nmaiti/smartswitchboard/README.md

# smartswitchboard

This repo contains all capsense design files
