nmaiti/smartswitchboard/Hardware/8ModuleBoard_vr2/Gerber Data/Transcode Report.txt

   ---- Transcoding 'F:\Honey Bee's\smartswitchboard\Hardware\8ModuleBoard_vr2\Gerber Data\8ModuleBoard_vr2.plc' ----   Fri Jun 24 12:41:39 2016

D10   --> D100
D11   --> D101
D12   --> D102
D13   --> D103
D14   --> D104
D15   --> D105
D16   --> D106
D17   --> D107
D18   --> D108
D19   --> D109
D20   --> D110
D21   --> D111
D22   --> D112
D23   --> D113
D24   --> D114
D25   --> D115
D26   --> D116
D27   --> D117
D28   --> D118
D29   --> D119
D30   --> D120
D31   --> D121
D32   --> D122
D33   --> D123
D34   --> D124
D35   --> D125
-----------------------------------------------------------------

   ---- Transcoding 'F:\Honey Bee's\smartswitchboard\Hardware\8ModuleBoard_vr2\Gerber Data\8ModuleBoard_vr2.pls' ----   Fri Jun 24 12:41:39 2016

D10   --> D126
D11   --> D127
D12   --> D128
D13   --> D129
D14   --> D130
D15   --> D131
D16   --> D132
D17   --> D133
D18   --> D134
D19   --> D135
D20   --> D136
-----------------------------------------------------------------

   ---- Transcoding 'F:\Honey Bee's\smartswitchboard\Hardware\8ModuleBoard_vr2\Gerber Data\8ModuleBoard_vr2.sol' ----   Fri Jun 24 12:41:39 2016

D17   --> D137
D18   --> D138
D19   --> D139
D20   --> D140
D21   --> D141
D22   --> D142
D23   --> D143
D24   --> D144
D25   --> D145
D26   --> D146
D27   --> D147
D28   --> D148
D29   --> D149
D30   --> D150
D31   --> D151
D32   --> D152
D33   --> D153
D34   --> D154
D35   --> D155
D36   --> D156
D37   --> D157
D38   --> D158
D39   --> D159
D40   --> D160
D42   --> D161
D43   --> D162
D44   --> D163
D45   --> D164
D47   --> D165
D48   --> D166
D50   --> D167
-----------------------------------------------------------------

   ---- Transcoding 'F:\Honey Bee's\smartswitchboard\Hardware\8ModuleBoard_vr2\Gerber Data\8ModuleBoard_vr2.stc' ----   Fri Jun 24 12:41:39 2016

D10   --> D168
D11   --> D169
D12   --> D170
D13   --> D171
D14   --> D172
D15   --> D173
D16   --> D174
D17   --> D175
D18   --> D176
D19   --> D177
D20   --> D178
D21   --> D179
D22   --> D180
D23   --> D181
D24   --> D182
D25   --> D183
D26   --> D184
D27   --> D185
D28   --> D186
D29   --> D187
D30   --> D188
D31   --> D189
D32   --> D190
D33   --> D191
D34   --> D192
D35   --> D193
D36   --> D194
D37   --> D195
D38   --> D196
D39   --> D197
D40   --> D198
D41   --> D199
D42   --> D200
-----------------------------------------------------------------

   ---- Transcoding 'F:\Honey Bee's\smartswitchboard\Hardware\8ModuleBoard_vr2\Gerber Data\8ModuleBoard_vr2.sts' ----   Fri Jun 24 12:41:39 2016

D10   --> D201
D11   --> D202
D12   --> D203
D13   --> D204
D14   --> D205
D15   --> D206
D16   --> D207
D17   --> D208
D18   --> D209
D19   --> D210
D20   --> D211
D21   --> D212
D22   --> D213
D23   --> D214
D24   --> D215
D25   --> D216
D26   --> D217
D27   --> D218
D28   --> D219
D29   --> D220
D30   --> D221
D31   --> D222
D32   --> D223
D33   --> D224
D34   --> D225
D35   --> D226
D36   --> D227
D37   --> D228
D38   --> D229
D39   --> D230
D40   --> D231
-----------------------------------------------------------------
