nmaiti/smartswitchboard/Hardware/BLE Certifications/CE-HM-10-11-V1.8.1.pdf

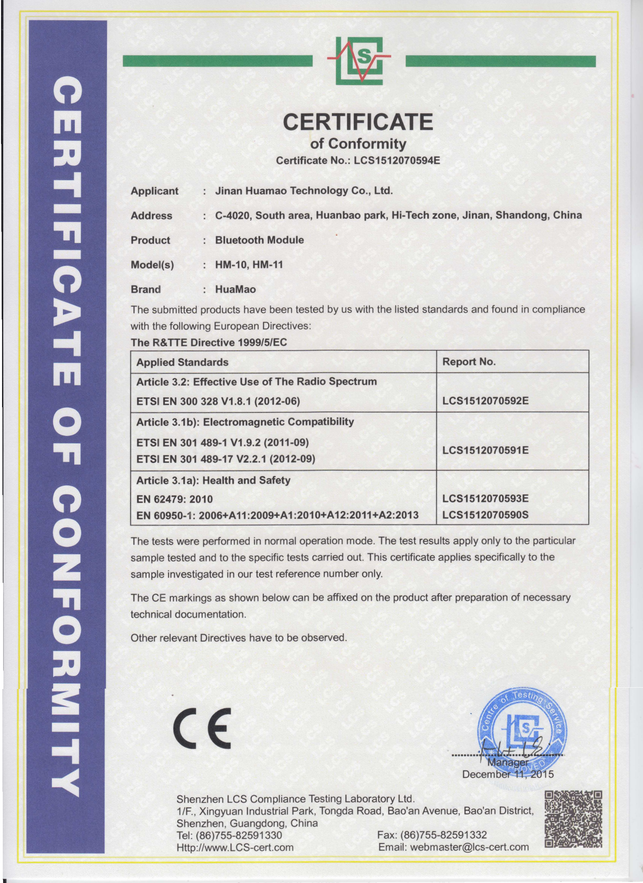
[picture p1: page 1]
