nmaiti/smartswitchboard/Hardware/BLE Certifications/CE-HM-12-13-V1.8.1.pdf

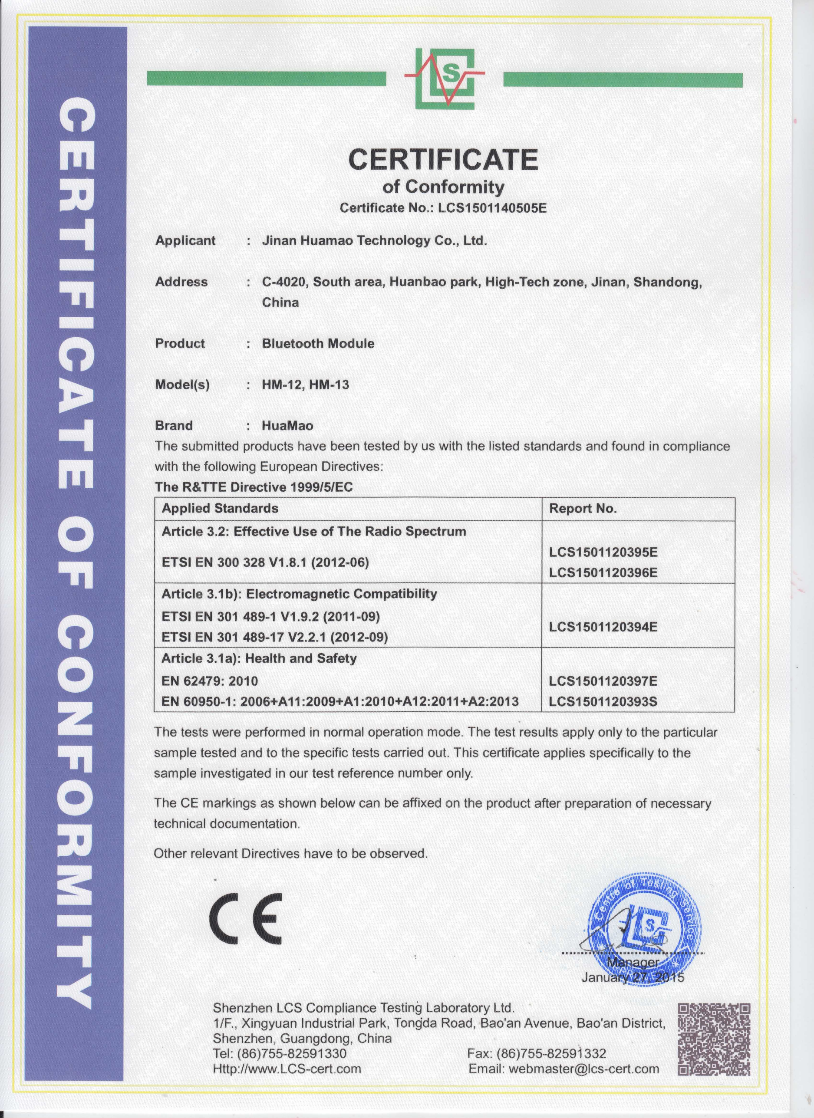
[picture p2: page 1]
