nmaiti/smartswitchboard/Hardware/BLE Certifications/RoHS_LCS1404180666S.pdf

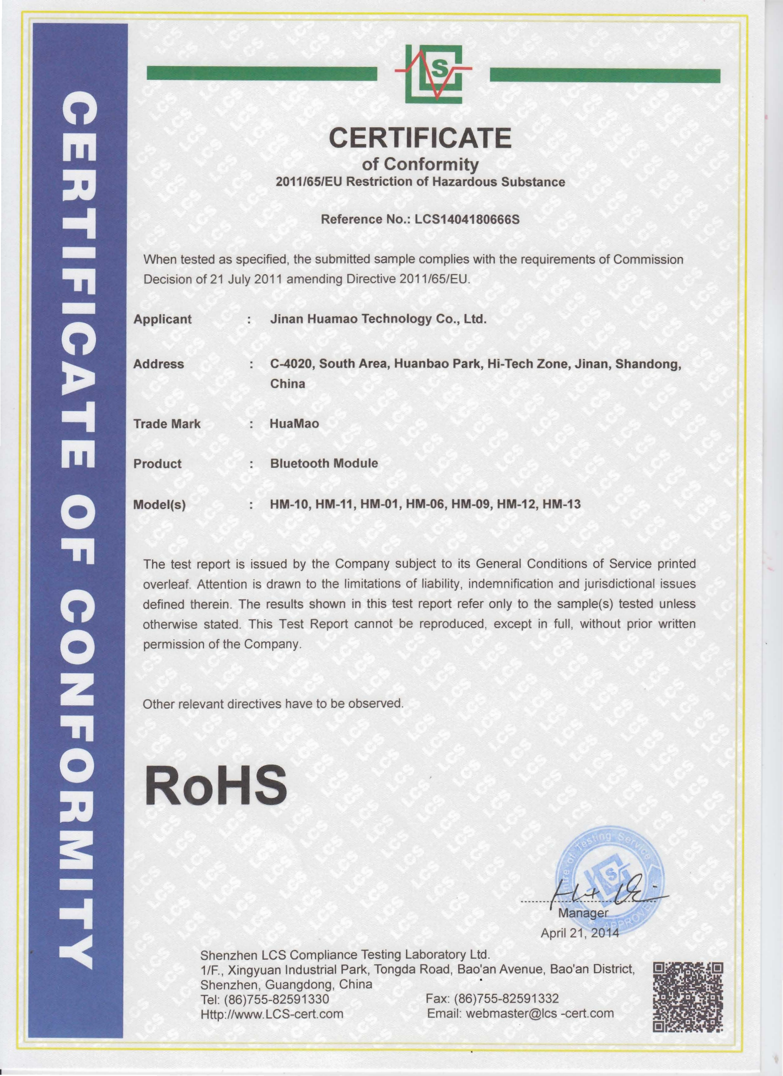
[picture p3: page 1]
