nmaiti/smartswitchboard/Hardware/BLE Certifications/CE-HM-10-11-V1.7.1.pdf

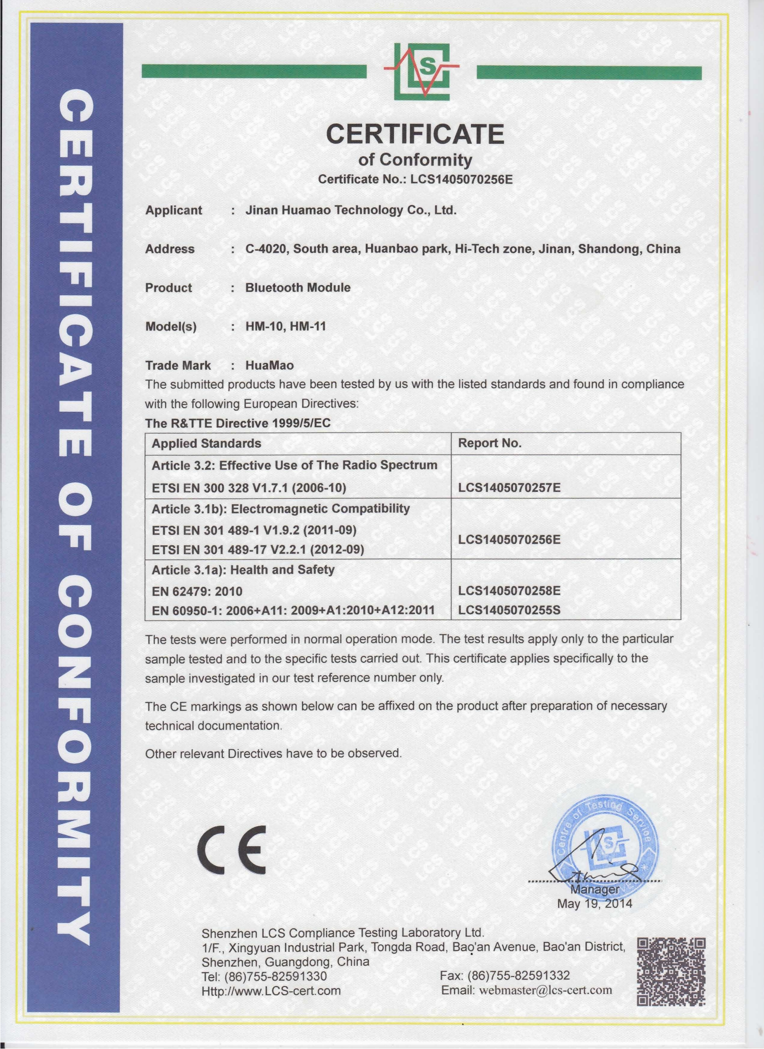
[picture p4: page 1]
