nmaiti/smartswitchboard/Hardware/8ModuleRealyProtoBoard/protoimg.png

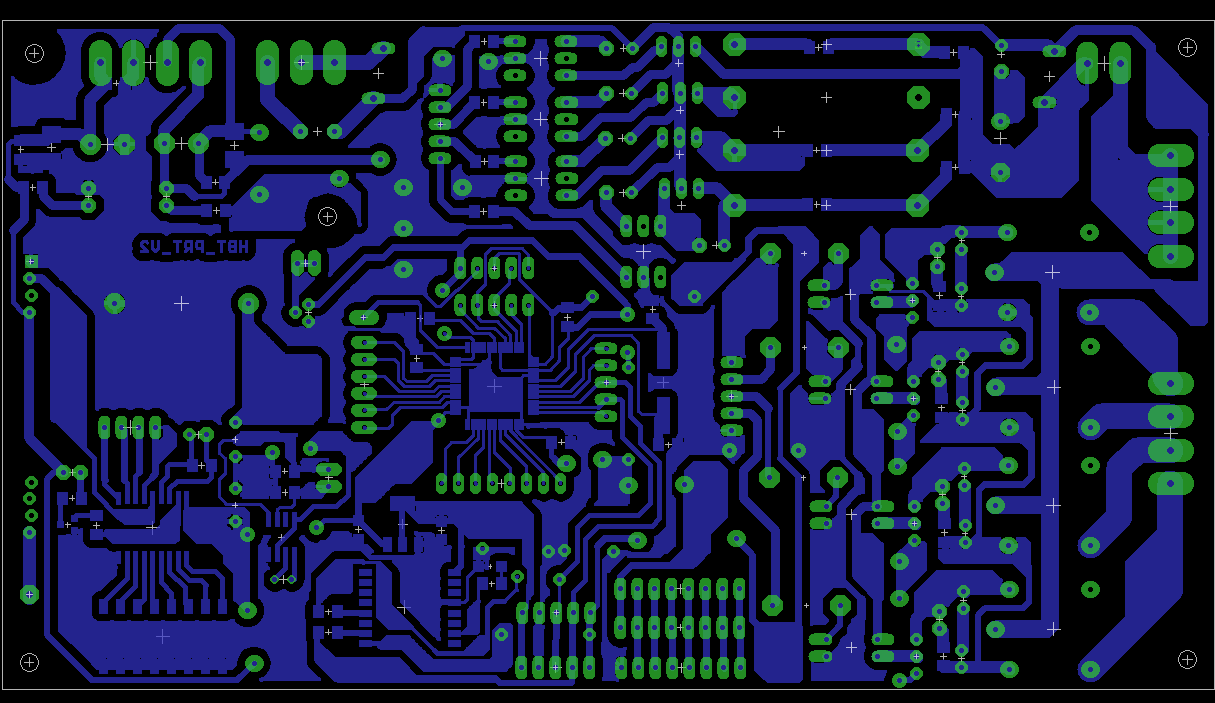
Hardware/8ModuleRealyProtoBoard/protoimg.png
