nmaiti/smartswitchboard/Hardware/Pi_MCU_Shield/pi3_gpio.png

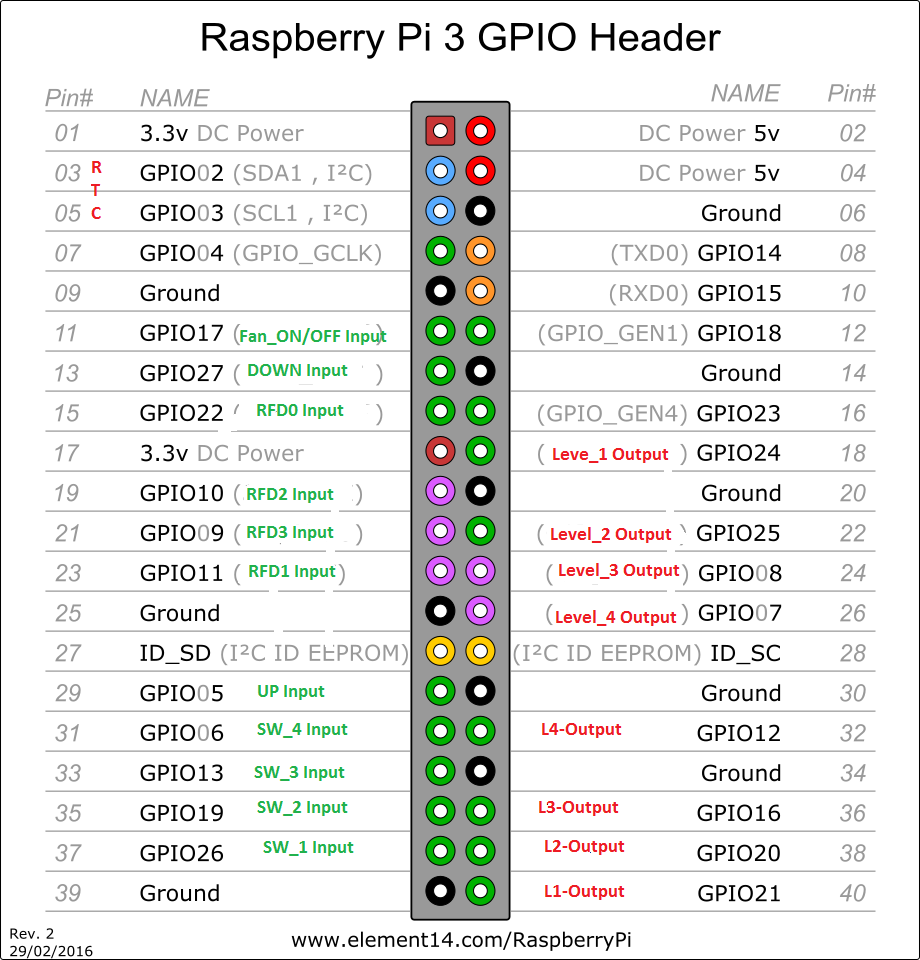
Hardware/Pi_MCU_Shield/pi3_gpio.png
