nmaiti/smartswitchboard/Hardware/Pi_MCU_Shield/Gerber Data/PiMCU_Shield_PurchaseOrder.docx

Purchase order

Contact Person : Vikas D. Gaikwad

Contact No : 08983537961

Email : vksgaikwad3@gmail.com

Purchase Order No: 09

PCB Name : PiMCU_Shield

Mask Color : Blue

No of Layers : Double Sided (2 Layer)

Dimensions of PCB : 58.76 mm X 42.33mm

Quantity : 5 Pcs

I am Vikas Gaikwad, on 11 July 2016, releasing the PCB purchase order to Circuit Systems India Ltd.
