nmaiti/smartswitchboard/Hardware/SMPS_Details/SMPS_BOM.xlsx

Sheet: BOM
 |  |  |  | Honey Bees Technologies
 | Project: | 5V @700mA and 12V @800mA SMPS
 | Design By: | K.S. Phulphagare (Wavelines)
 | Charges: | 8000/
 | Bill of Materials of SMPS
Sr.No | Part No | Value | Type | Quantity | Descriptions | Contact Person | Contact No | Vendor | Cost
1 | C1 | 0.1 OR 0.22uF/275VAC | X-Capacitor | 1
2 | C2 | 22uF/400 OR 450V | Electroytic | 1 |  |  |  | TrioElectronics | 10
3 | C3
4 | C4 | 4.7nF/1kV | Ceramic | 1
5 | C5 | 47uF/50V | Electroytic | 1 |  |  |  | Trio Electronics | 2
6 | C6 | 1uF/50V | Electroytic | 1 |  |  |  | Trio Electronics | 2
7 | C7 | 47uF/50V | Electroytic | 1 |  |  |  | Trio Electronics | 2
8 | C8 | 0.1uF/50V | Ceramic | 1 |  |  |  | In Stock
9 | C9 | 470uF/16V | Electroytic | 1 |  |  |  | Trio Electronics | 10
10 | C10 | 1000 OR 2200 uF/16V | Electroytic | 1 |  |  |  | Trio Electronics | 25
11 | C11 | 1000 uF/25V | Electroytic | 1 |  |  |  | Trio Electronics | 15
12 | C12 | 470uF/25V | Electroytic | 1 |  |  |  | In Stock
13 | C13 | 2.2nF/1kV | Ceramic | 1
14 | D1 | UF4007 | Diode(TH) | 1 |  |  |  | Tri Electronics | 1
15 | D2 | 1N4148 | Diode(TH) | 1 |  |  |  | Tri Electronics | 1
16 | D3 | 1N5822 | Diode(TH) | 1 | Shokly Diode
17 | D4 | MUR420 | Diode(TH) | 1 | Fast Recovery Diode
18 | SMD Bridge | DDF105 | SMD Bridge | 1 | 1A SMD Bridge
19 | TOP244Y OR 245Y |  | Top Switch IC | 1 |  | Rajiv,Pioneer,Turnwal Electronics |  | Pioneer Electronics | 75
20 | PC817 | OptoIsolator | SMD package | 1 |  | Rajiv |  | Tro Electronics | 10
21 | TL431 |  | 3-Pin IC(Transistor) | 1 |  | Rajiv
22 | R1 | 4.7MOhm | Resistor | 1 |  |  |  | Trio Electronics | 1
23 | R2 | 9.1KOhm | SMD | 1
24 | R3 | 1MOhm | SMD | 1
25 | R4 | 1MOhm | SMD | 1
26 | R5 | 68K | TH | 1 |  |  |  | Trio Electronics | 2
27 | R6 | 6.8Ohm | SMD | 1
28 | R7
29 | R8
30 | R9 | 9.1KOhm | SMD | 1
31 | R10 | 9.1KOhm | SMD | 1
32 | CMR | 5uH 10.5VCore | 32 SWG copper wire | 1 | CMR transformer
33 | L1 | 10uH | 10X12 Drum(28-SWG) | 1 |  |  |  | Varsha Electronics | 3
34 | L2 | 3.3uH | 6X8 Drum (28-SWG) | 1 |  |  |  | Varsha Electronics | 2
35 | NTC | 5Ohm/9mm | NTC | 1
36 | MOV | 7mm/275V | MOV | 1
37 | Heat Sink with Nut bolts and Mica |  |  | 1 |  | Jewel Enterprises | Soba Market near Pasoda vithoba Mandir
38 | PCB | 60X40 MM |  | 1
39 | Glue
40 | Transformer Design Details: |  |  |  |  | Inductrionicx | 9226564727(Paithankar)
 |  |  |  | Start Pin | End Pin
 | Primary Coil Inductance | 495uH
 |  | 56 Turns (30-SWG) |  | 2 | 1
 | Secondary
 | 5V Coil | 4 Turns (26-SWG) |  | 6 | 5
 | 12V Coil | 8 Turns (26-SWG) |  | 8 | 7
 | Feedback Coil
 | 7 Turns (30SWG) |  |  | 4 | 3
 | Core Size:
 |  | E25/9/16
 | Note: Please note that Starting points are very important while designing a Transformer
 | Note: Here 1pcs of SMPS cost aproximately around 240

Sheet: Sources
 |  |  |  | Honey Bees Technologies
Sr. No | Name | Contact | Address | Type of Compontnts
1 | Rajiv Electronics | 020 24494150/020 24477218 |  | Resistors, Capacitors, Optocouplers, TL431
2 | UniStar Enterprise |  |  | Resistors, Capacitors, Optocouplers, TL431
3 | Trinity |  |  | Resistors, Capacitors, Optocouplers, TL431
4 | Turnwal Electronics |  |  | Resistors, Capacitors, Optocouplers, TL431
5 | Pioneer Electronics |  |  | Resistors, Capacitors, Optocouplers, TL431
6 | Jewel Enterprises |  | Soba Market (Near Pasoda Vithoba Mandir) | Heat Sink
7 | Bhosale |  | Kharadi | PCB design
8 | Varsha Electronics | 9422084984 | InFront of Pioneer Electronics
9 | UniStar Enterprise | 020 24480647 | DakshinMukhi Maruti Samor, Dusra Majala, near Prabhat Tockies
10 | Inductronicx | 9226564727(Paithankar) | Gavkos Maruti Javal, Kasba peth, near Kamala nehuru hospital | Inductors and Transformers
11 | Trinity | 020 24490156 | Soba Market ,Near Pasoda Vithoba Mandir, First Floor
12 | Turnwal Electronics | 020 24463819 | Near AhilyaDevi High school neighbour road
13 | Pioneer Electronics | 020 24495336/020 24458257 | near pasoda vithoba mandir ABC
