nmaiti/smartswitchboard/Hardware/BOM/CompInStock.xlsx

 |  |  | Honey Bees Technologies
Sr.No | Part Name | Device Value | Package | In Stock | Available Quantity | Approx. Cost(Rs.)
 |  |  |  |  |  | (Mumbai) | Rajiv Elec. | IPC Pune
1 | Resistors | 560R | TH | Yes | 100 | 0.5 | 0.5 | 0.25
 |  | 470R | TH | Yes | 95 | 0.5 | 0.5 | 0.25
 |  | 33E/1W | TH | Yes | 100 |  |  | 1
 |  | 39E/2W | TH | Yes | 50 |  |  | 2
 |  | 4K7 | Arry | Yes | 50 |  |  | 2
 |  | 22E | 1206 | Yes | 98 | 0.25 | 0.5 | 0.25
 |  | 470E | 1206 | Yes | 90 | 0.25 | 0.5 | 0.25
 |  | 1K | 1206 | Yes | 90 | 0.25 | 0.5 | 0.25
 |  | 10K | 1206 | Yes | 90 | 0.25 | 0.5 | 0.25
 |  | 220R | 1206 | Yes | 100 |  |  | 0.25
 |  | 2.2E | 1206 | Yes | 100 |  |  | 0.25
 |  | 560R | 1206 | Yes | 100 |  |  | 0.25
 |  | 22K | 1206 | Yes | 100 |  |  | 0.25
 |  | 220K | 1206 | Yes | 100 |  |  | 0.25
2 | Capacitors | 0.1uF | 1206 | Yes | 95 | 1 | 1
 |  | 1uF | 1206 | Yes | 95 | 1 | 2
 |  | 10uF(Tantalum) | 1206 | Yes | 95 | 1 | 2
 |  | 18pF | 1206 | Yes | 98 | 1 | 1
 |  | 0.01uF/400V | PTH | Yes | 20 |  |  | 3
 |  | 220nF/250V~ | PTH | Yes | 30 |  |  | 4.5
 |  | 10uF/35V (Tantalum) | 3216 | Yes | 100 |  |  | 7
 |  | 470uF/25V | PTH | Yes | 50 |  |  | 3.5
 |  | 2.2uF/63V | PTH | Yes | 50 |  |  | 0.7
3 | Triac | BTB16 | TO220 | Yes | 19 | 21 | 26 | 28
4 | MOV | 300V | TH | Yes | 20 | 5 | 7
5 | Opto-Isolator | MOC3083 | DIP | Yes | 19 | 18 | 20
 |  | MOC3023 | DIP | Yes | 20 |  |  | 11.5
 |  | 4N35 | DIP | Yes | 20 |  |  | 5.5
6 | IR Receiver | PNA460XM | TSOP | Yes | 9 | 20 | 25
7 | 3.3V Regulator | LM1117 | SOT-23-5 | Yes | 9 | 5
8 | Crystal | 16MHz | HC49UP | Yes | 9 | 8 | 8
9 | LEDs | Red | 1206 | Yes | 99 | 2 | 2
 |  | Green | 1206 | Yes | 95 | 2 | 4
 |  | Blue | 1206 | Yes | 99 | 2 | 2
10 | Microcontroller | Atmega32u4 | TQFP | Yes | 7 | 250
11 | Deki Capacitors
 |  | 1uF/250VAC |  | Yes | 4 | 5.33 |  | 5
 |  | 2.2uF/250VAC |  | Yes | 4 | 5.33 |  | 6
 |  | 3.3uF/250VAC |  | Yes | 4 | 5.33 |  | 7
12 | Micro-USB B |  |  | Yes | 1 | 40 | 25
 | USB-A Female |  |  | Yes | 10 |  |  | 25
13 | Bluetooth Module | HM-11 |  | Yes | 1 | 420
14 | Concealed Boxes | 4-Module |  | Yes | 1 | 46.5
 |  | 6-Module |  | Yes | 1 | 63
 |  | 8/9-Module |  | Yes | 1 | 82.5
 |  | 8-Module Square |  | Yes | 1 | 82.5
 |  | 12-Module |  | Yes | 1 | 101.5
 |  | 18-Module Square |  | Yes | 1 | 120
15 | PBT Connectors
 |  | 2-Pin | Regular | Yes | 50 |  |  | 6.6
 |  | 3-Pin | Regular | Yes | 10 |  |  | 9.5
 |  | 2-Pin | Right Angle | Yes | 10 |  |  | 9
16 | Power Supply | 5V/2A | (EDR) Adapter | Yes | 3 | 190
17 | PolyFuse | 1A/60V | PTH | Yes | 10 |  |  | 12
18 | MOSFET | IRF840 |  | Yes | 20 |  |  | 22
19 | Diode
 |  | 1N4007 | PTH | Yes | 100 |  |  | 0.5
 |  | BZX55C | 10V Zener | Yes | 20 |  |  | 0.75
 |  | DB107 | Diode Rectifier | Yes | 30 |  |  | 5.5
 |  | SMBJ8.2 |  | Yes | 10 |  | 9
20 | Reliment Connectors
 |  | 3-Pin (F) | Both Female | Yes | 30 |  |  | 7.2
 |  | 5-Pin (F) | Both Female | Yes | 30 |  |  | 12
 |  | 8-Pin (F) | Both Female | Yes | 30 |  |  | 17.3
 |  | 3-Pin (M) |  | Yes | 60 |  |  | 1.1
 |  | 5-Pin (M) |  | Yes | 60 |  |  | 1.8
 |  | 8-Pin (M) |  | Yes | 60 |  |  | 2.9
21
