nmaiti/smartswitchboard/Hardware/8ModuleRealyProtoBoard/autocadview.dxf

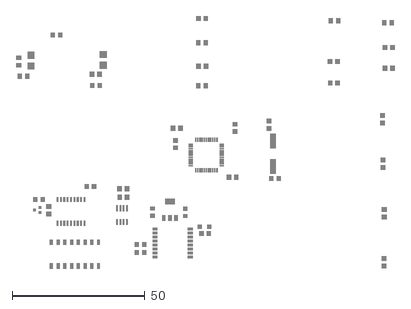
[picture p8: CAD file, 2016-08-19]
Hardware/8ModuleRealyProtoBoard/autocadview.dxf
142.7 x 95.3
