nmaiti/smartswitchboard/Hardware/4Key1SliderCapsenseDesign/4key1SliderCapsenseDesign.pdf

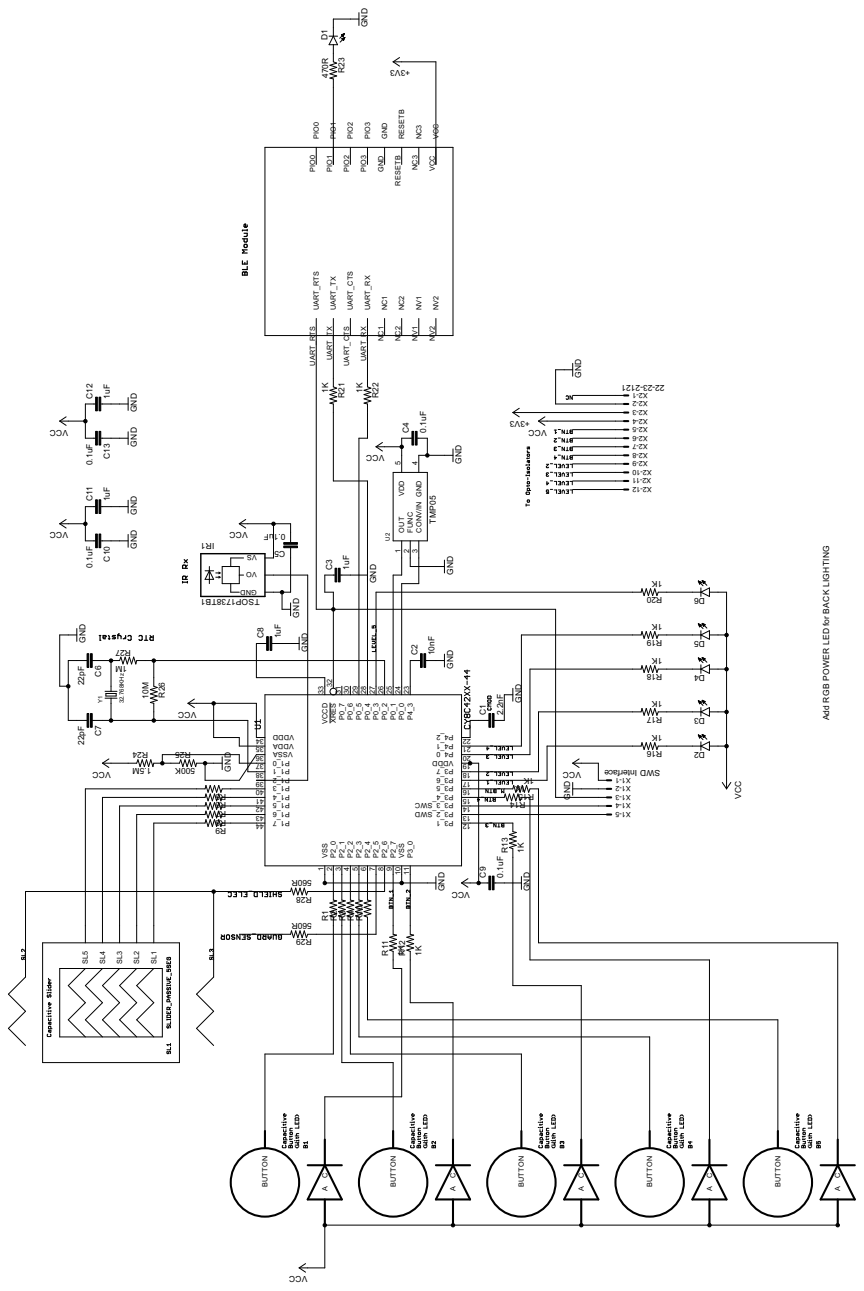
[picture p9: page 1]

NC3 NC3 RESETB RESETB GND GND

0.1uF GND GND GND GND

WER LED for BACK LIGHTING
