nmaiti/smartswitchboard/Hardware/Pi_MCU_Backend/pi_mcu_powerBoard.pdf

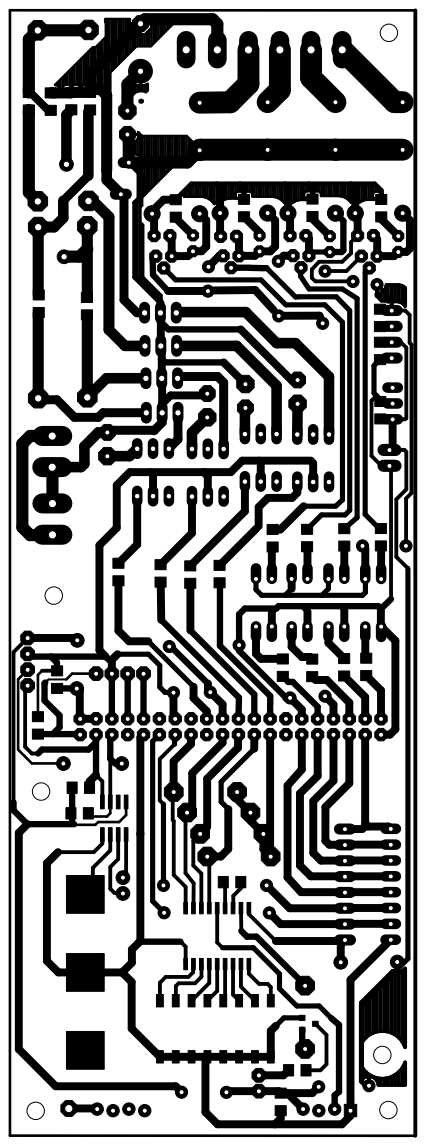
[picture p10: page 1]
