nmaiti/smartswitchboard/Hardware/Pi_MCU_Backend/pi_mcu_powerBoard1.pdf

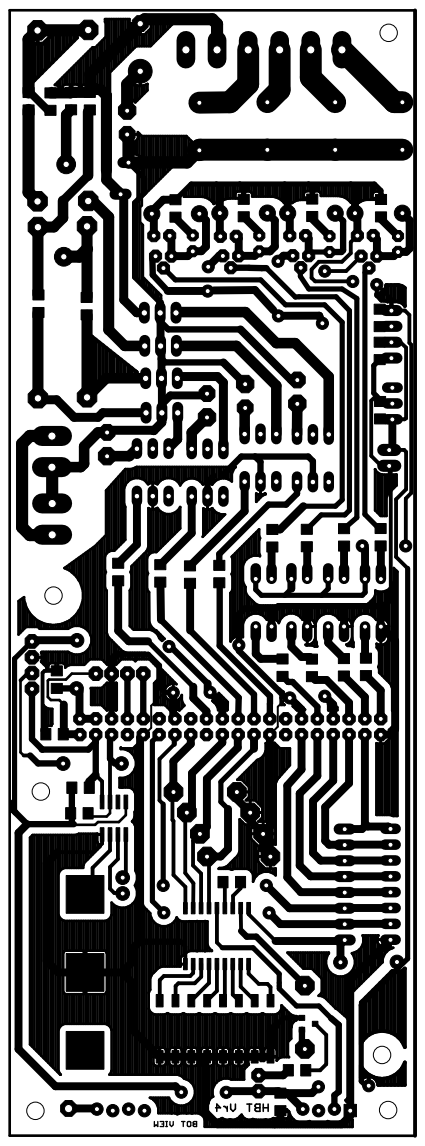
[picture p11: page 1]
