nmaiti/smartswitchboard/Hardware/Pi_MCU_Backend/backend_main.pdf

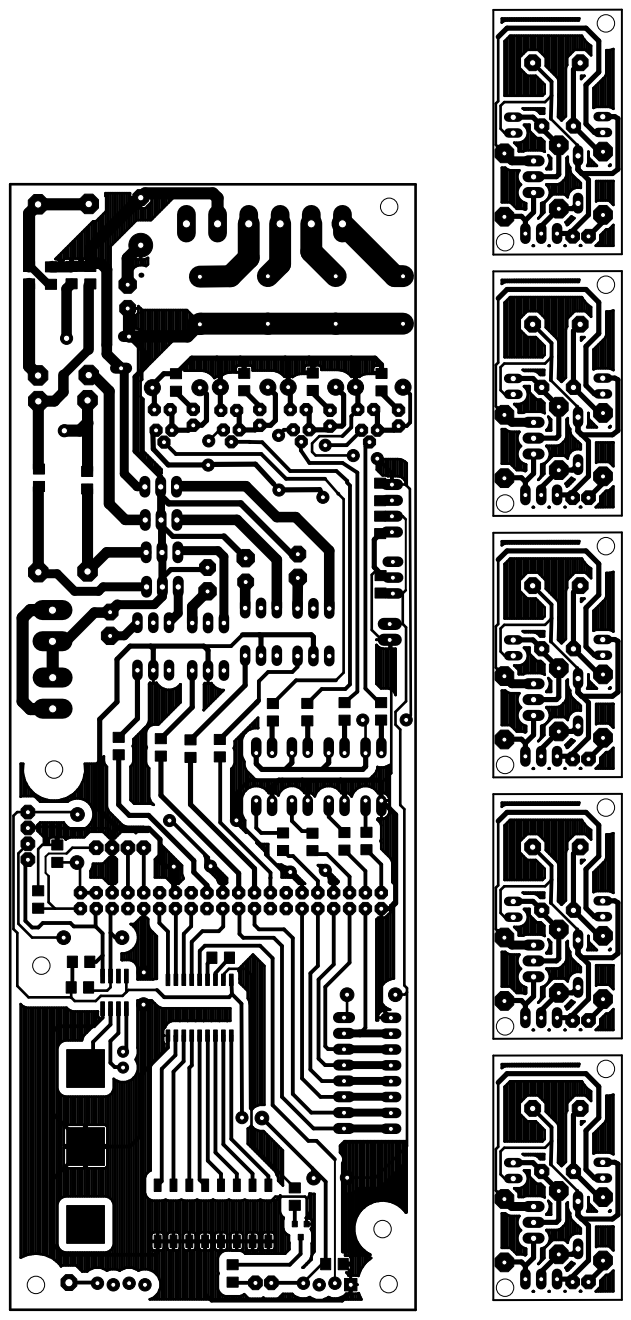
[picture p12: page 1]
