nmaiti/smartswitchboard/Hardware/Pi_MCU_Backend/pi_mcu_powerOutline.pdf

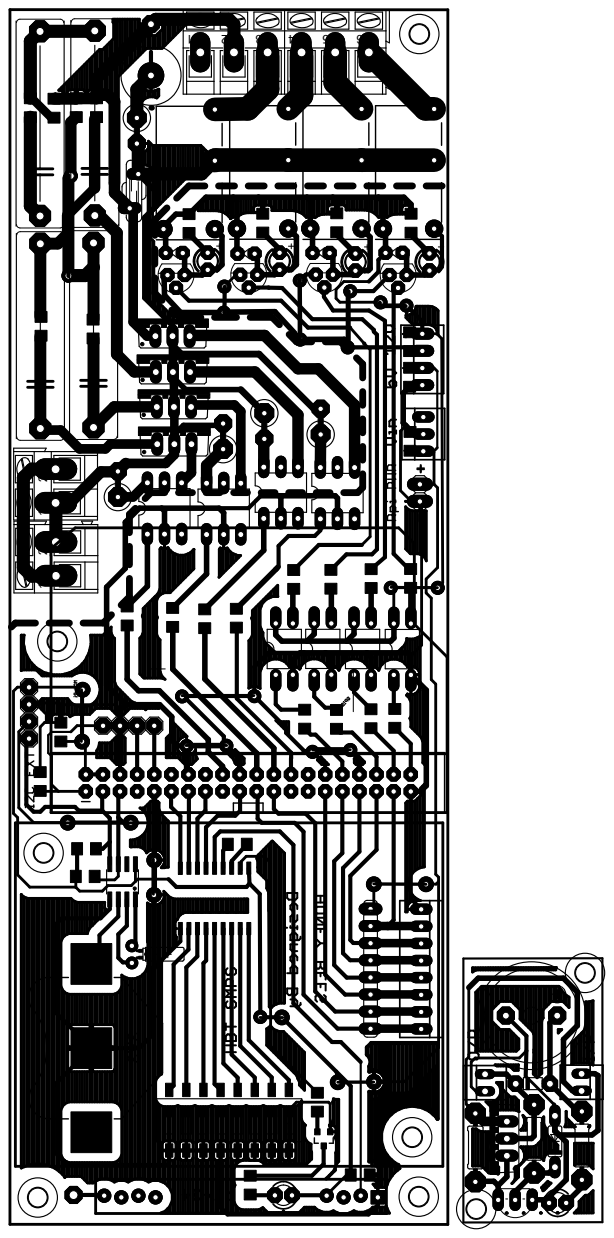
[picture p13: page 1]
