nmaiti/smartswitchboard/Hardware/8ModuleRealyProtoBoard/Layout_centerV2.pdf

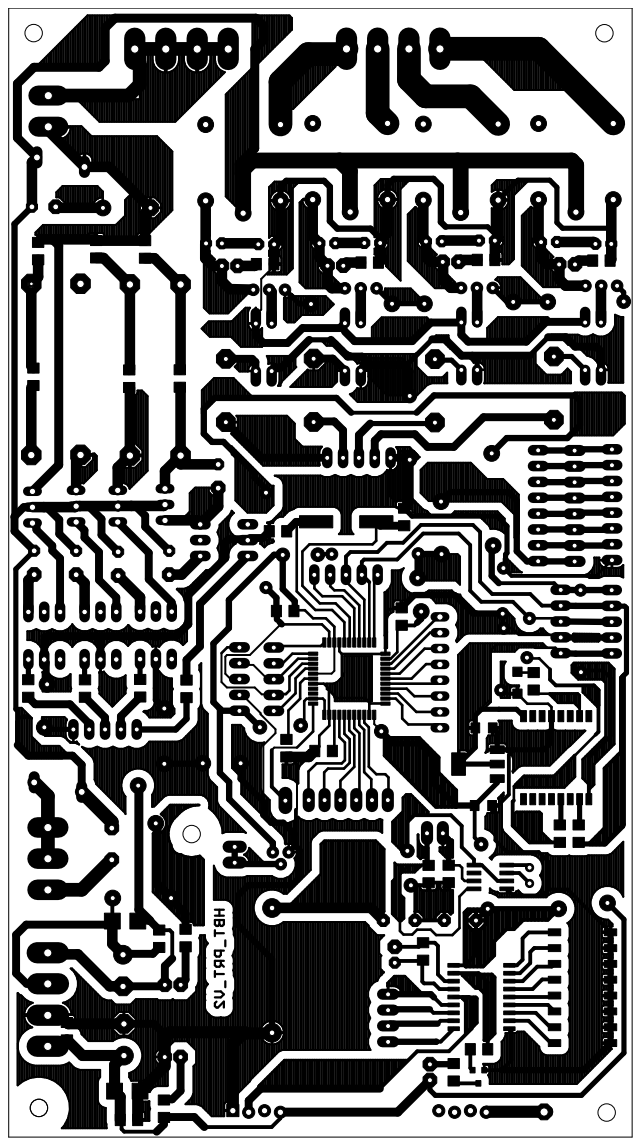
[picture p14: page 1]
