nmaiti/smartswitchboard/Hardware/8ModuleRealyProtoBoard/Layout_protoV2.pdf

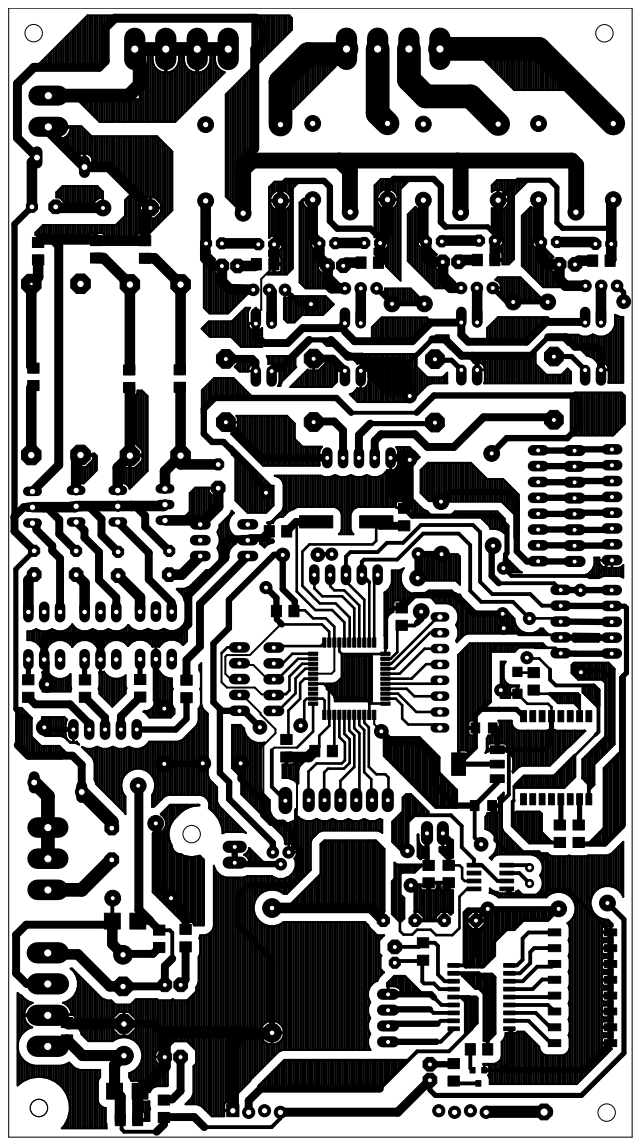
[picture p15: page 1]
