nmaiti/smartswitchboard/Hardware/8ModuleRealyProtoBoard/protoLayout.pdf

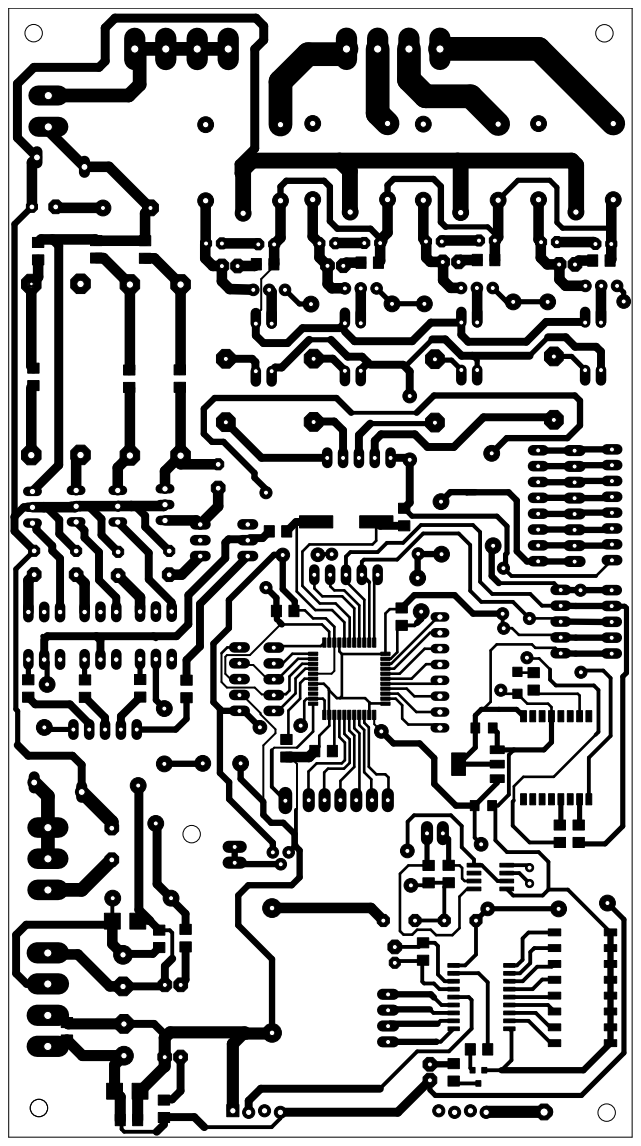
[picture p16: page 1]
