nmaiti/smartswitchboard/Hardware/8ModuleRealyProtoBoard/protoSilk.pdf

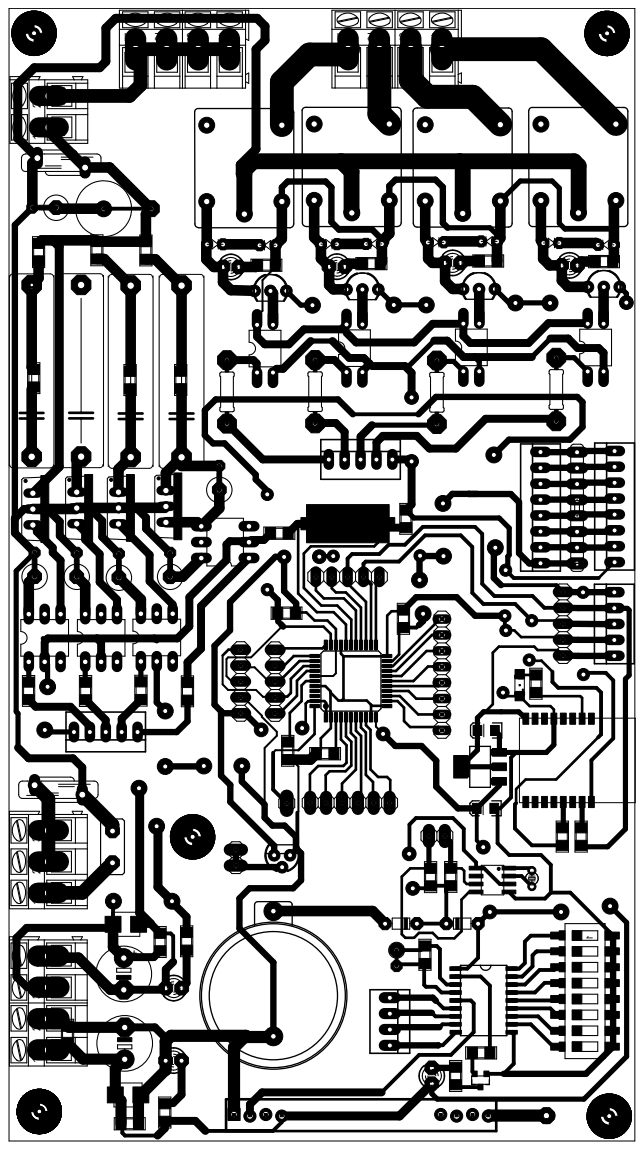
[picture p17: page 1]
