nmaiti/smartswitchboard/Hardware/BLE Certifications/FCC Grant_2AB6YHM-1011.pdf

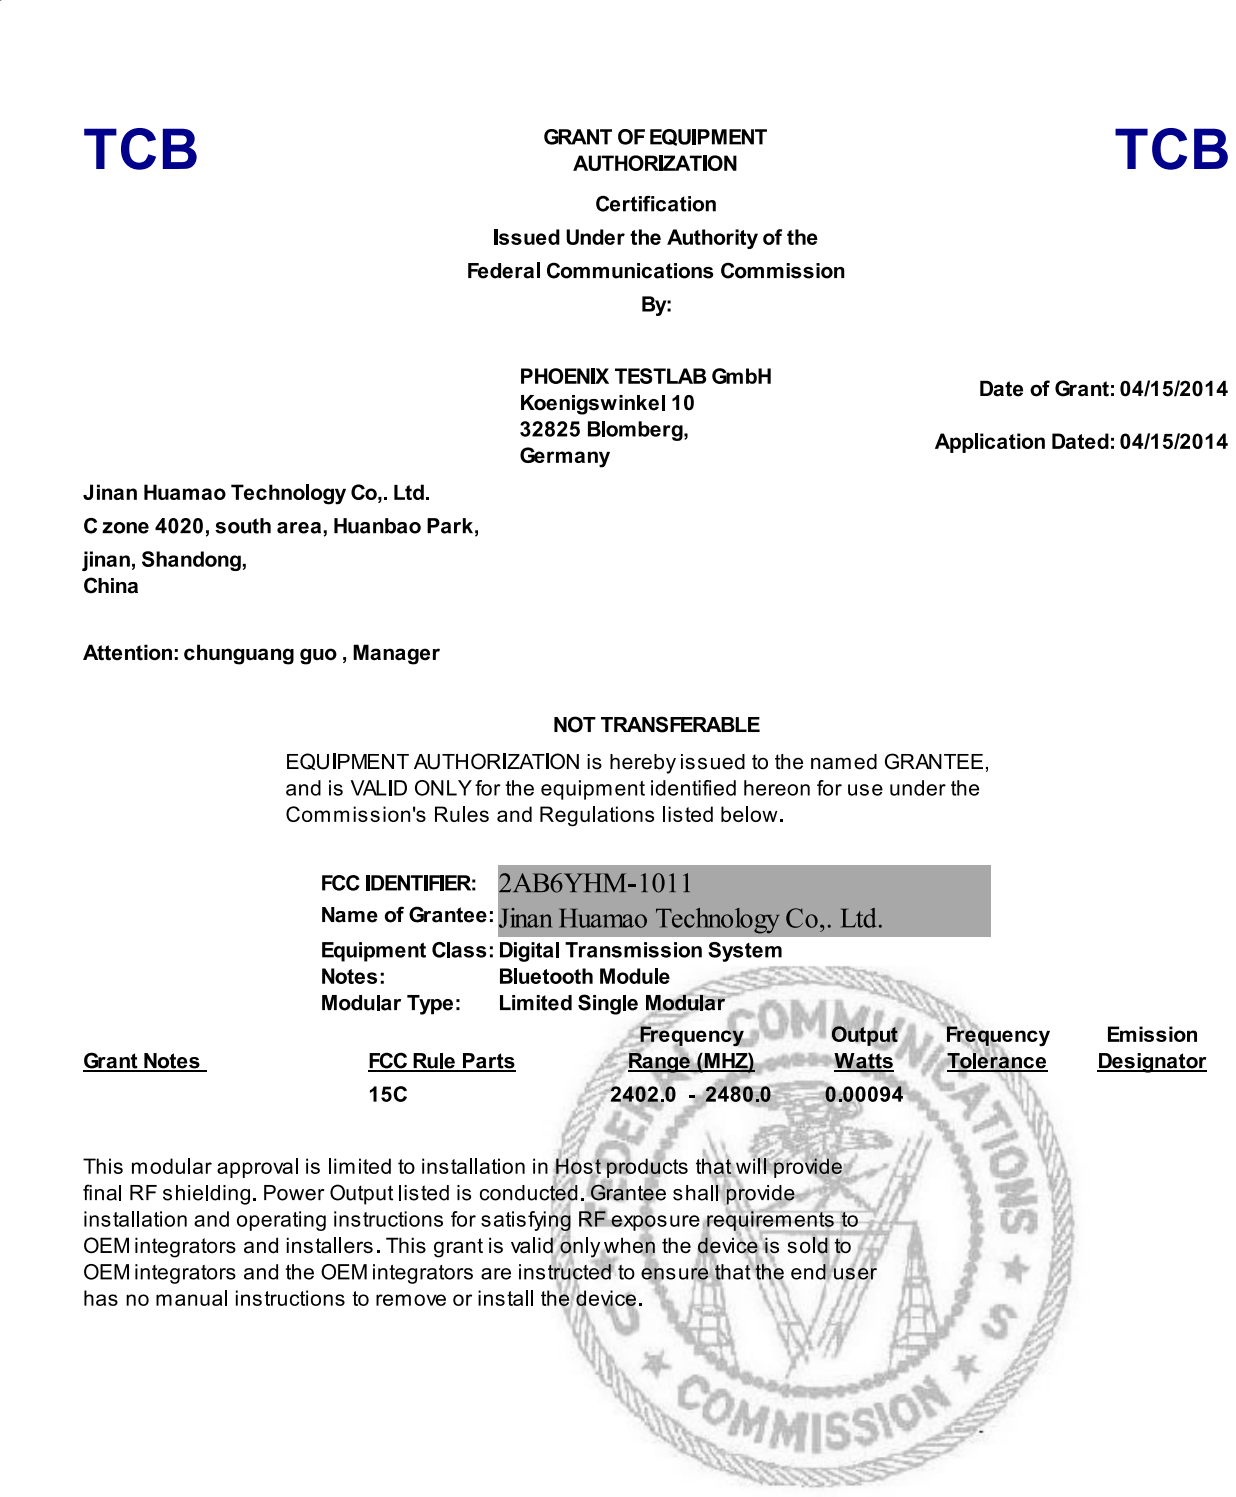
[picture p18: page 1]
