nmaiti/smartswitchboard/Hardware/8ModuleBoard_vr2/8ModuleBoard_vr2.pdf

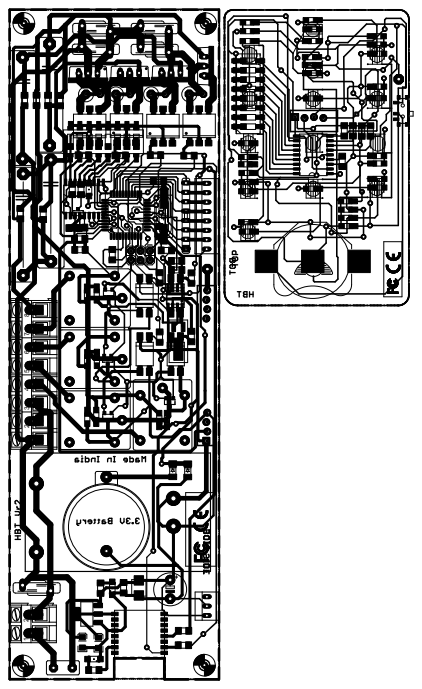
[picture p19: page 1]
