nmaiti/smartswitchboard/Hardware/8ModuleBoard_vr2/footprint.pdf

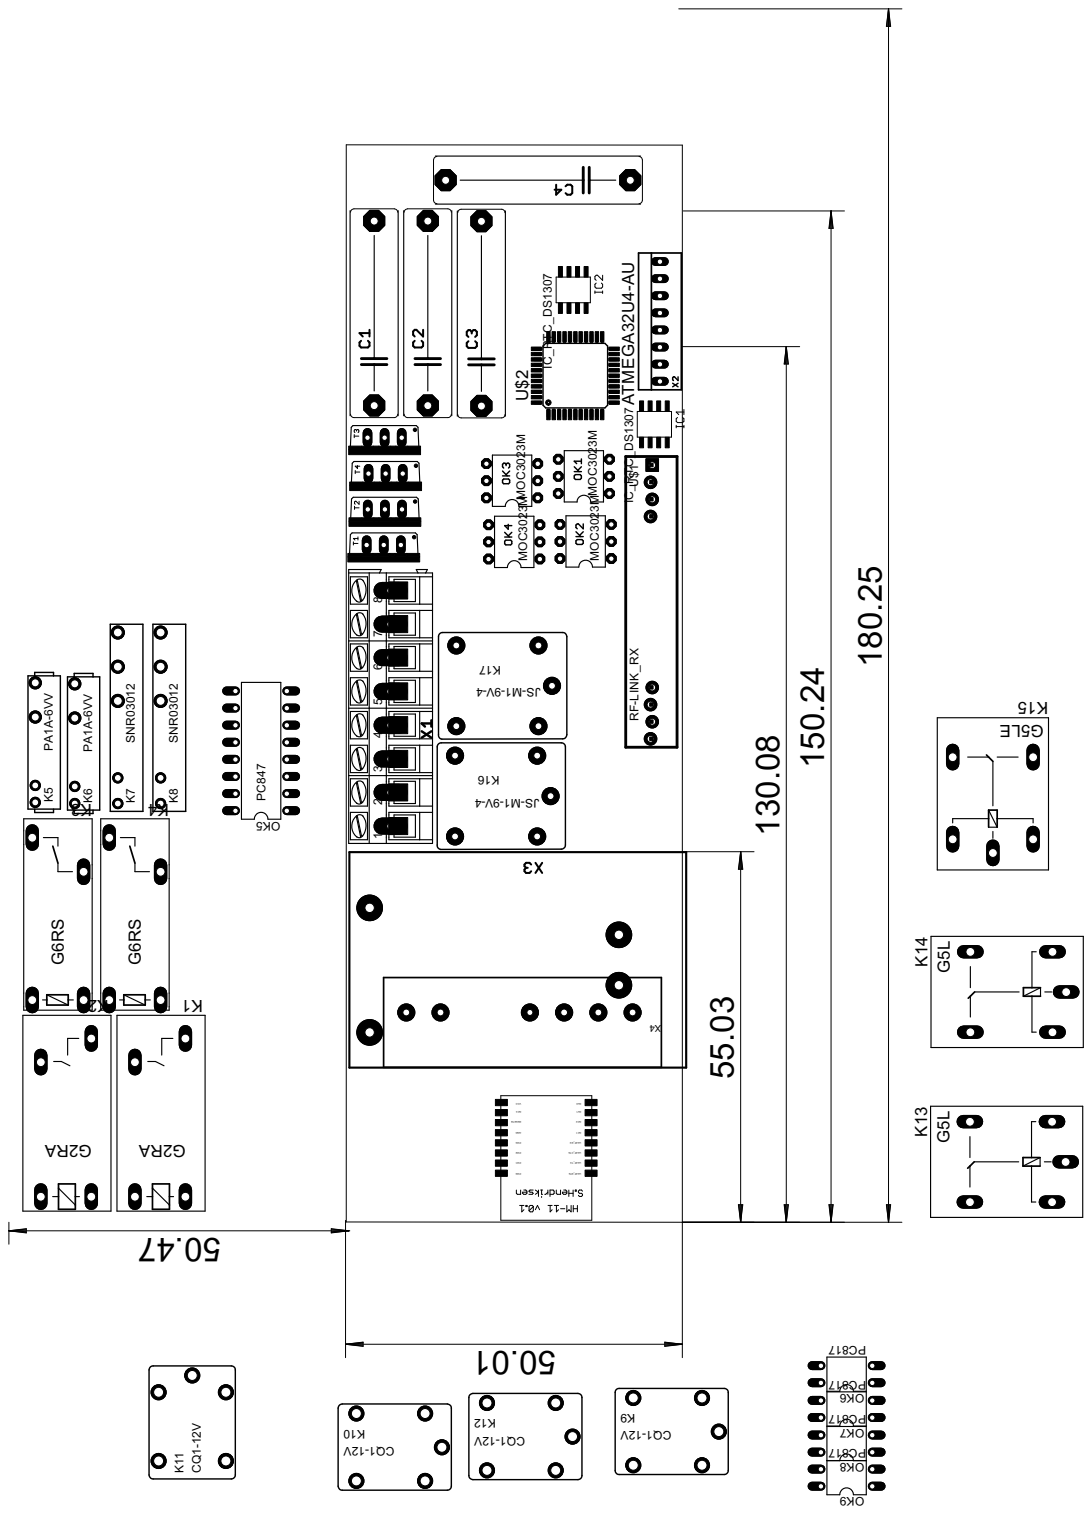
[picture p20: page 1]

1 2 3 4 5 6 7 8 2K 1K K3K 4K 5 K6K7K8 9K 01K K11 21K U$1 U$2 XT_TRAU STR_TRAU ST C_TRAU XR_TRAU 1 CN 2 CN 1 VN CCV 2 VN 3 CN BTESER DNG 3 OI P 2 OI P 1 OI P 0 OI P 5KO 6KO 7KO 8KO 9KO 4X IC_RTC_DS1307 IC_RTC_DS1307 K13 K14 51K 61K 71K AR2 G AR2 G G6RS G6RS PA1A-6VV PA1A-6VV SNR03012 SNR03012 V21- 1 QC V21- 1 QC CQ1-12VV21- 1 QC RF-LINK_RX ATMEGA32U4-AU MOC3023M MOC3023 MM OC3023M MOC3023M PC847 718 CP 718 CP 718 CP 718 CP G5L G5L EL5 G 4- V9- 1 M- SJ 4- V9- 1 M- SJ 74. 05 130.08 10. 05 55.03 150.24180.25
