nmaiti/smartswitchboard/Hardware/LedflikerremoverCct/ledflikerless.pdf

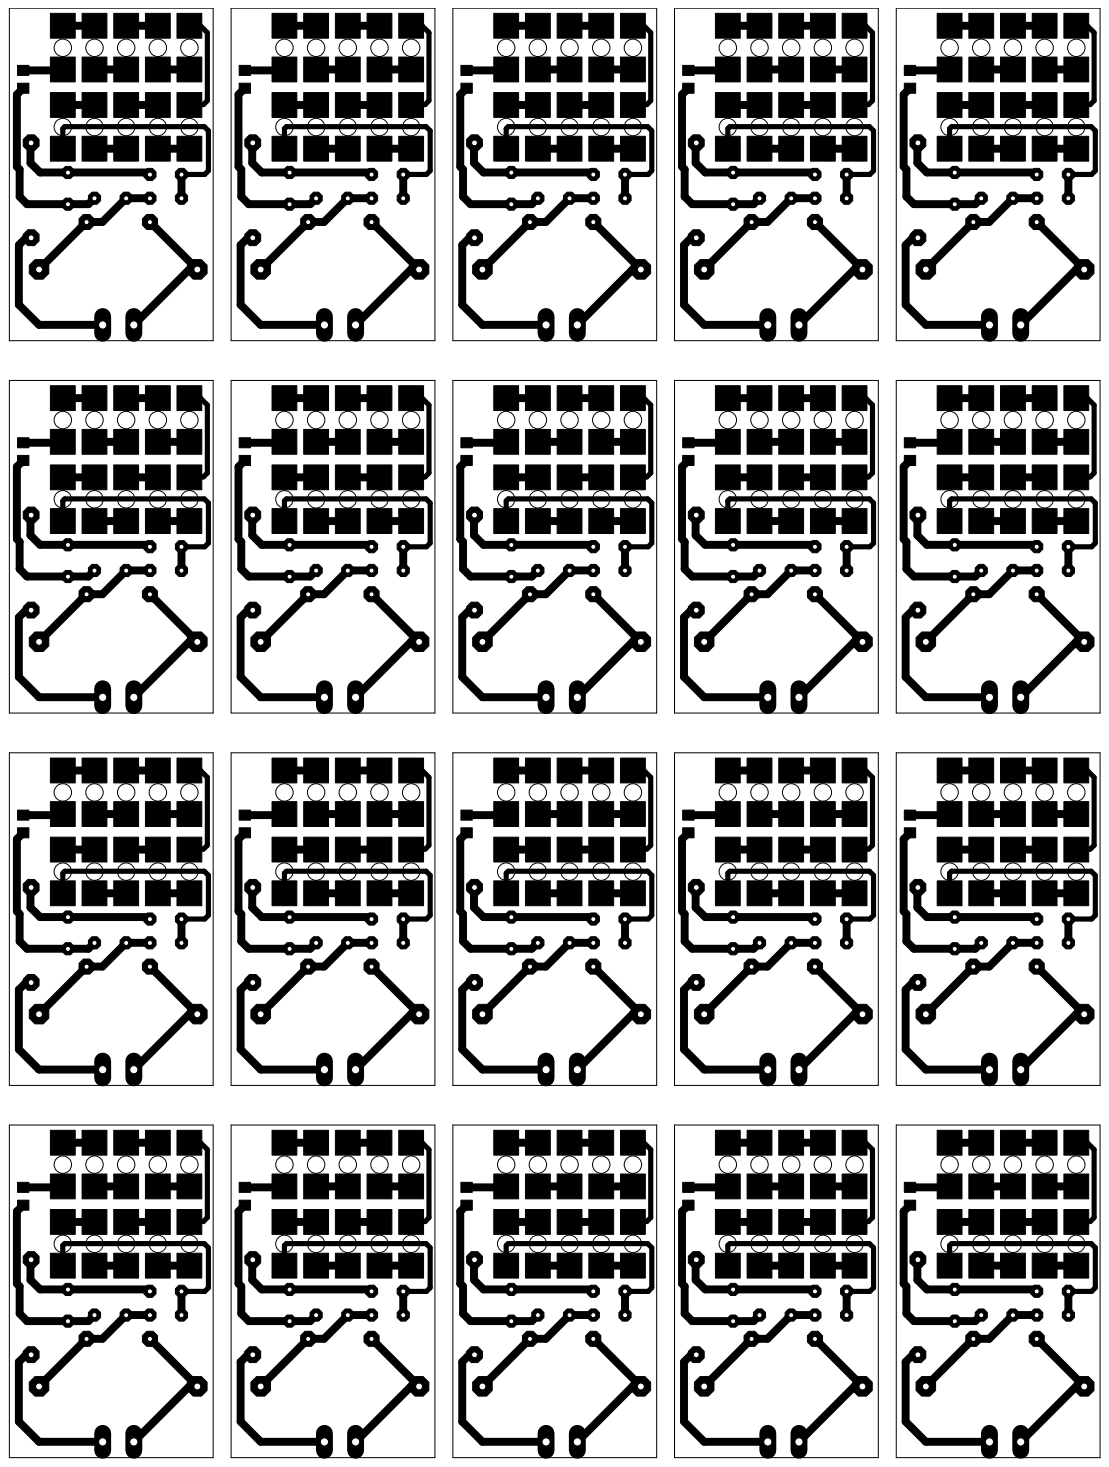
[picture p21: page 1]
