nmaiti/smartswitchboard/Hardware/RF434/hRemote.pdf

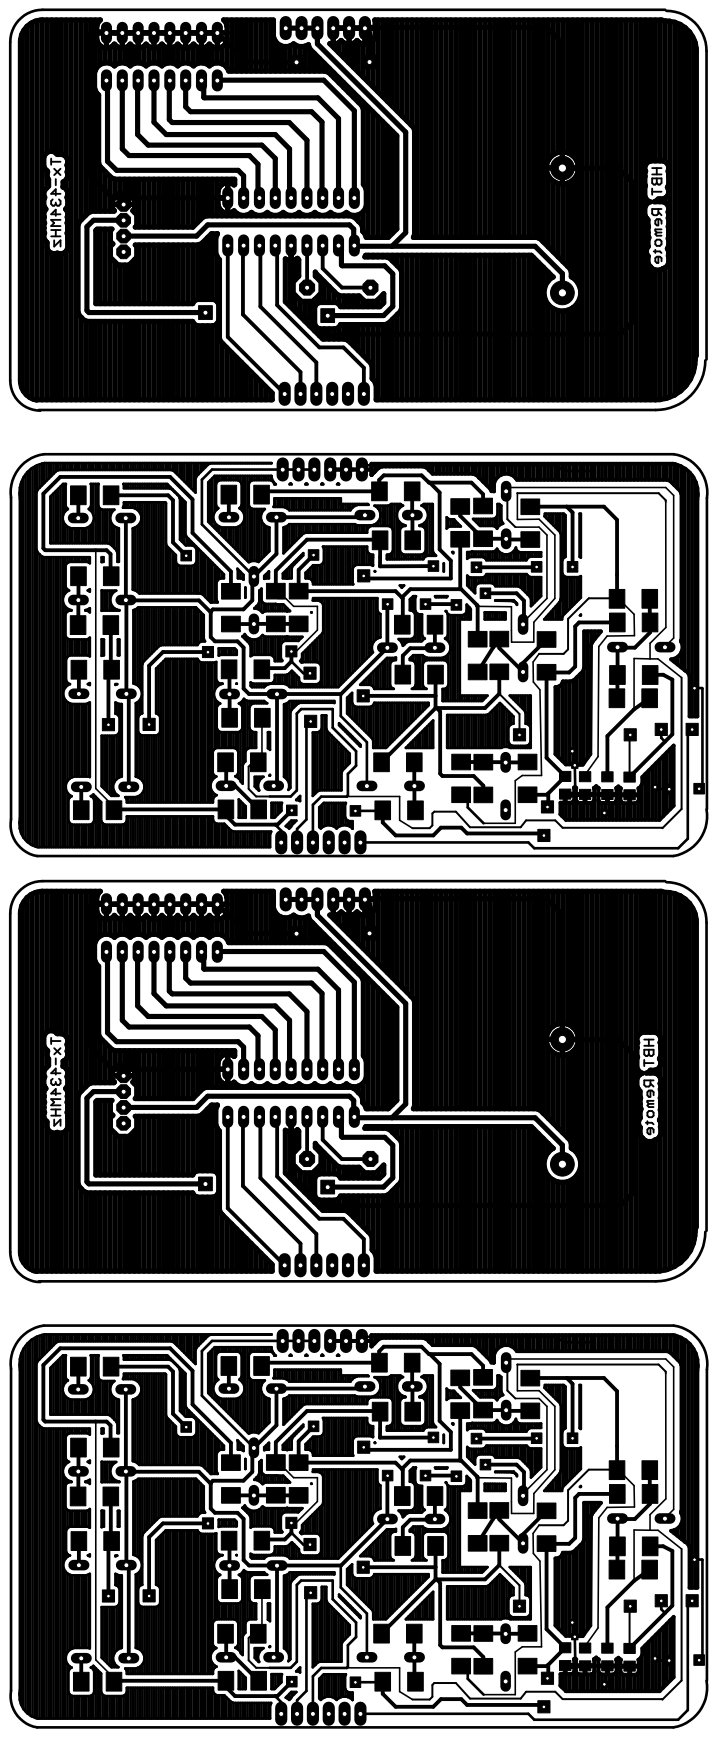
[picture p22: page 1]
