nmaiti/smartswitchboard/Hardware/8ModuleBoard/8ModuleBoardBot.pdf

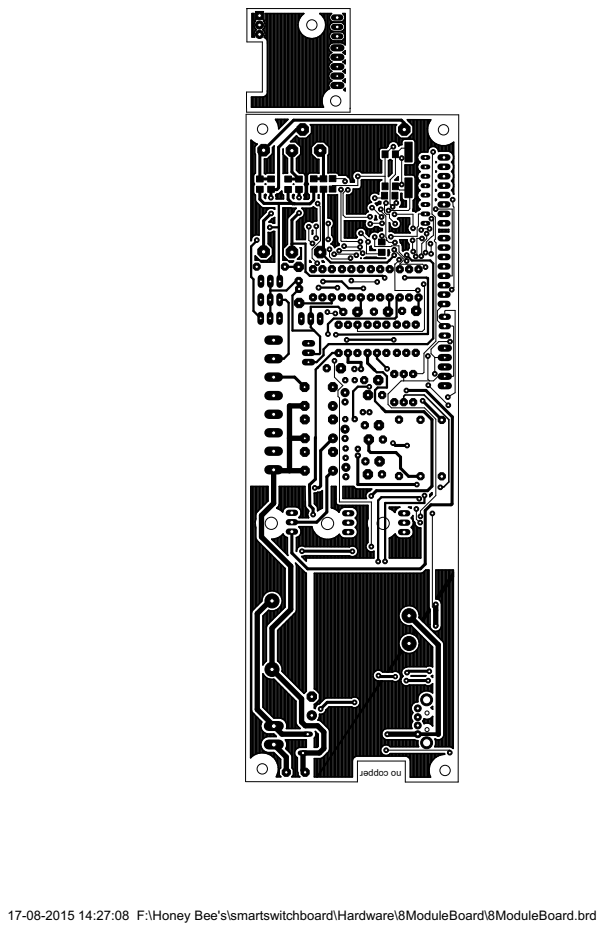
[picture p23: page 1]

17-08-2015 14:27:08 F:\Honey Bee's\smartswitchboard\Hardware\8ModuleBoard\8ModuleBoard.brd
