nmaiti/smartswitchboard/Hardware/8ModuleBoard/8ModuleBoardSchematic.pdf

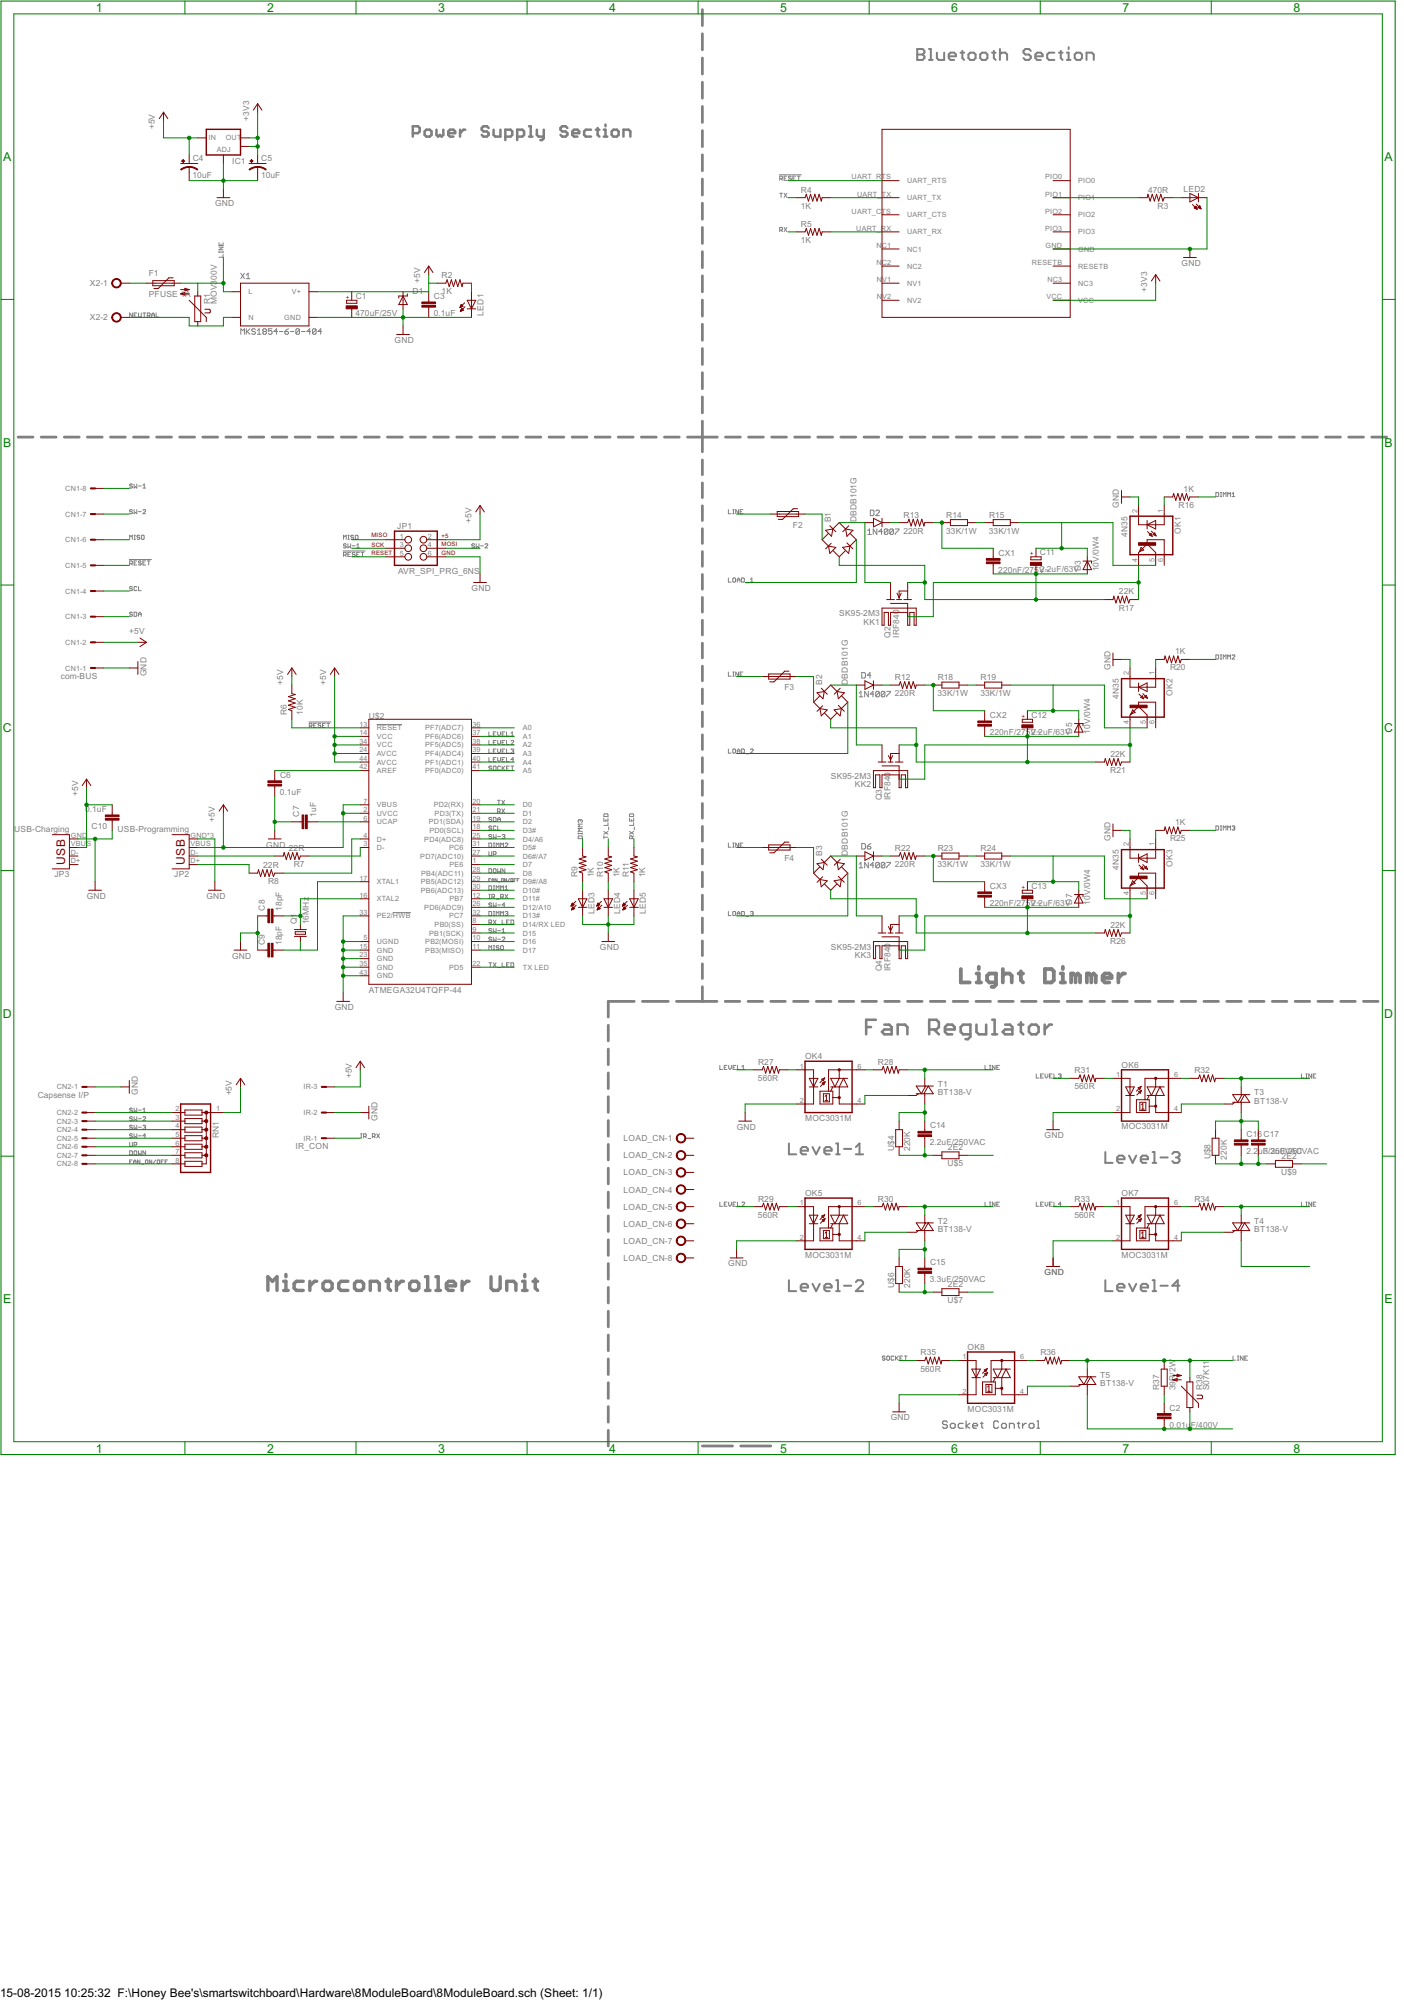
[picture p24: page 1]

15-08-2015 10:25:32 F:\Honey Bee's\smartswitchboard\Hardware\8ModuleBoard\8ModuleBoard.sch (Sheet: 1/1)
