nmaiti/smartswitchboard/Hardware/8ModuleBoard/8ModuleBoardsilk.pdf

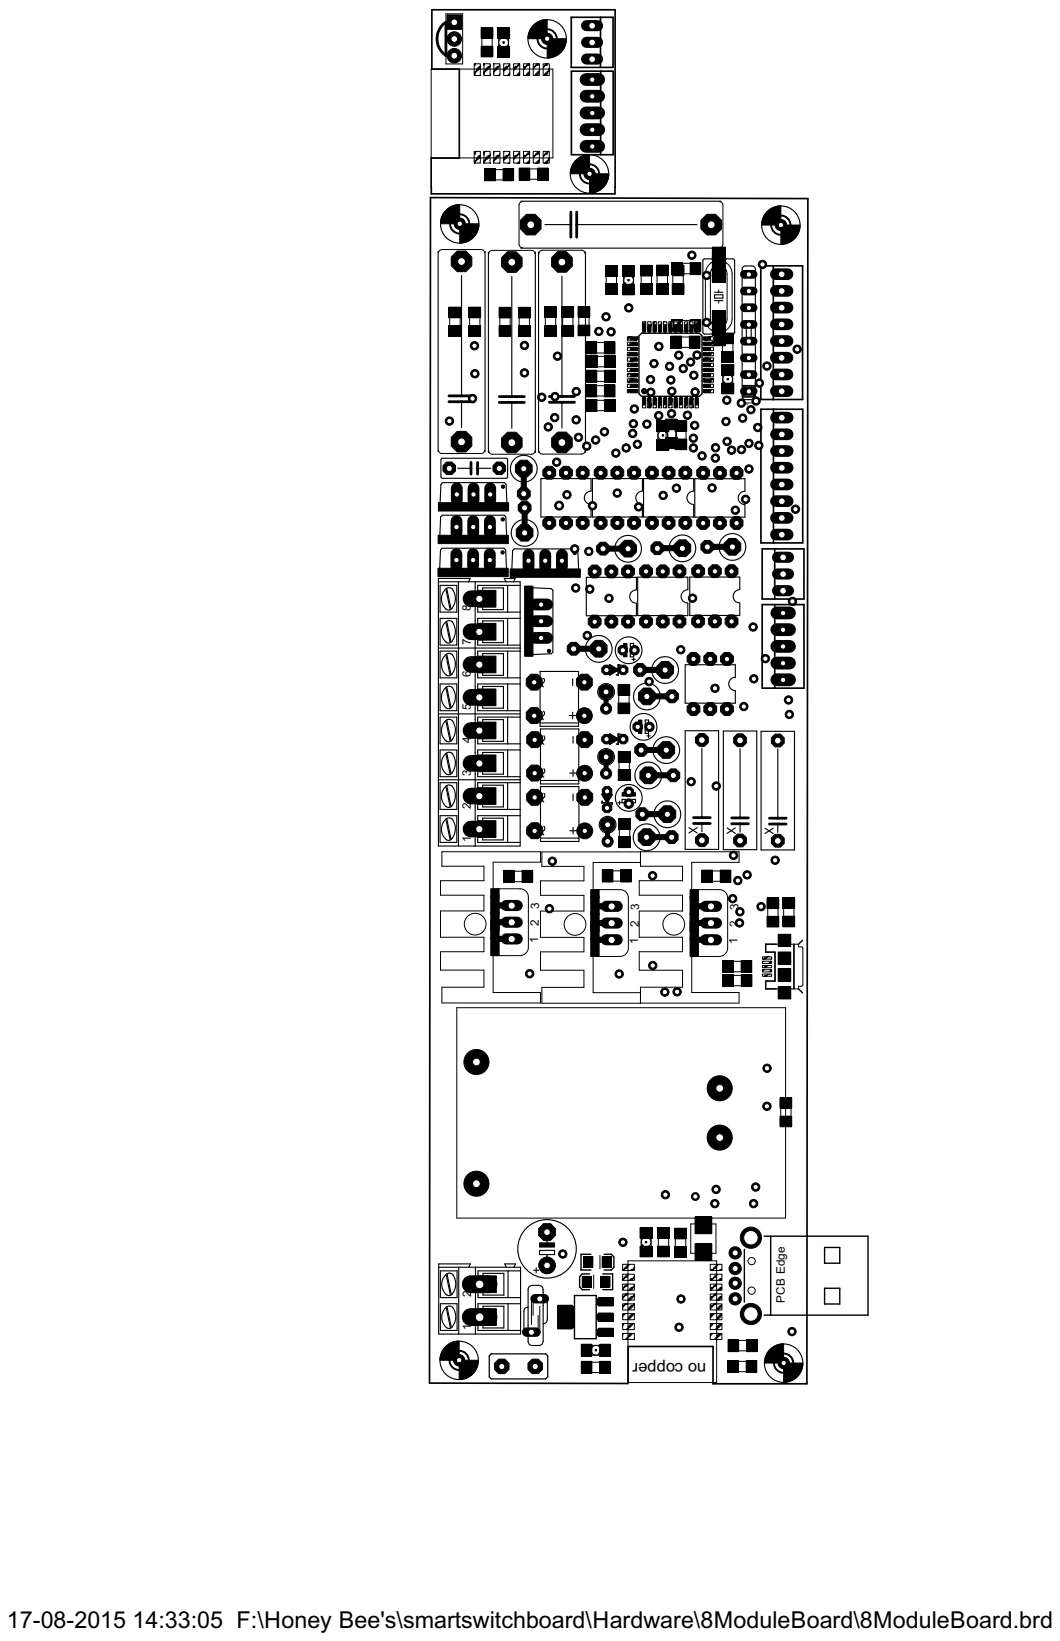
[picture p25: page 1]

17-08-2015 14:33:05 F:\Honey Bee's\smartswitchboard\Hardware\8ModuleBoard\8ModuleBoard.brd
