nmaiti/smartswitchboard/Hardware/8ModuleBoard/8ModuleBoardt1.pdf

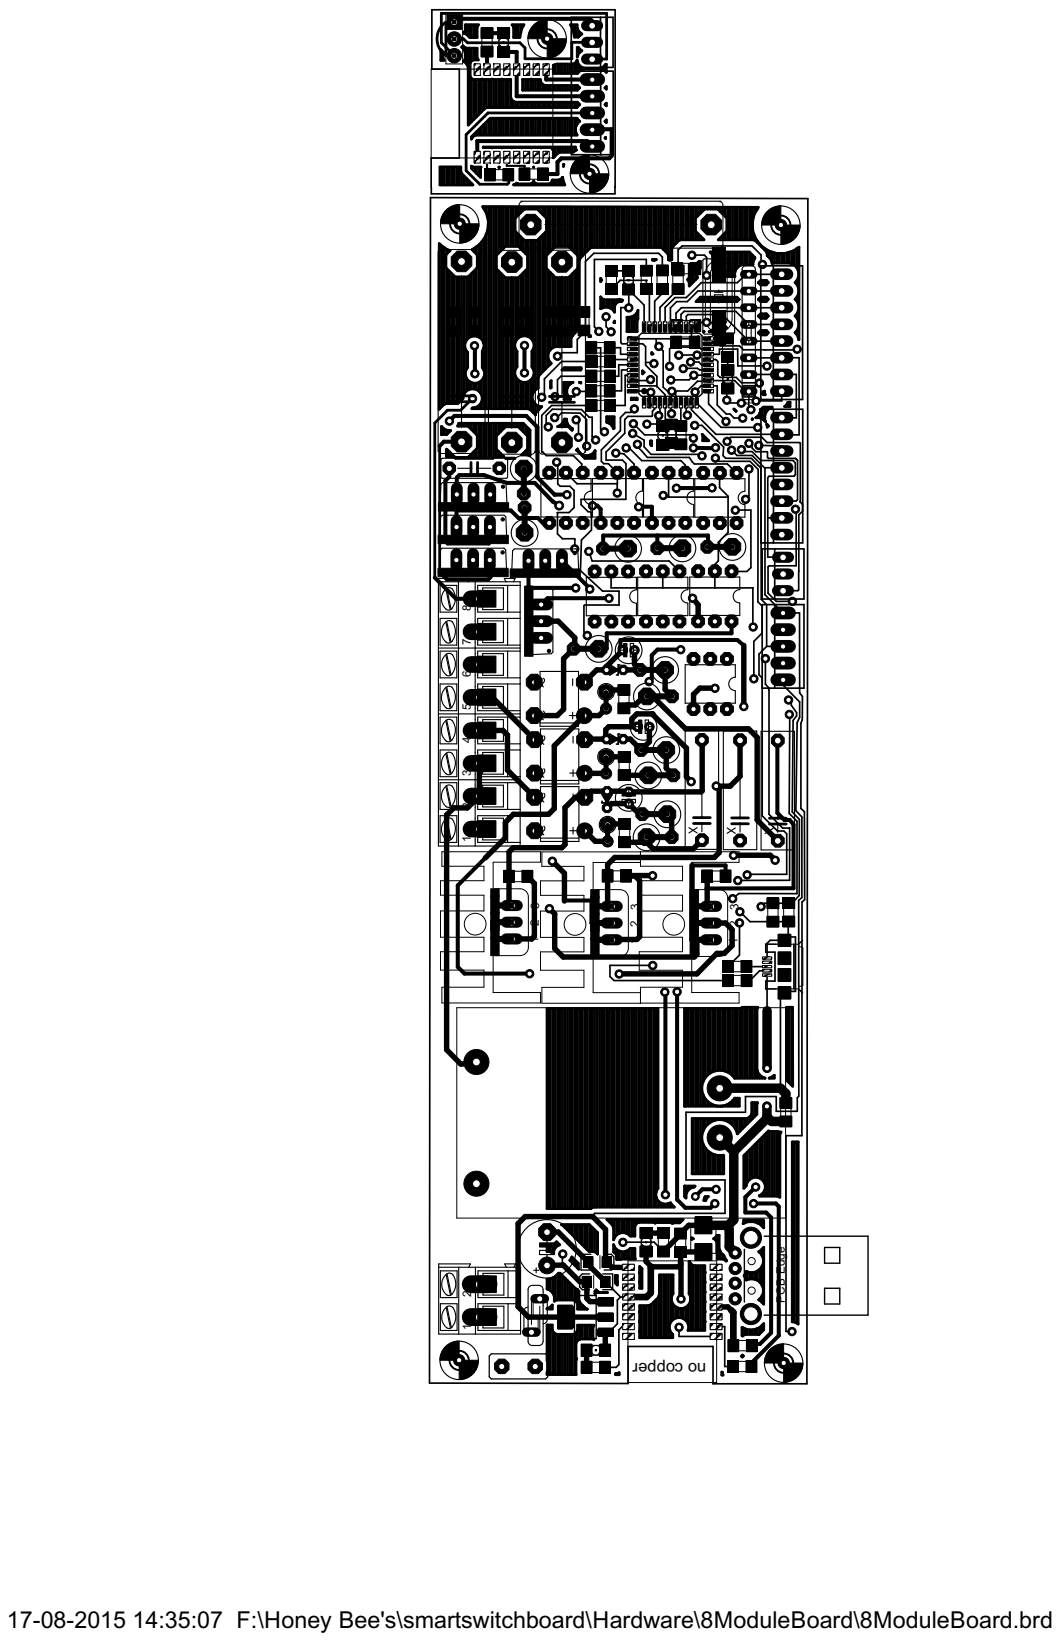
[picture p26: page 1]

17-08-2015 14:35:07 F:\Honey Bee's\smartswitchboard\Hardware\8ModuleBoard\8ModuleBoard.brd
