nmaiti/smartswitchboard/Hardware/8ModuleBoard/8ModuleBoardt2.pdf

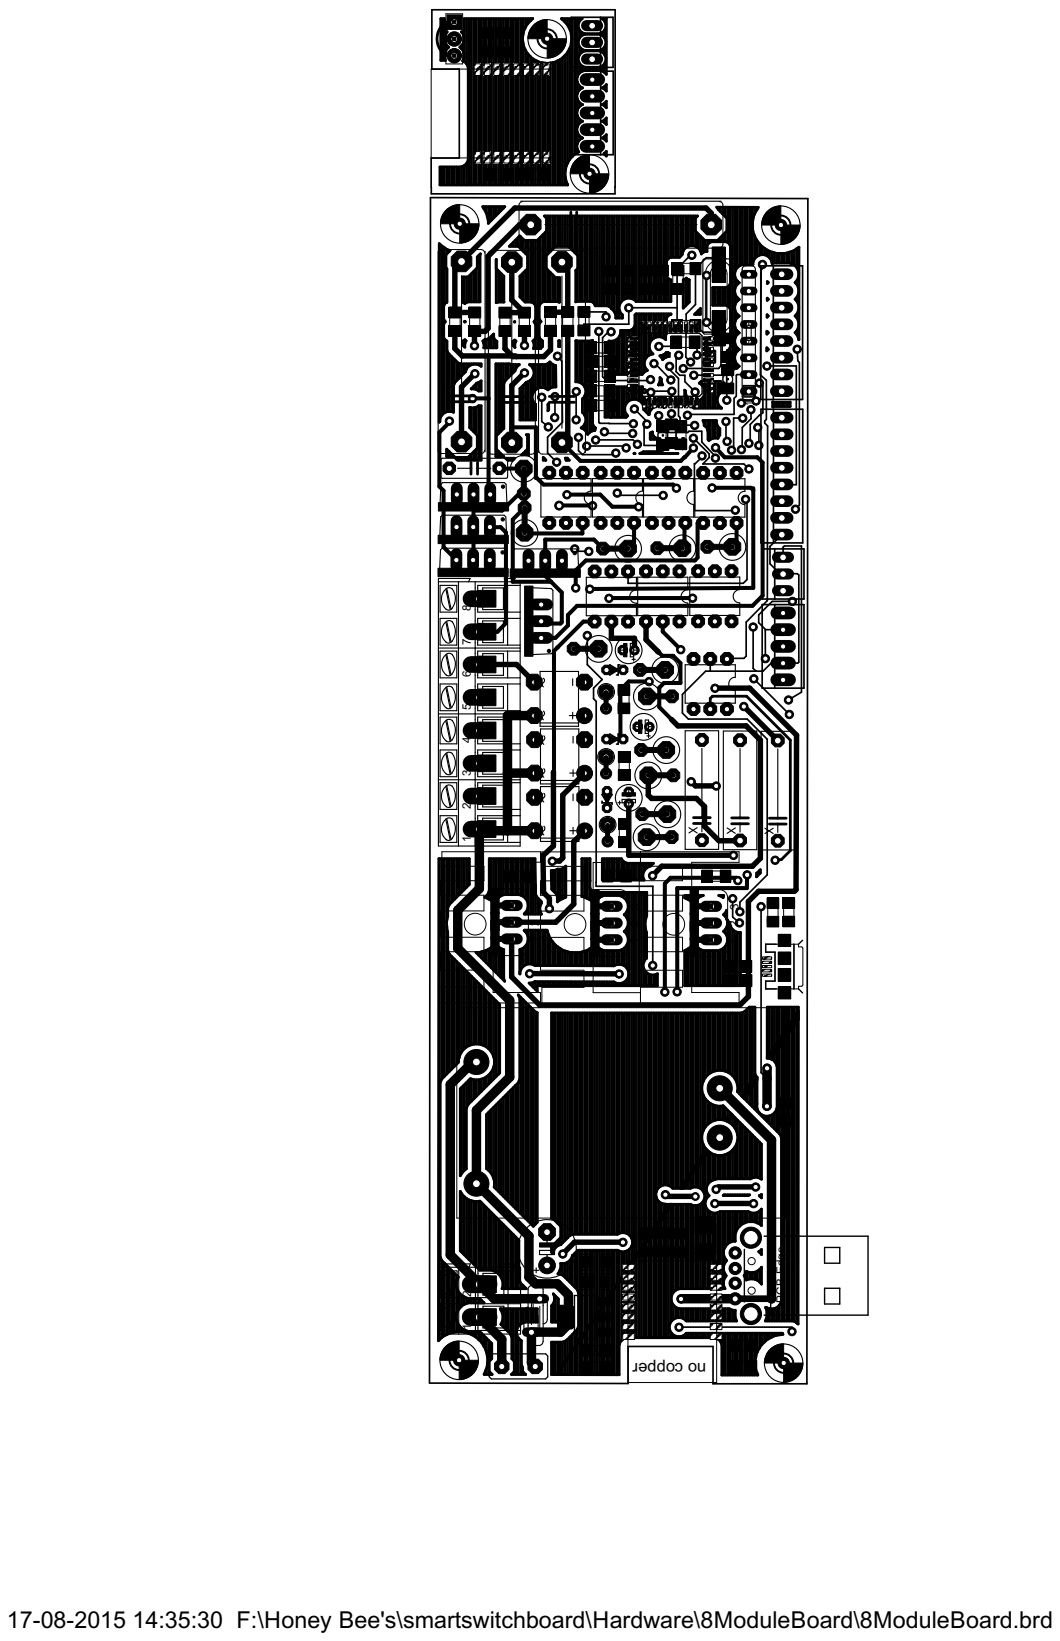
[picture p27: page 1]

17-08-2015 14:35:30 F:\Honey Bee's\smartswitchboard\Hardware\8ModuleBoard\8ModuleBoard.brd
