nmaiti/smartswitchboard/Hardware/8ModuleBoard/8ModuleBoardTop.pdf

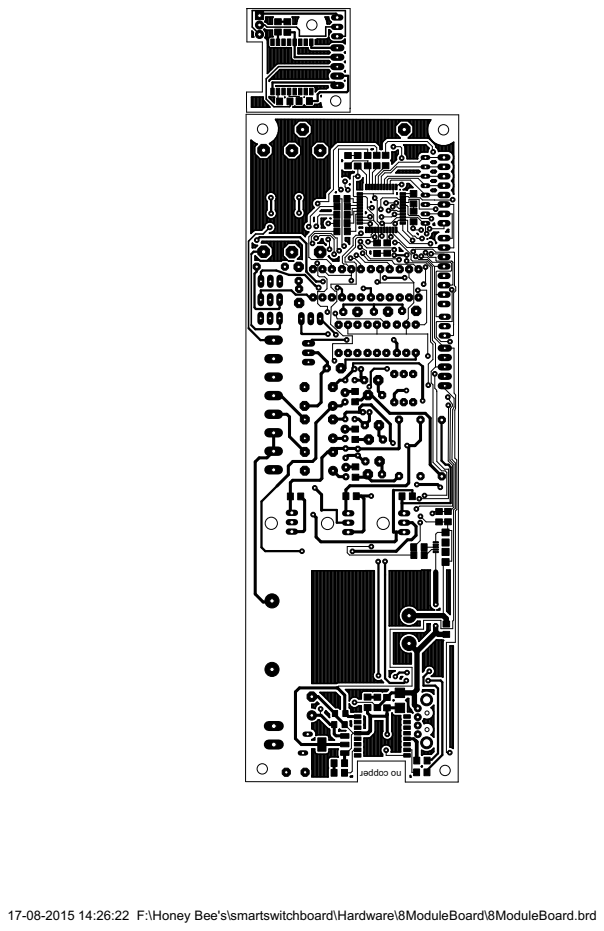
[picture p28: page 1]

17-08-2015 14:26:22 F:\Honey Bee's\smartswitchboard\Hardware\8ModuleBoard\8ModuleBoard.brd
