nmaiti/smartswitchboard/Hardware/LightDimmer/TriacDimmer.pdf

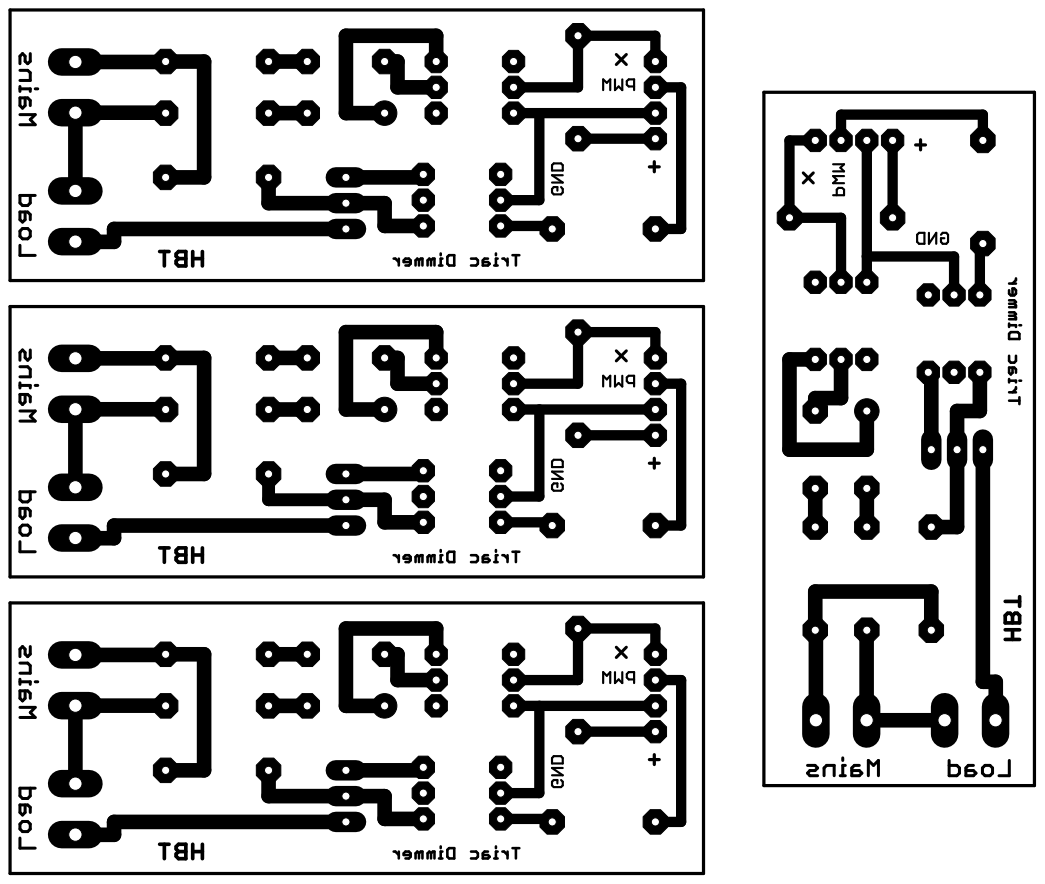
[picture p29: page 1]
