nmaiti/smartswitchboard/Hardware/Fan_Regulator/FanRegulator.pdf

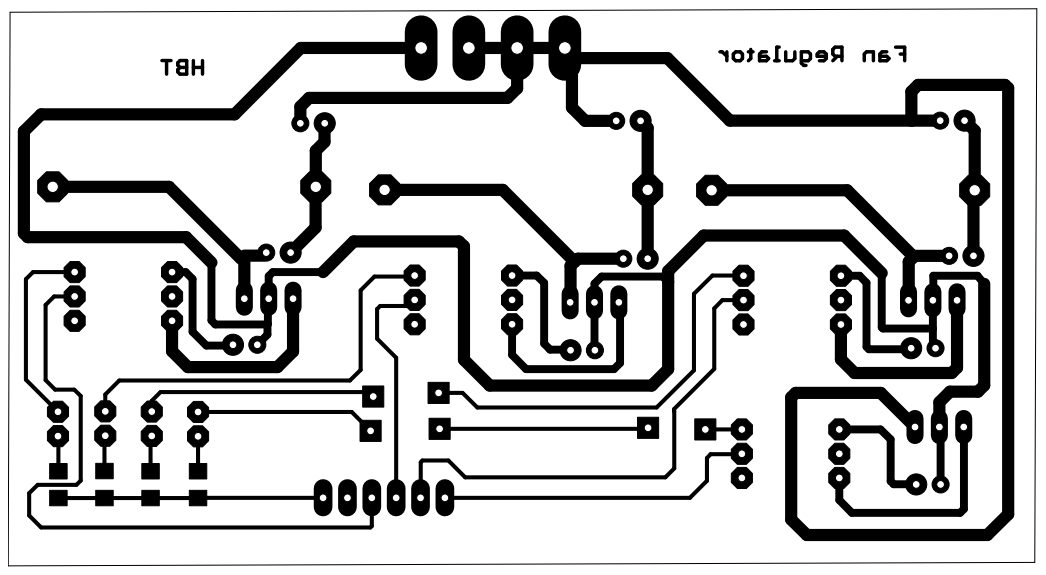
[picture p30: page 1]
