nmaiti/smartswitchboard/Hardware/Power_Supply_Board/ACtoDCconvtr.pdf

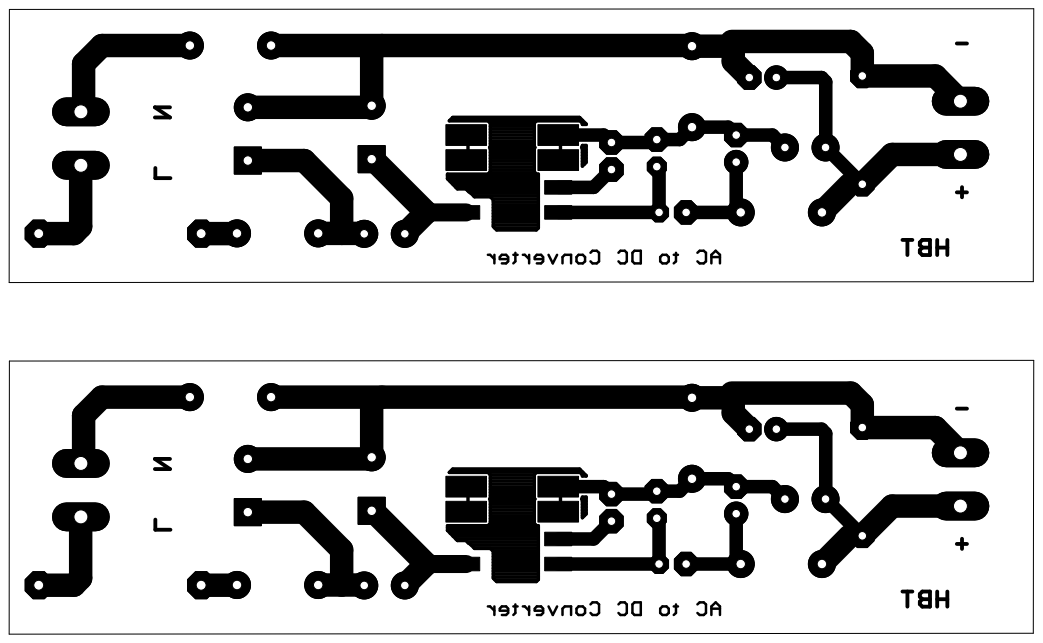
[picture p31: page 1]
