nmaiti/smartswitchboard/Hardware/6ModuleBoard/6moduleboard.pdf

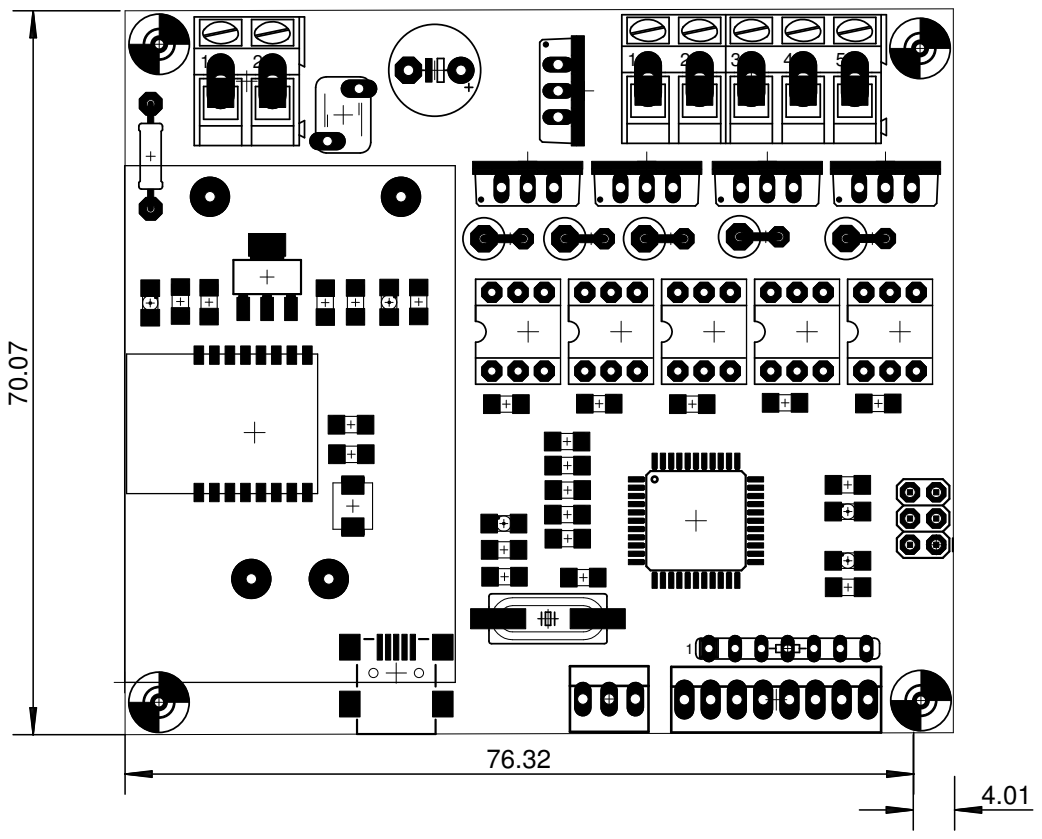
[picture p32: page 1]
