nmaiti/smartswitchboard/Hardware/CapsenseBoard/capsenseboard.pdf

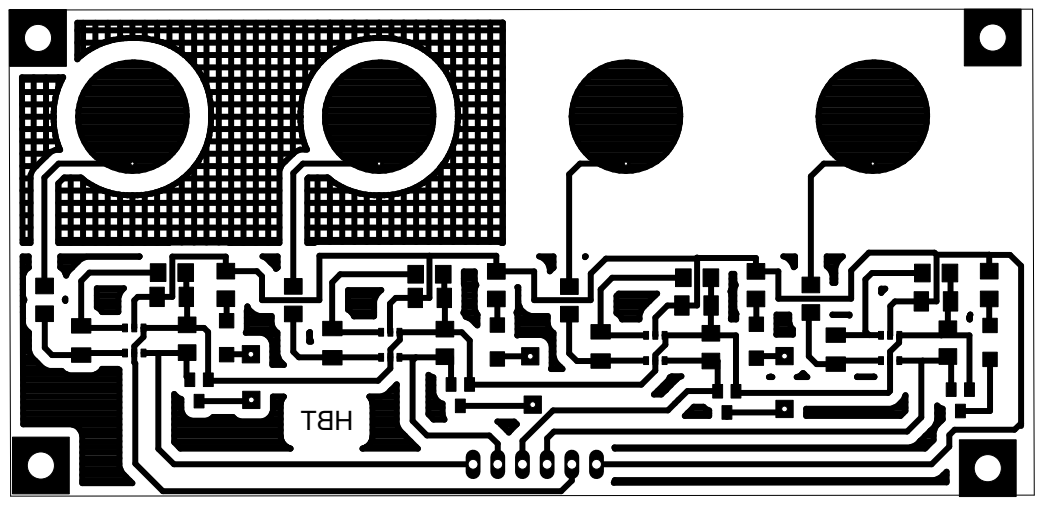
[picture p33: page 1]
