nmaiti/smartswitchboard/Hardware/SMPS_Details/SMPS_modified_data_21Aug2016/FG101.pdf

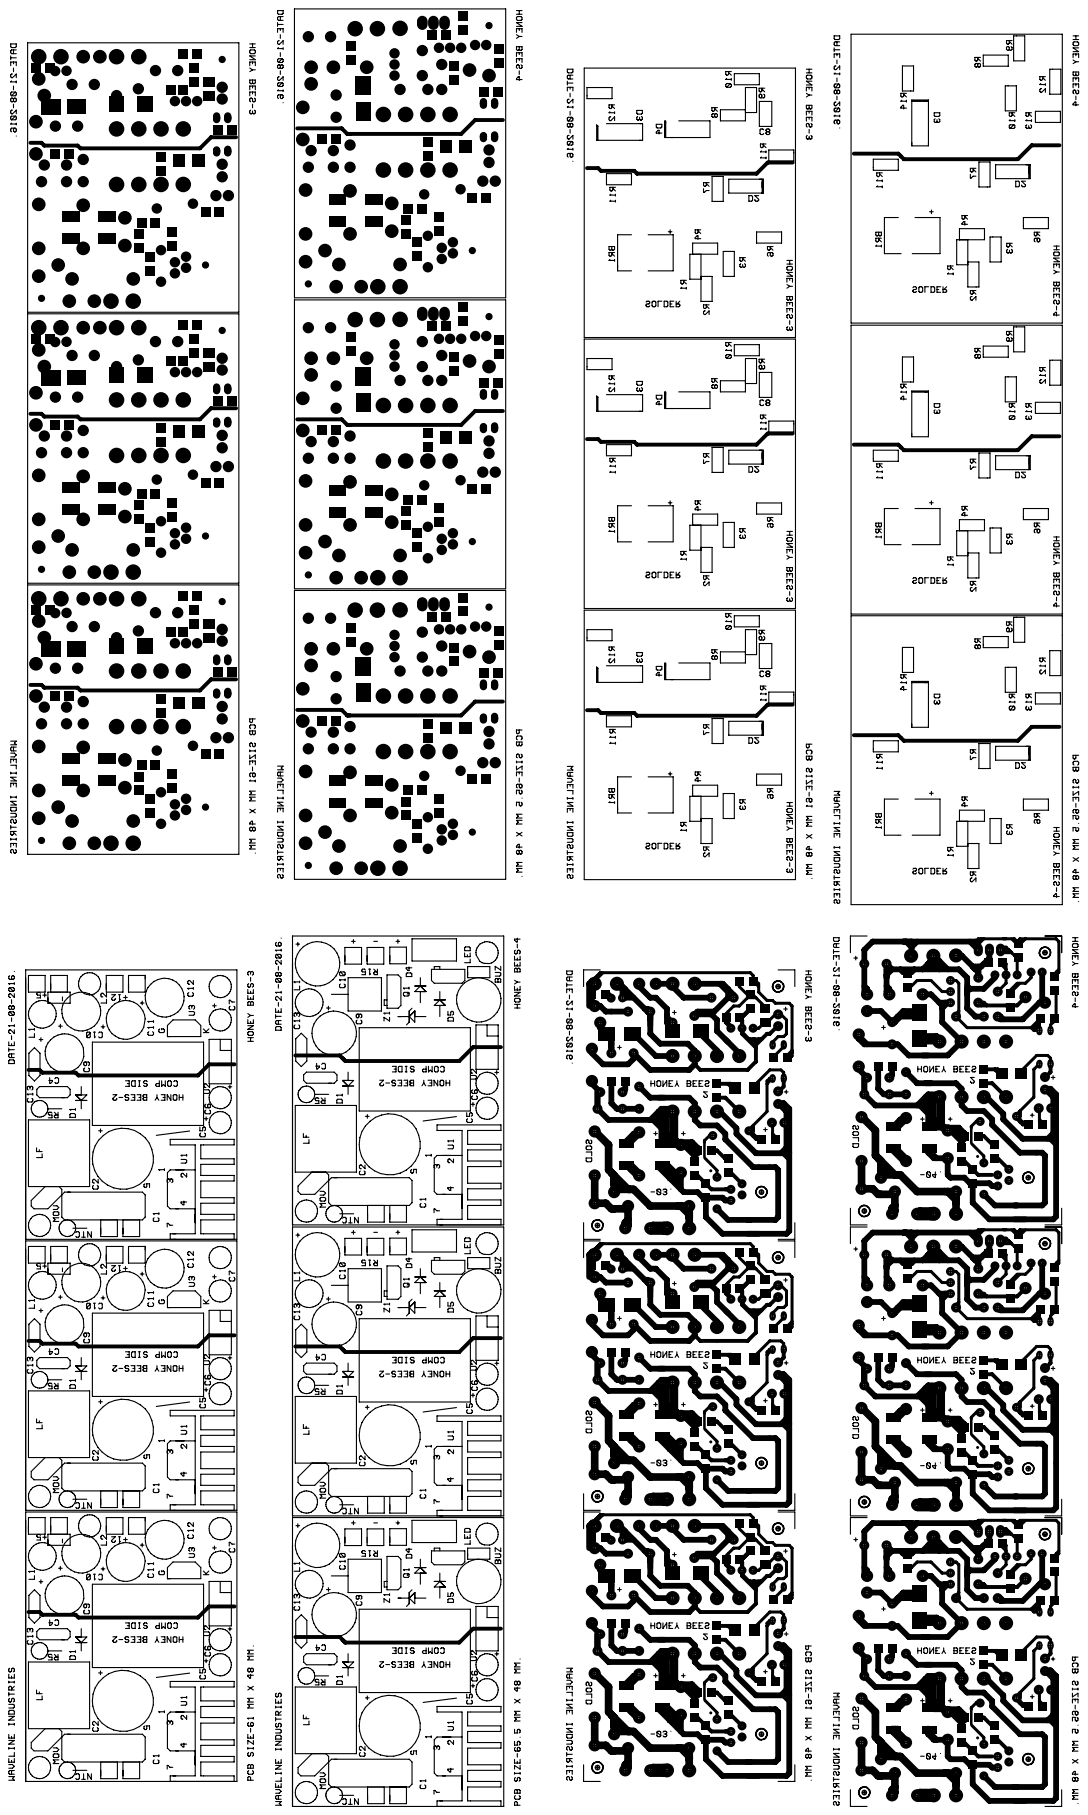
[picture p34: page 1]
