nmaiti/smartswitchboard/Hardware/SMPS_Details/SMPS_GerberData01-08-2016/FG100.pdf

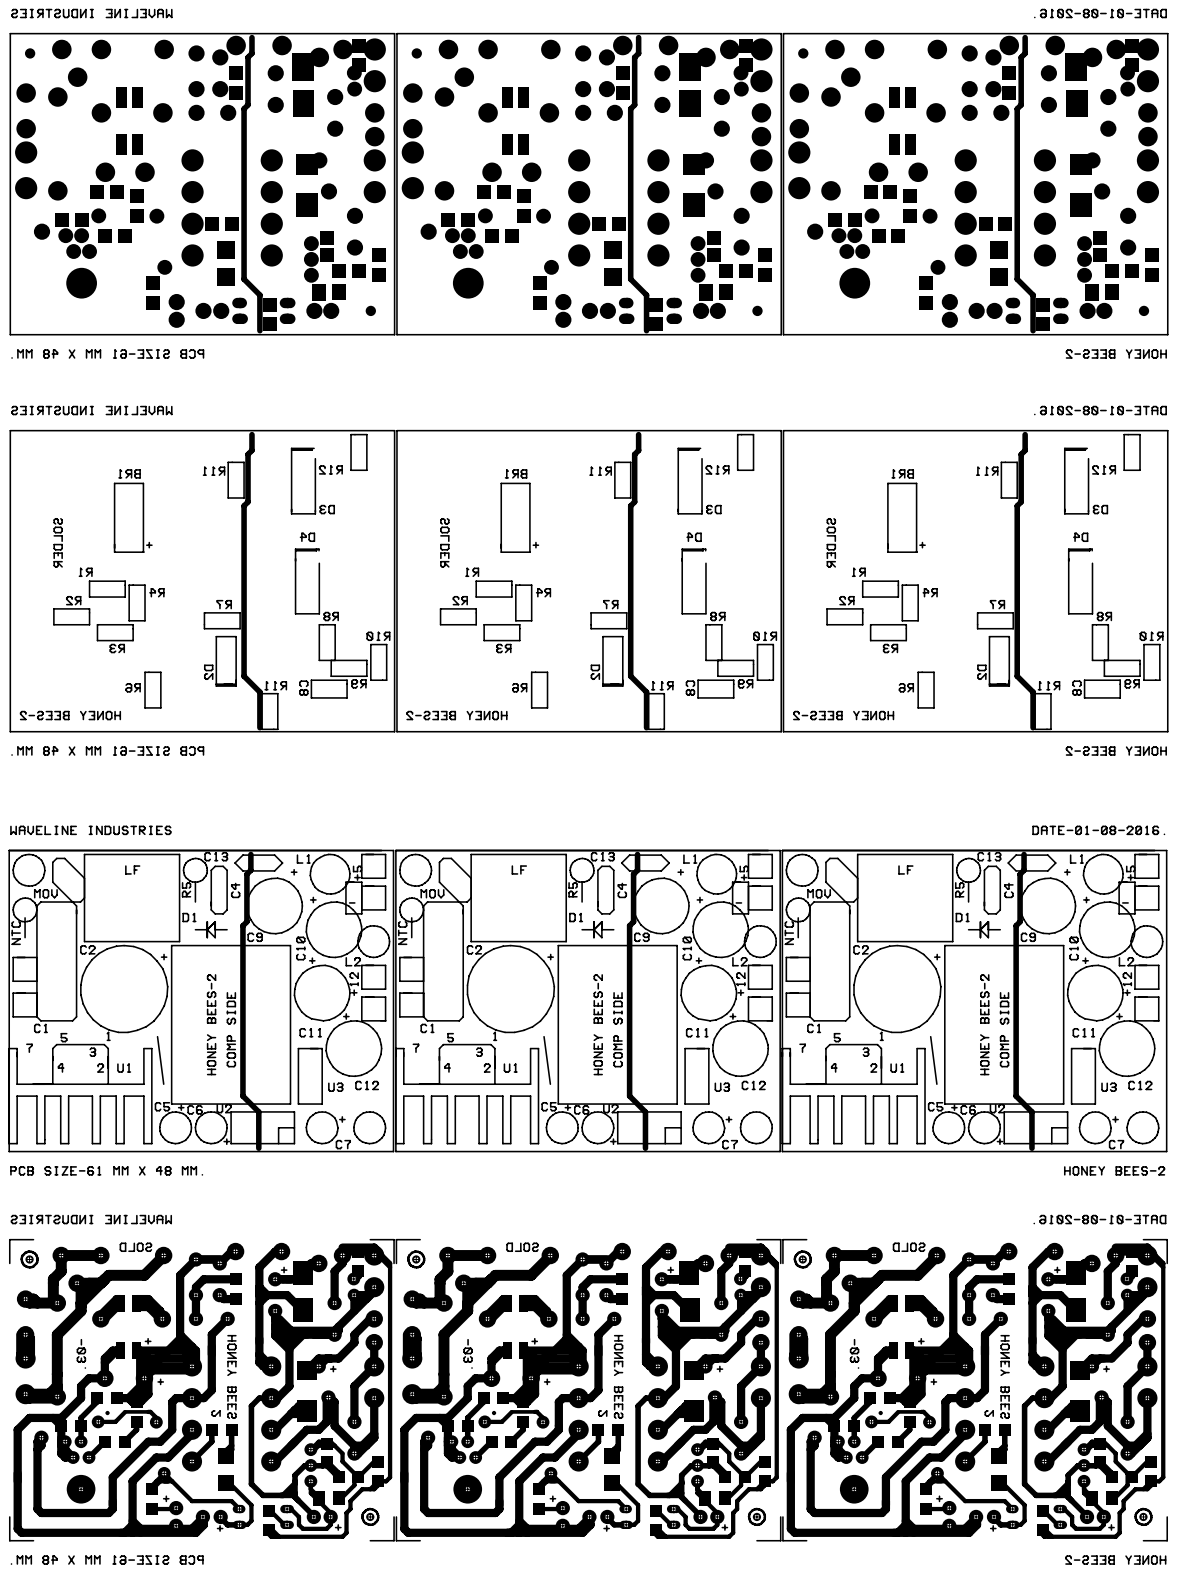
[picture p35: page 1]
