nmaiti/smartswitchboard/Hardware/SMPS_Details/SMPS_GerberData01-08-2016/FG87DR.pdf

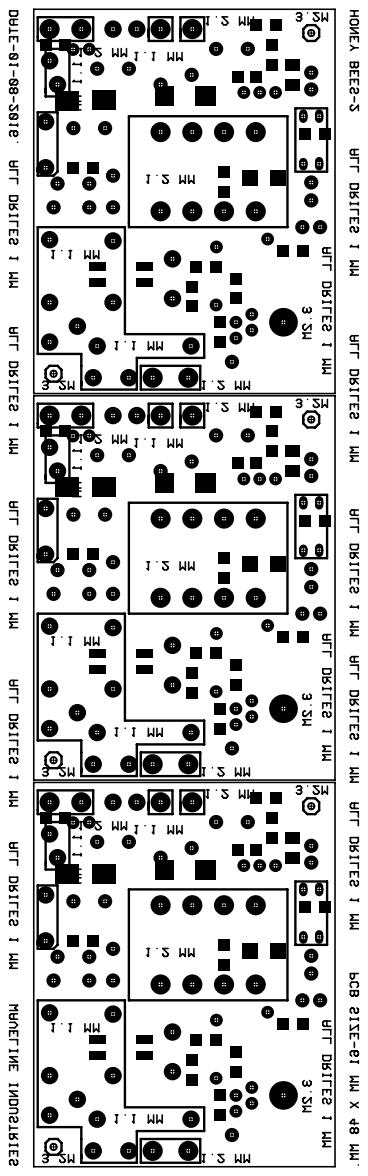
[picture p36: page 1]
