nmaiti/smartswitchboard/Hardware/SMPS_Details/vikas/FG95.pdf

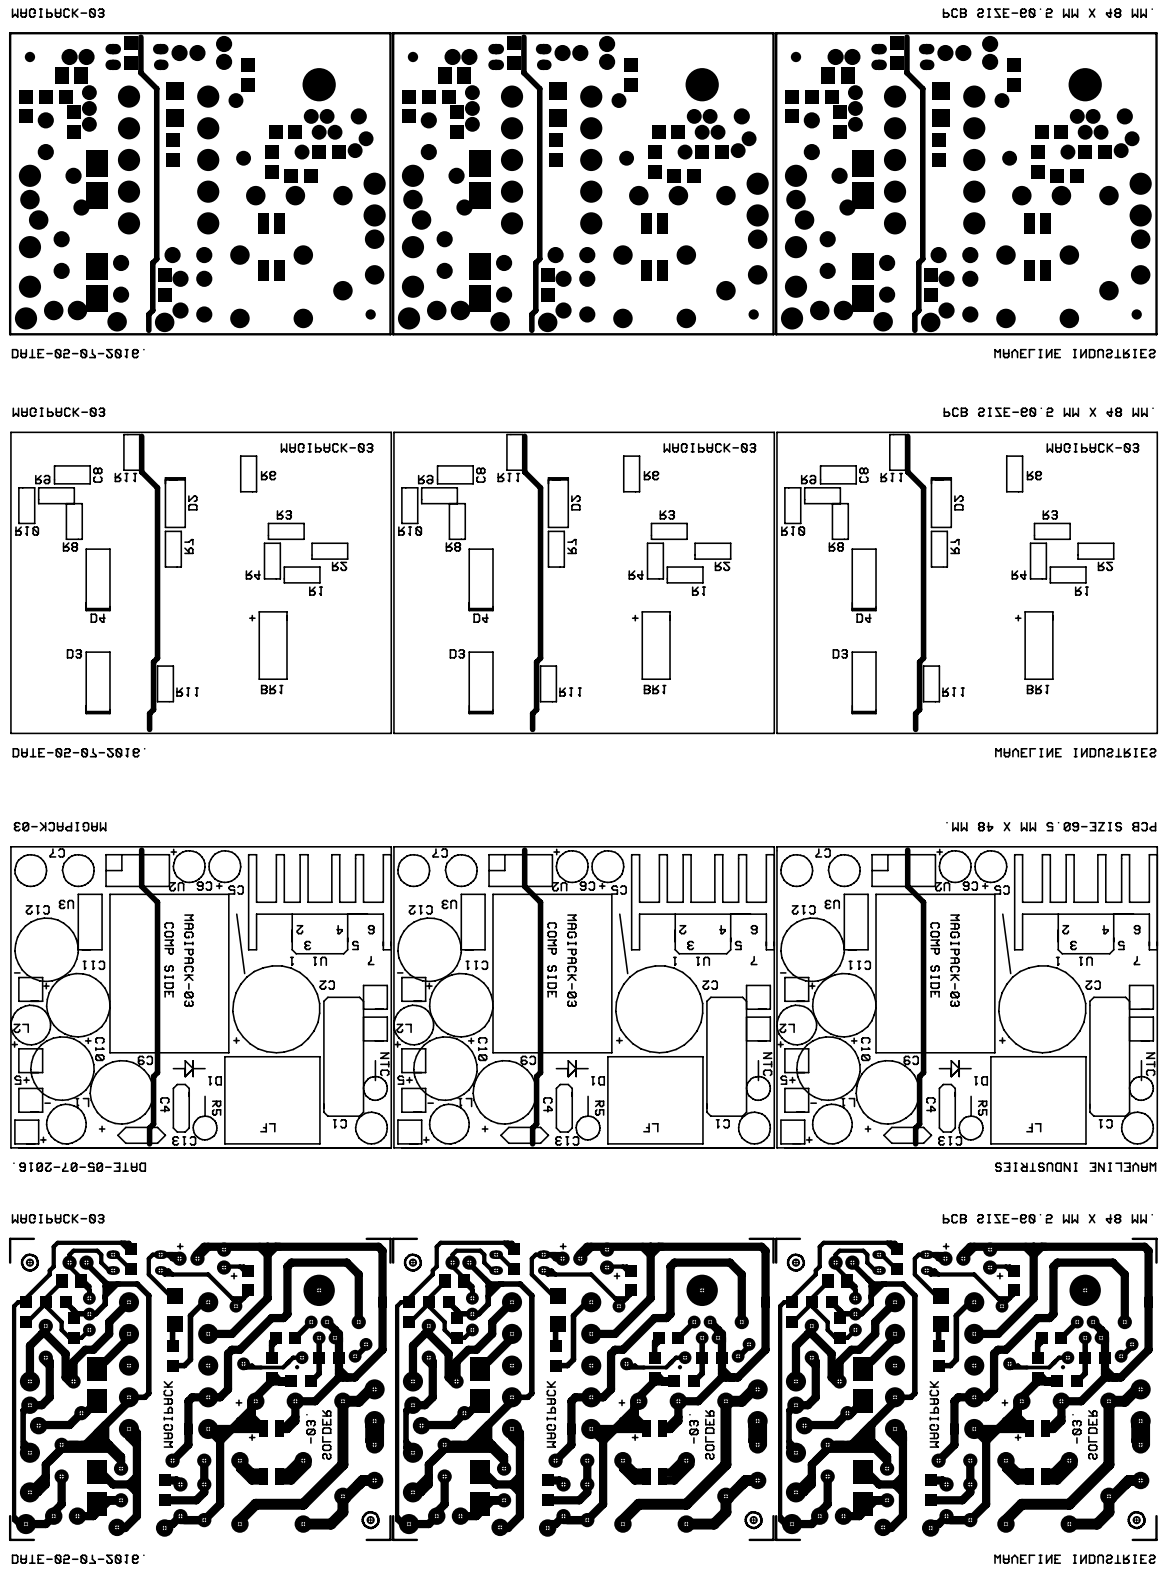
[picture p37: page 1]
