nmaiti/smartswitchboard/Hardware/8ModuleBoard_vr2/newBoard/8ModuleFinal.pdf

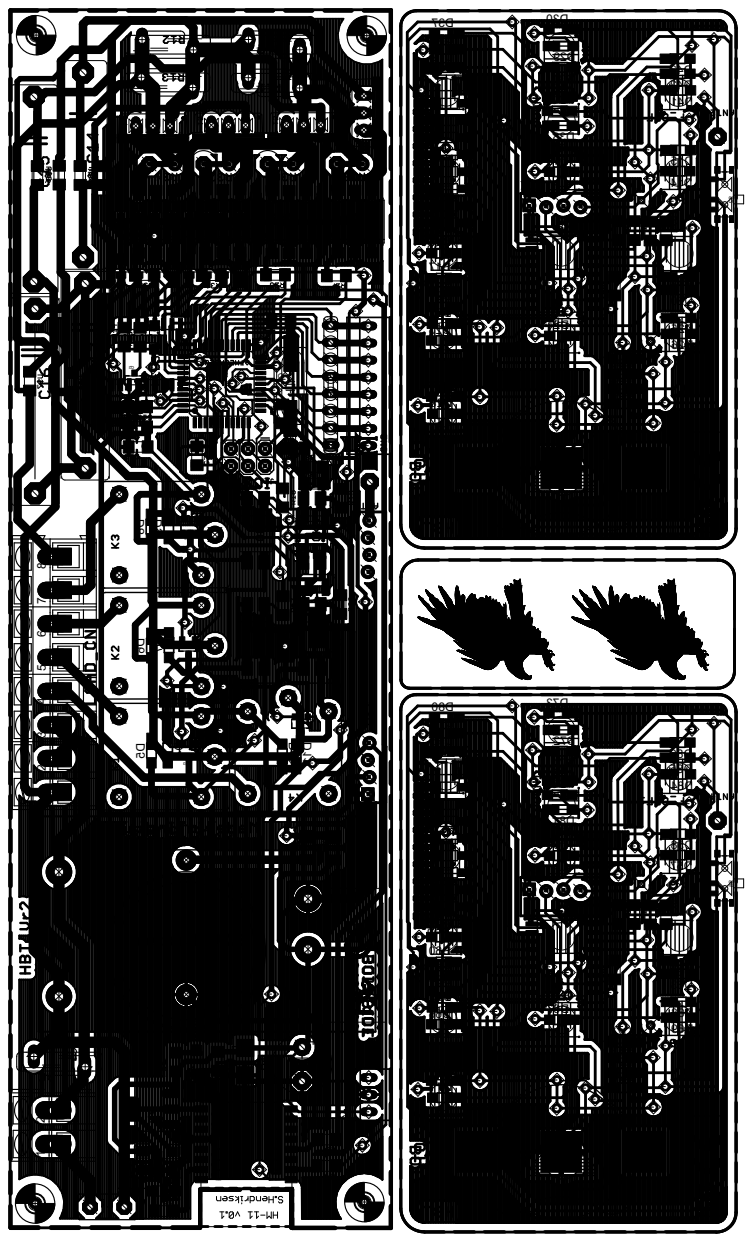
[picture p38: page 1]

Q1 1$U Y1 B1 1S IC2 3 Q D4D5 4 Q D6 D7 5 Q D8 D9 D6 Q10 D11 S2 TABV 3S 3 CI 21 D 31 D 41 D 51 D 61 D 71 D 81 D 91 D 02 D 12 D 22 D 32 D 42 D 52 D 62 D 72 D 82 D 92 D 03 D13 D 23 D 33 D 43 D 53 D 63 D 73 D 83 D 93 D 04 D 14 D 24 D 34 D S5 1TABV 6S 6 CI 55 D 65 D 75 D 85 D 95 D 06 D 16 D 26 D 36 D 46 D 56 D 66 D 76 D 86 D 96 D 07 D 17 D 27 D 37 D47 D 57 D 67 D 77 D 87 D 97 D 08 D 18 D 28 D 38 D 48 D 58 D 68 D O1N 2 3 4 5 6 7 8 O1N 2 3 4 5 6 7 8 1 1 2 1 2 3 4 5 6 7 8 XT_TRAU STR_TRAU ST C_TRAU XR_TRAU 1 CN 2 CN 1 VN CCV 2 VN 3 CN BTESER DNG 3 OI P 2 OI P 1 OI P 0 OI P U$2 2 Q XT 1XT
