nmaiti/smartswitchboard/Hardware/Pi_MCU_Backend/pi_mcu_powerBoard.brd

## EAGLE design Hardware/Pi_MCU_Backend/pi_mcu_powerBoard.brd (2016-12-16)

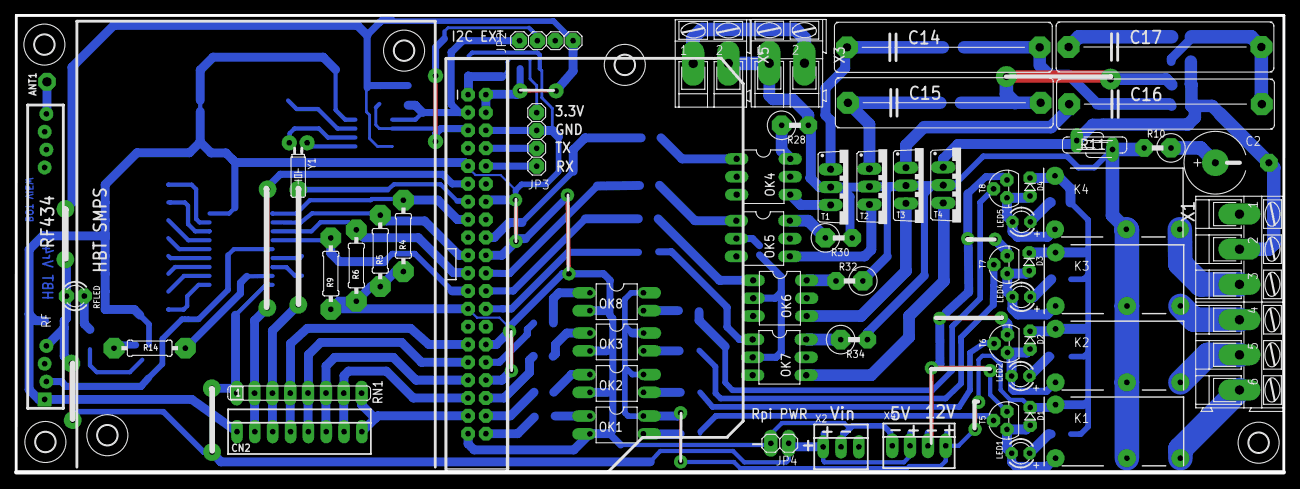
[picture p39: board pi_mcu_powerBoard.brd from above]

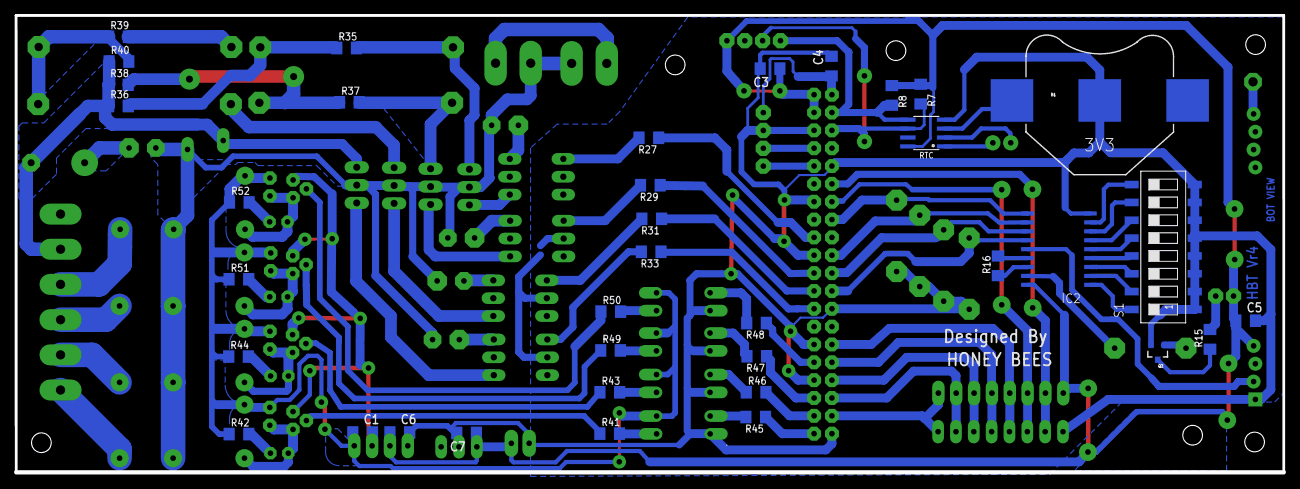
[picture p40: board pi_mcu_powerBoard.brd from below]

Board: 2 copper layers, 180.5 x 65.0 mm, 102 parts (37 on the bottom side), 93 nets.

Parts:
ANT1: PAD-01
B1: BATTCON_20MM
C1, C3, C4, C5, C6, C7: C1206
C2: E5R
C14, C16: 2.2uF/250VAC; C27.5B9
C15, C17: 3.3uF/250VAC; C27.5B9
CN2: Capsense I/P; 22-23-2081
D1, D2, D3, D4: D-2.5
IC2: HT680D; SOP18
JP1: RASPBERRYPI-B+-GPIO; 2X20-SHROUDED
JP2, JP3: 1X04
JP4: 1X02
K1, K2, K3, K4: RE030012; RE-SCHRACK
LED1, LED2, LED4, LED5: LED3MM
OK1, OK2, OK3, OK8: PC817; DIL04
OK4, OK5, OK6, OK7: MOC3041M; DIL06
Q2: MMBT2222A; SOT23-3
R4, R5, R6, R9: 0207/10
R7, R8: 4k7; 1206
R10: 0411V
R11: S07K11
R14: 10K; 0207/10
R15, R27, R29, R31, R33: 560R; 1206
R16: 33k; 1206
R28, R30, R32, R34: 470R/0.5W; 0411V
R35, R37, R39: 220K; 1206
R36, R38, R40: 2E2; 1206
R41, R42, R43, R44, R45, R46, R47, R48, R49, R50, R51, R52: 1k; 1206
RF: RF-LINK_RX
RFLED: LED3MM
RN1: SIL8
RTC: DS1307SO8; SO08
S1: SWS008; SMS-008
T1, T2, T3, T4: BTB16-V; TO220BV
T5, T6, T7, T8: BC547; TO92
U$3, U$4, U$5, U$6, U$7, U$8: 2,8
X1: AK300/6
X2: 22-23-2031
X3, X5: AK300/2
X4: 22-23-2041
Y1: 32.768KHz; TC26H

Connections:
(DIN)TE: IC2.14, RF.DATA@1
(VT)ADOUT: IC2.17, R14.2
+3V3: C4.1, JP1.1, JP1.17, JP3.1
+5V: C3.1, C5.1, C6.1, C7.1, IC2.18, JP1.2, JP1.4, JP2.1, JP4.1, R7.1, R8.1, RF.+5V@1, RFLED.A, RN1.1, RTC.8, X2.1, X4.2
+12V: C1.1, D1.C, D2.C, D3.C, D4.C, K1.A2, K2.A2, K3.A2, K4.A2, OK1.4, OK2.4, OK3.4, OK8.4, R42.1, R44.1, R51.1, R52.1, X4.4
-12V: C1.2, T5.1, T6.1, T7.1, T8.1, X4.3
A0: IC2.1, S1.16
A1: IC2.2, S1.15
A2: IC2.3, S1.14
A3: IC2.4, S1.13
A4: IC2.5, S1.12
A5: IC2.6, S1.11
A6: IC2.7, S1.10
A7: IC2.8, S1.9
DOWN: CN2.7, JP1.35, RN1.7
FAN_ON/OFF: CN2.8, JP1.37, RN1.8
FAN_REG: C2.-, R11.1, R36.1, R38.1, R40.1, T4.T1, X1.2
GND: B1.2, C3.2, C4.2, C5.2, C6.2, C7.2, CN2.1, IC2.9, JP1.6, JP1.9, JP1.14, JP1.20, JP1.25, JP1.30, JP1.34, JP1.39, JP2.2, JP3.2, JP4.2, OK1.2, OK2.2, OK3.2, OK4.2, OK5.2, OK6.2, OK7.2, OK8.2, Q2.2, R4.1, R5.1, R6.1, R9.1, RF.GND@1, RTC.4, S1.1, S1.2, S1.3, S1.4, S1.5, S1.6, S1.7, S1.8, X2.2, X4.1
L1: JP1.40, R45.1
L2: JP1.38, R46.2
L3: JP1.36, R47.1
L4: JP1.32, R48.1
LEVEL1: JP1.18, R27.1
LEVEL2: JP1.22, R29.1
LEVEL3: JP1.24, R31.1
LEVEL4: JP1.26, R33.1
LINE: K1.14, K2.14, K3.14, K4.14, R10.2, R11.2, R28.2, R30.2, R32.1, R34.2, T1.T2, T2.T2, T3.T2, T4.T2, X3.1, X5.2
unnamed: OK6.1, R31.2
unnamed: OK4.1, R27.2
unnamed: OK5.1, R29.2
unnamed: OK4.6, R28.1
unnamed: OK7.1, R33.2
unnamed: OK1.3, R41.2
unnamed: R41.1, T5.2
unnamed: D1.A, K1.A1, LED1.K, T5.3
unnamed: LED1.A, R42.2
unnamed: OK1.1, R45.2
unnamed: RTC.2, Y1.2
unnamed: OK2.1, R46.1
unnamed: OK2.3, R43.2
unnamed: R43.1, T6.2
unnamed: C2.+, R10.1
unnamed: D2.A, K2.A1, LED2.K, T6.3
unnamed: Q2.1, R14.1
unnamed: RTC.1, Y1.1
unnamed: K3.11, X1.4
unnamed: B1.1, RTC.3
unnamed: Q2.3, R15.1
unnamed: LED2.A, R44.2
unnamed: K1.11, X1.6
unnamed: R15.2, RFLED.K
unnamed: K2.11, X1.5
unnamed: OK5.6, R30.1
unnamed: OK6.6, R32.2
unnamed: ANT1.1, RF.ANT
unnamed: OK3.1, R47.2
unnamed: OK8.3, R50.2
unnamed: OK7.6, R34.1
unnamed: OK3.3, R49.2
unnamed: R49.1, T7.2
unnamed: R50.1, T8.2
unnamed: D3.A, K3.A1, LED4.K, T7.3
unnamed: K4.11, X1.3
unnamed: LED4.A, R51.2
unnamed: D4.A, K4.A1, LED5.K, T8.3
unnamed: LED5.A, R52.2
unnamed: OK8.1, R48.2
unnamed: OK4.4, T1.G
unnamed: C14.1, R35.2, T1.T1
unnamed: C14.2, R35.1, R36.2
unnamed: OK5.4, T2.G
unnamed: C15.1, R37.2, T2.T1
unnamed: C15.2, R37.1, R38.2
unnamed: OK6.4, T3.G
unnamed: C16.1, C17.1, R39.2, T3.T1
unnamed: C16.2, C17.2, R39.1, R40.2
unnamed: OK7.4, T4.G
NEUTRAL: X1.1, X3.2, X5.1
OSC1: IC2.16, R16.1
OSC2: IC2.15, R16.2
RFD0: IC2.10, JP1.15, R4.2
RFD1: IC2.11, JP1.19, R5.2
RFD2: IC2.12, JP1.21, R6.2
RFD3: IC2.13, JP1.23, R9.2
RX: JP1.10, JP3.4
SCL: JP1.5, JP2.3, R7.2, RTC.6
SDA: JP1.3, JP2.4, R8.2, RTC.5
SW-1: CN2.2, JP1.11, RN1.2
SW-2: CN2.3, JP1.13, RN1.3
SW-3: CN2.4, JP1.29, RN1.4
SW-4: CN2.5, JP1.31, RN1.5
TX: JP1.8, JP3.3
UP: CN2.6, JP1.33, RN1.6
