nmaiti/smartswitchboard/Hardware/8ModuleBoard_vr2/8ModuleBoard_vr2.brd

## EAGLE design Hardware/8ModuleBoard_vr2/8ModuleBoard_vr2.brd (2016-02-23)

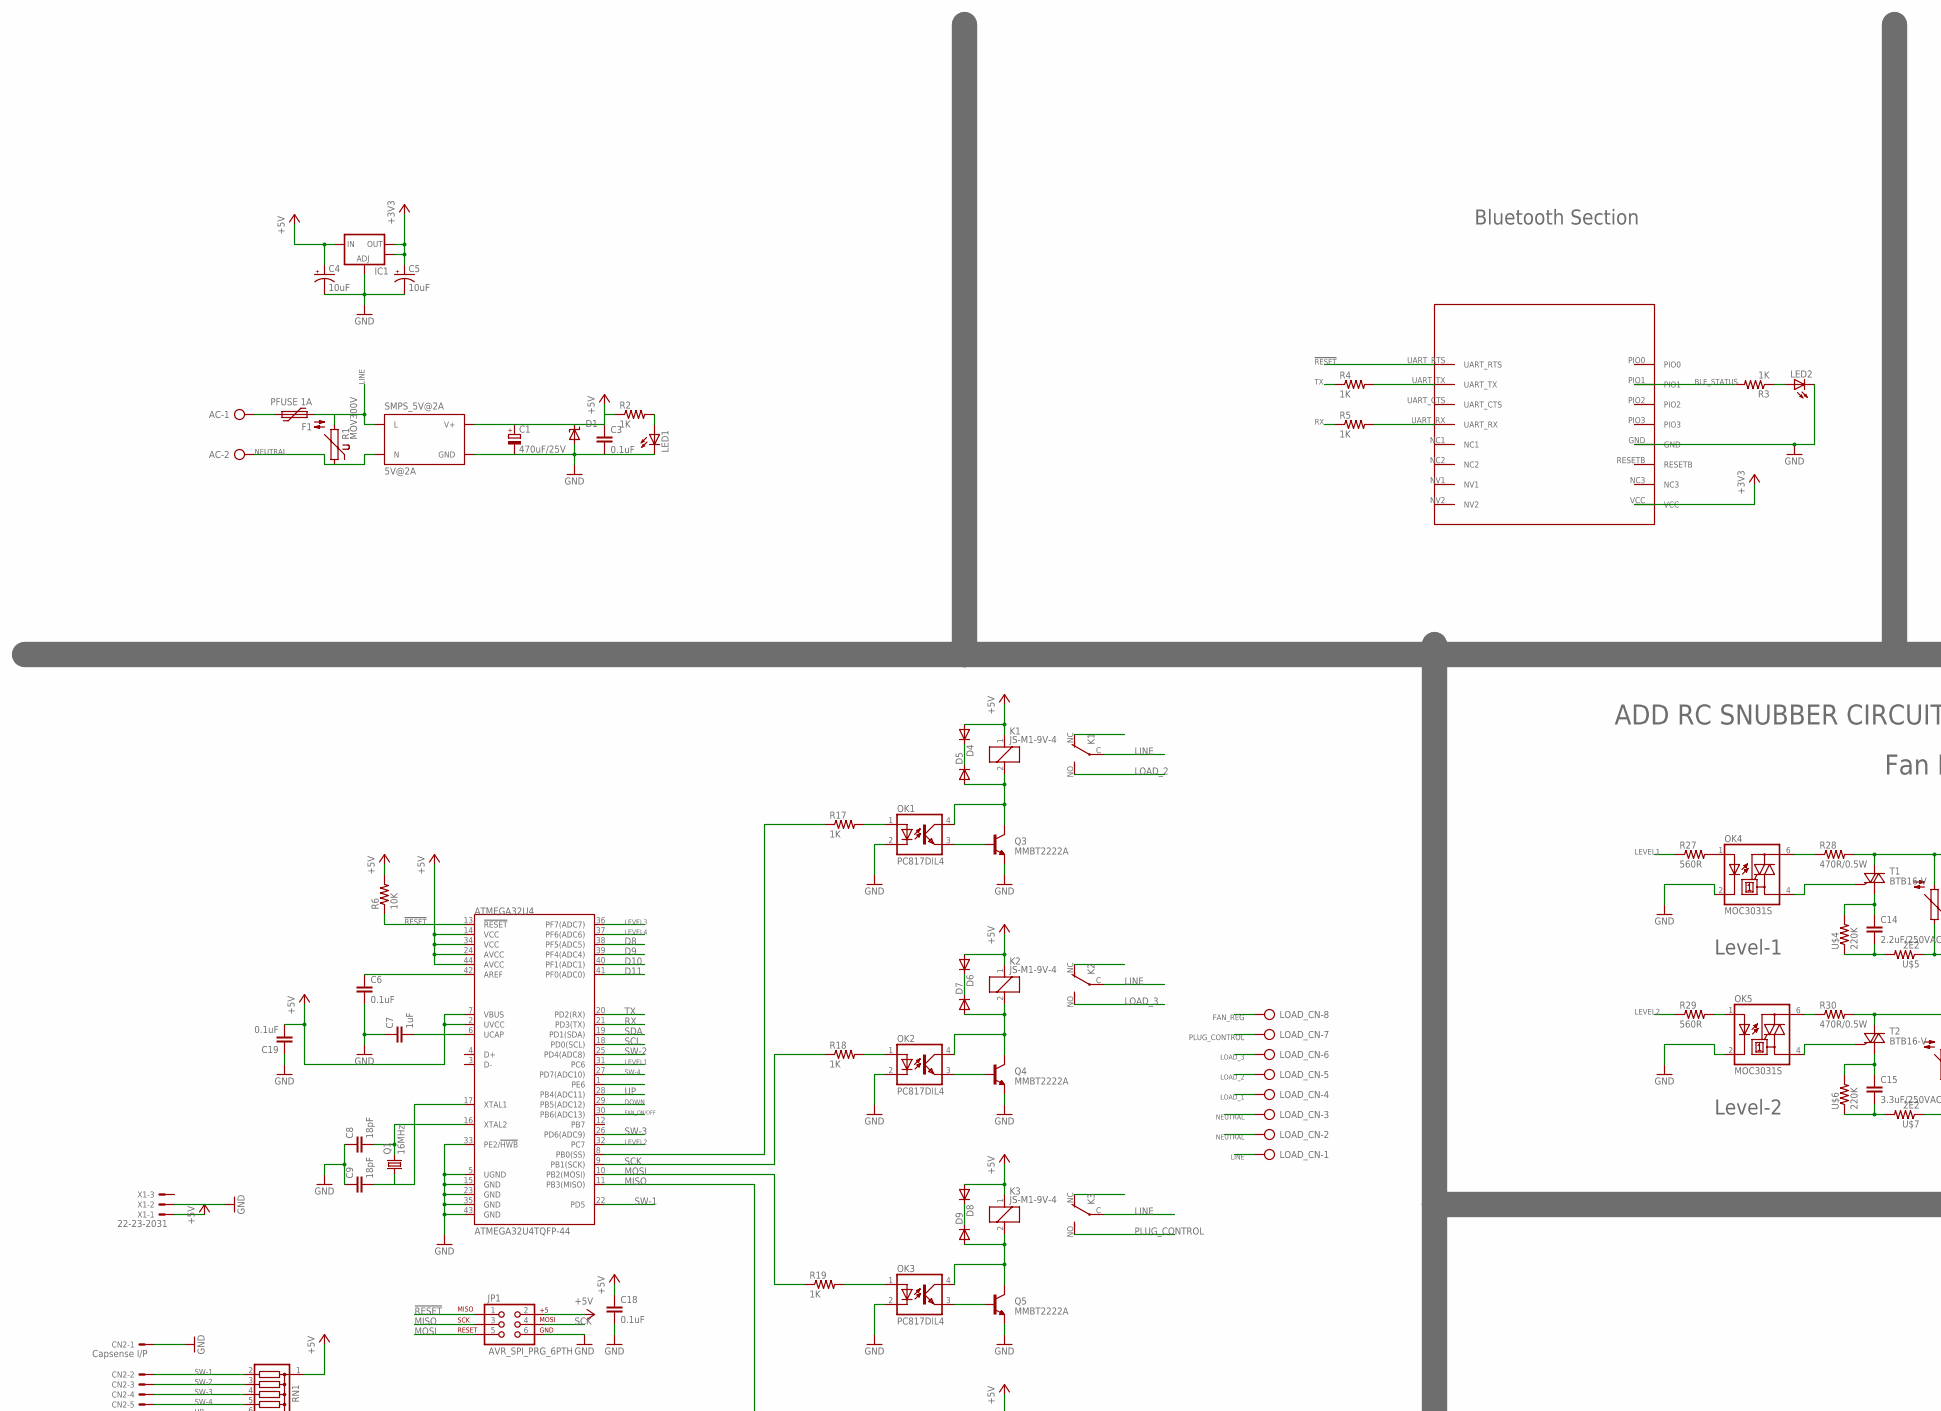
[picture p41: schematic 8ModuleBoard_vr2.sch, part in row 1, column 1]

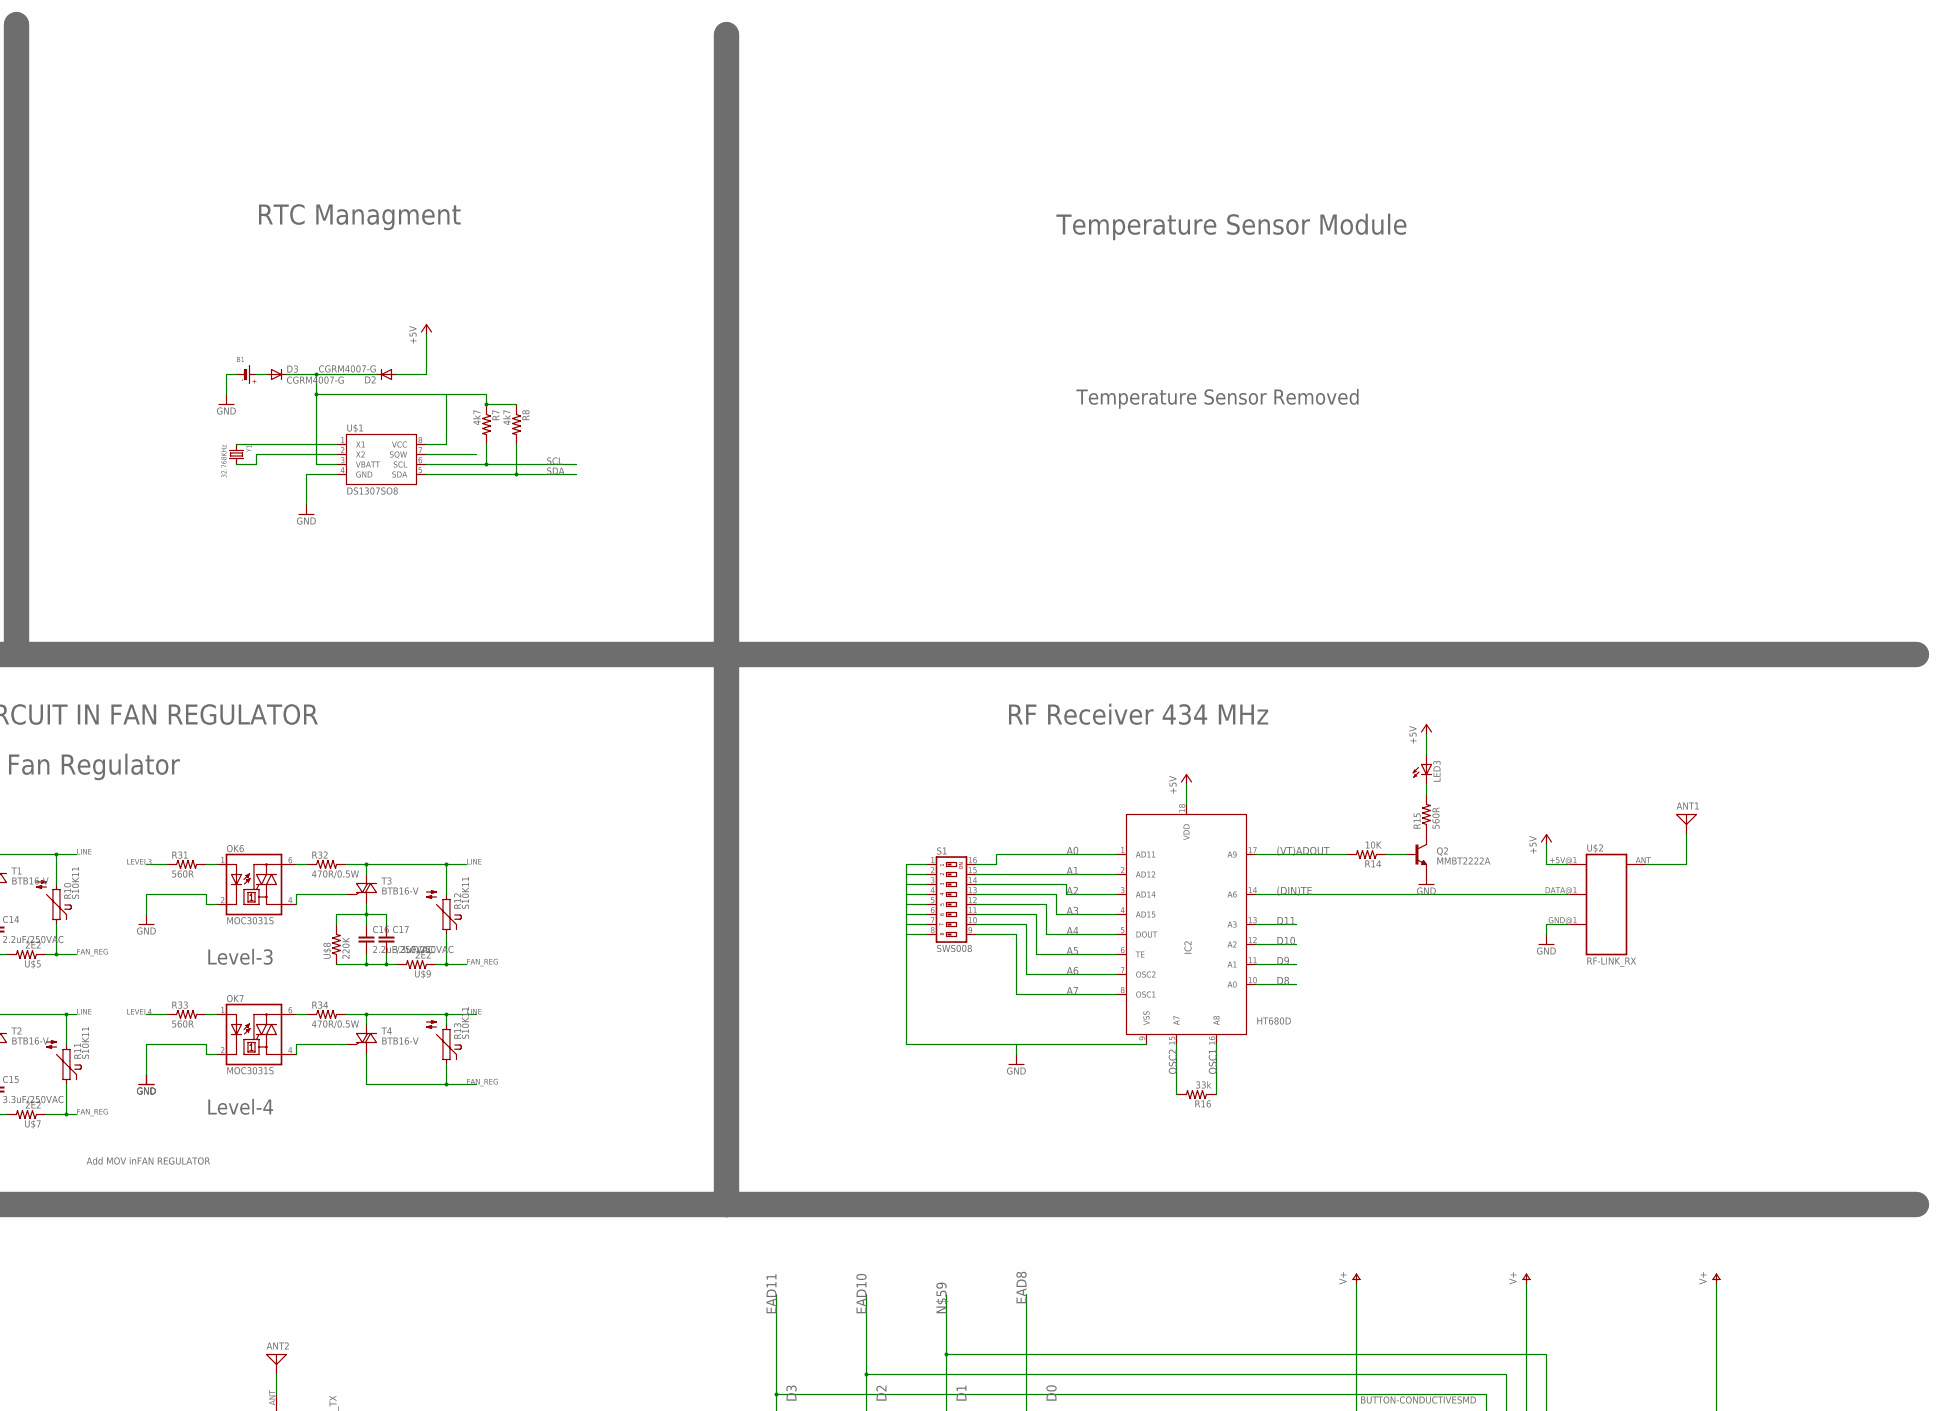
[picture p42: schematic 8ModuleBoard_vr2.sch, part in row 1, column 2]

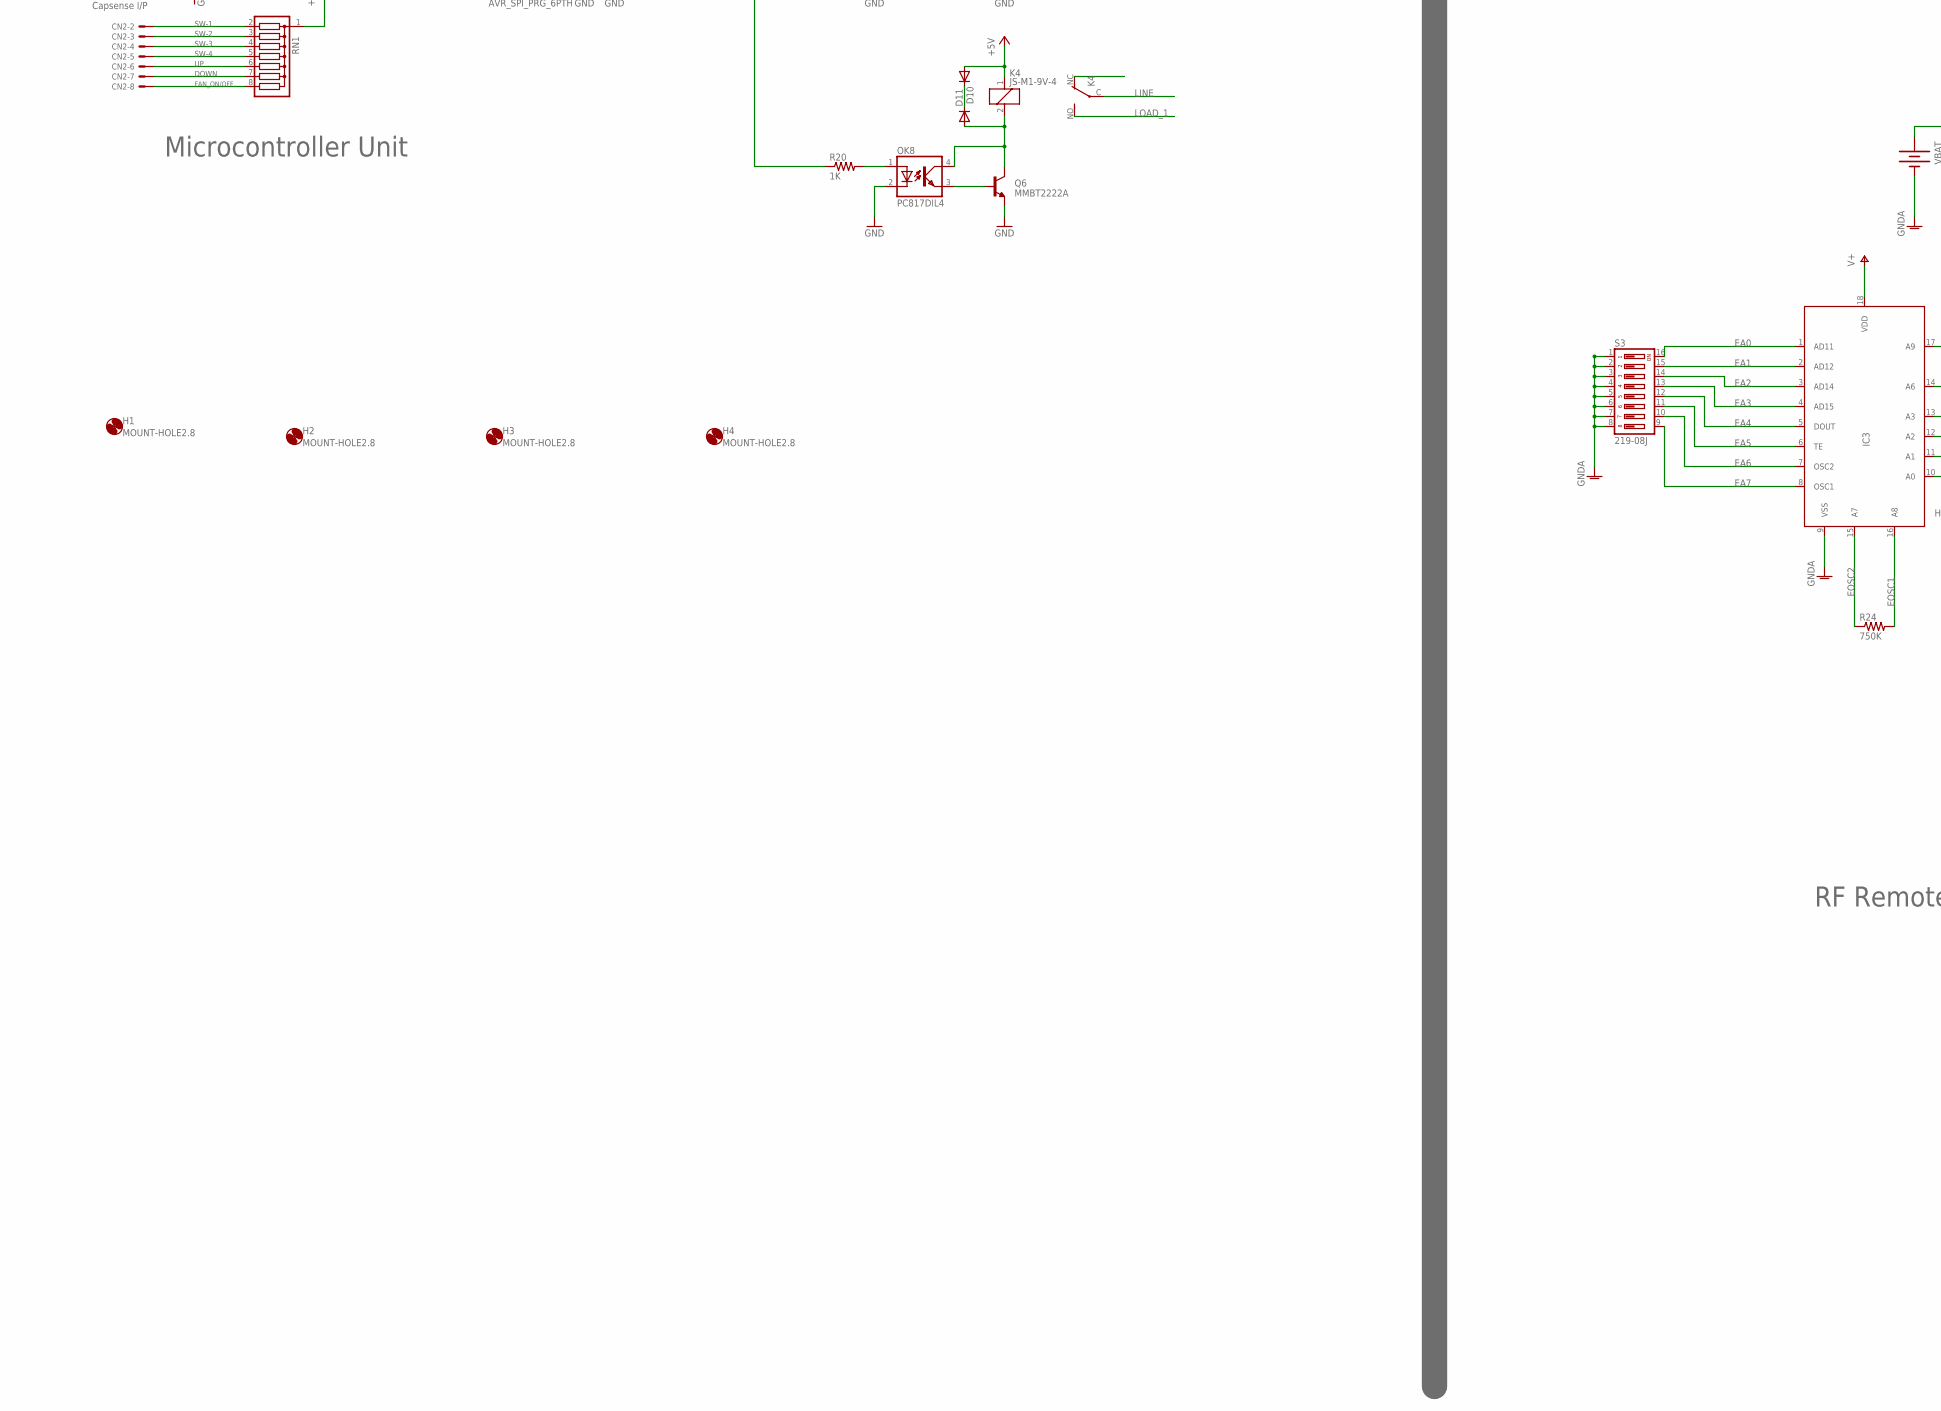
[picture p43: schematic 8ModuleBoard_vr2.sch, part in row 2, column 1]

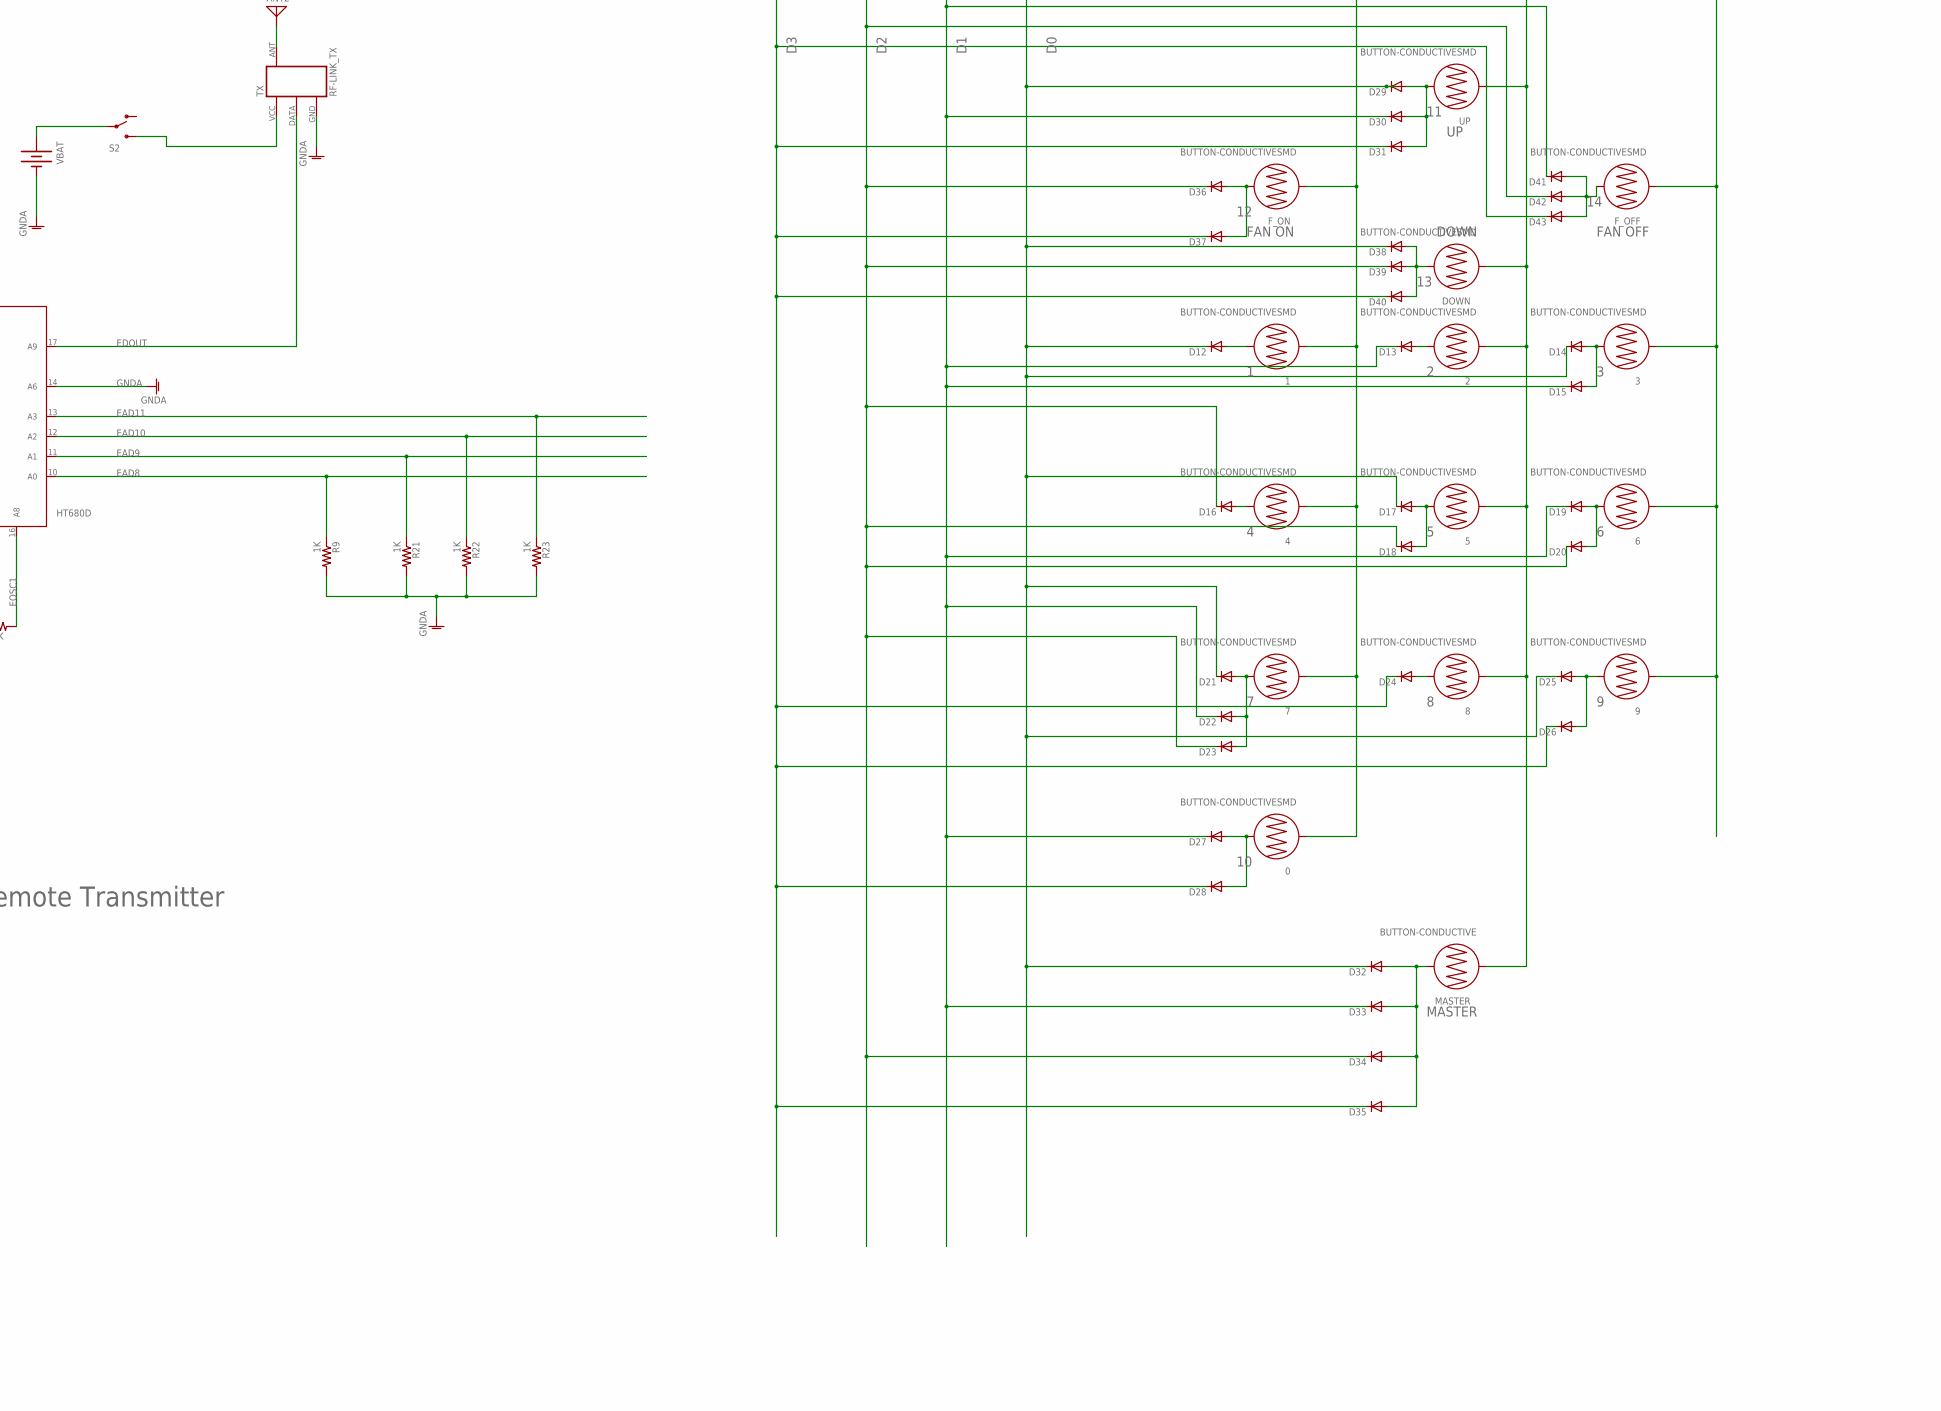
[picture p44: schematic 8ModuleBoard_vr2.sch, part in row 2, column 2]

Parts:
0, 1, 2, 3, 4, 5, 6, 7, 8, 9: BUTTON-CONDUCTIVESMD; BUTTON-CONDUCTIVE
AC: AK300/2
ANT1, ANT2: ANTENNA; PAD-01
ATMEGA32U4: ATMEGA32U4TQFP-44; TQFP44
B1: BATTERYCR2032; CR2032
C1: 470uF/25V; E5-8,5
C3, C6, C18, C19: 0.1uF; 1206
C4, C5: 10uF; EIA3216
C7: 1uF; 1206
C8, C9: 18pF; 1206
C14, C16: 2.2uF/250VAC; C27.5B9
C15, C17: 3.3uF/250VAC; C27.5B9
CN2: Capsense I/P; 22-23-2081
D1: SUPPRESSOR-SMBJ; SMBJ
D2, D3: CGRM4007-G; SOD-123_MINI-SMA
D4, D5, D6, D7, D8, D9, D10, D11, D12, D13, D14, D15, D16, D17, D18, D19, D20, D21, D22, D23, D24, D25, D26, D27, D28, D29, D30, D31, D32, D33, D34, D35, D36, D37, D38, D39, D40, D41, D42, D43: DIODE-SOD123; SOD123
DOWN: BUTTON-CONDUCTIVESMD; BUTTON-CONDUCTIVE
F1: PFUSE 1A; MF-5,1B
F_OFF: BUTTON-CONDUCTIVESMD; BUTTON-CONDUCTIVE
F_ON: BUTTON-CONDUCTIVESMD; BUTTON-CONDUCTIVE
H1, H2, H3, H4: MOUNT-HOLE2.8; 2,8
IC1: V_REG_LM1117SOT223; SOT223
IC2, IC3: HT680D; SOP18
JP1: AVR_SPI_PRG_6PTH; 2X3
K1, K2, K3, K4: JS-M1-9V-4; JS-M
LED1, LED2, LED3: LEDSML1206; SML1206
LOAD_CN: AK300/8
MASTER: BUTTON-CONDUCTIVE; BUTTON-CONDUCTIVE-MINI
OK1, OK2, OK3, OK8: PC817DIL4; DIL4-SMD
OK4: MOC3031S; DIL6-SMD
OK5, OK6, OK7: MOC3031S; DIL6-SMD; MPN MOC3031SM
Q1: 16MHz; HC49UP
Q2, Q3, Q4, Q5, Q6: MMBT2222A; SOT23-3
R1: MOV300V; S10K11
R2, R3, R4, R5, R9, R17, R18, R19, R20, R21, R22, R23: 1K; 1206
R6, R14: 10K; 1206
R7, R8: 4k7; 1206
R10, R11, R12, R13: S10K11
R15, R27, R29, R31, R33: 560R; 1206
R16: 33k; 1206
R24: 750K; 1206
R28, R30, R32, R34: 470R/0.5W; 0411V
RN1: G07R; SIL8
S1: SWS008; SMS-008
S2: SWITCH-SPDT-SMD-A; SWITCH-SPST-SMD-A
S3: 219-08J; CTS-219-08J
SMPS_5V@2A: 5V@2A; MKS1854-6-0-404
T1, T2, T3, T4: BTB16-V; TO220BV
TX: RF-LINK_TX
U$1: DS1307SO8; SO08
U$2: RF-LINK_RX
U$3: HM-11
U$4, U$6, U$8: 220K; 1206
U$5, U$7, U$9: 2E2; 1206
UP: BUTTON-CONDUCTIVESMD; BUTTON-CONDUCTIVE
VBAT: BATTERY20SMD; BATTCON_20MM
X1: 22-23-2031
Y1: 32.768KHz; CRYSTAL_CYL_2X6MM_SMT

Connections:
!RESET: ATMEGA32U4.13 (!RESET), JP1.1, R6.1, U$3.UART_RTS
(DIN)TE: IC2.14 (A6), U$2.DATA@1 (DATA)
(VT)ADOUT: IC2.17 (A9), R14.2
+3V3: C5.A (+), IC1.2 (OUT), IC1.4 (OUT), U$3.VCC
+5V: ATMEGA32U4.2 (UVCC), ATMEGA32U4.7 (VBUS), ATMEGA32U4.14 (VCC), ATMEGA32U4.24 (AVCC), ATMEGA32U4.34 (VCC), ATMEGA32U4.44 (AVCC), C1.+, C3.1, C4.A (+), C18.1, C19.2, D1.C, D2.A, D4.A, D6.A, D8.A, D10.A, IC1.3 (IN), IC2.18 (VDD), JP1.2, K1.1, K2.1, K3.1, K4.1, LED3.A, R2.1, R6.2, RN1.1, SMPS_5V@2A.3 (V+), U$2.+5V@1 (+5V), X1.1
A0: IC2.1 (AD11), S1.16
A1: IC2.2 (AD12), S1.15
A2: IC2.3 (AD14), S1.14
A3: IC2.4 (AD15), S1.13
A4: IC2.5 (DOUT), S1.12
A5: IC2.6 (TE), S1.11
A6: IC2.7 (OSC2), S1.10
A7: IC2.8 (OSC1), S1.9
BLE_STATUS: R3.2, U$3.PIO1
D8: ATMEGA32U4.38 (PF5(ADC5)), IC2.10 (A0)
D9: ATMEGA32U4.39 (PF4(ADC4)), IC2.11 (A1)
D10: ATMEGA32U4.40 (PF1(ADC1)), IC2.12 (A2)
D11: ATMEGA32U4.41 (PF0(ADC0)), IC2.13 (A3)
DOWN: ATMEGA32U4.29 (PB5(ADC12)), CN2.7, RN1.7
EA0: IC3.1 (AD11), S3.16
EA1: IC3.2 (AD12), S3.15
EA2: IC3.3 (AD14), S3.14
EA3: IC3.4 (AD15), S3.13
EA4: IC3.5 (DOUT), S3.12
EA5: IC3.6 (TE), S3.11
EA6: IC3.7 (OSC2), S3.10
EA7: IC3.8 (OSC1), S3.9
EAD8: D12.C, D14.C, D17.C, D21.C, D25.C, D29.C, D32.C, D38.C, IC3.10 (A0), R9.1
EAD9: IC3.11 (A1), R21.1
EAD10: D16.C, D18.C, D20.C, D23.C, D34.C, D36.C, D39.C, D42.C, IC3.12 (A2), R22.1
EAD11: D24.C, D26.C, D28.C, D31.C, D35.C, D37.C, D40.C, D43.C, IC3.13 (A3), R23.1
EDOUT: IC3.17 (A9), TX.DATA
EOSC1: IC3.16 (A8), R24.2
EOSC2: IC3.15 (A7), R24.1
FAN_ON/OFF: ATMEGA32U4.30 (PB6(ADC13)), CN2.8, RN1.8
FAN_REG: LOAD_CN.8, R10.1, R11.1, R12.1, R13.1, T4.T1 (A1), U$5.1, U$7.1, U$9.1
GND: ATMEGA32U4.5 (UGND), ATMEGA32U4.15 (GND), ATMEGA32U4.23 (GND), ATMEGA32U4.33 (PE2/!HWB), ATMEGA32U4.35 (GND), ATMEGA32U4.43 (GND), B1.-, C1.-, C3.2, C4.C (-), C5.C (-), C6.2, C7.1, C8.1, C9.1, C18.2, C19.1, CN2.1, D1.A, IC1.1 (ADJ), IC2.9 (VSS), JP1.6, LED1.C, LED2.C, OK1.2 (C), OK2.2 (C), OK3.2 (C), OK4.2 (C), OK5.2 (C), OK6.2 (C), OK7.2 (C), OK8.2 (C), Q2.2 (E), Q3.2 (E), Q4.2 (E), Q5.2 (E), Q6.2 (E), S1.1, S1.2, S1.3, S1.4, S1.5, S1.6, S1.7, S1.8, SMPS_5V@2A.4 (GND), U$1.4 (GND), U$2.GND@1 (GND), U$3.GND, X1.2
GNDA: IC3.9 (VSS), IC3.14 (A6), R9.2, R21.2, R22.2, R23.2, S3.1, S3.2, S3.3, S3.4, S3.5, S3.6, S3.7, S3.8, TX.GND, VBAT.2 (-)
LEVEL1: ATMEGA32U4.31 (PC6), R27.1
LEVEL2: ATMEGA32U4.32 (PC7), R29.1
LEVEL3: ATMEGA32U4.36 (PF7(ADC7)), R31.1
LEVEL4: ATMEGA32U4.37 (PF6(ADC6)), R33.1
LINE: F1.1, K1.C, K2.C, K3.C, K4.C, LOAD_CN.1, R1.2, R10.2, R11.2, R12.2, R13.2, R28.2, R30.2, R32.2, R34.2, SMPS_5V@2A.1 (L), T1.T2 (A2), T2.T2 (A2), T3.T2 (A2), T4.T2 (A2)
LOAD_1: K4.NO (S), LOAD_CN.4
LOAD_2: K1.NO (S), LOAD_CN.5
LOAD_3: K2.NO (S), LOAD_CN.6
MISO: ATMEGA32U4.11 (PB3(MISO)), JP1.3, R20.1
MOSI: ATMEGA32U4.10 (PB2(MOSI)), JP1.5, R19.1
unnamed: OK6.1 (A), R31.2
unnamed: OK4.1 (A), R27.2
unnamed: OK5.1 (A), R29.2
unnamed: OK4.6 (A2), R28.1
unnamed: OK7.1 (A), R33.2
unnamed: R4.2, U$3.UART_TX
unnamed: ATMEGA32U4.6 (UCAP), C7.2
unnamed: Q2.1 (B), R14.1
unnamed: LED2.A, R3.1
unnamed: ATMEGA32U4.42 (AREF), C6.1
unnamed: R5.2, U$3.UART_RX
unnamed: U$1.1 (X1), Y1.1
unnamed: U$1.2 (X2), Y1.2
unnamed: D2.C, D3.C, R7.1, R8.1, U$1.3 (VBATT), U$1.8 (VCC)
unnamed: LED1.A, R2.2
unnamed: B1.+, D3.A
unnamed: 1.2, D12.A
unnamed: 2.2, D13.A
unnamed: ATMEGA32U4.16 (XTAL2), C8.2, Q1.2
unnamed: ATMEGA32U4.17 (XTAL1), C9.2, Q1.1
unnamed: Q2.3 (C), R15.1
unnamed: S2.2, VBAT.1 (+)
unnamed: LED3.C, R15.2
unnamed: S2.3 (S), TX.VCC (+5V)
unnamed: OK5.6 (A2), R30.1
unnamed: OK6.6 (A2), R32.1
unnamed: ANT1.1, U$2.ANT
unnamed: OK1.3 (EMIT), Q3.1 (B)
unnamed: D5.A, K1.2, OK1.4 (COL), Q3.3 (C)
unnamed: OK7.6 (A2), R34.1
unnamed: 3.2, D14.A, D15.A
unnamed: AC.1, F1.2
unnamed: D4.C, D5.C
unnamed: ANT2.1, TX.ANT
unnamed: OK1.1 (A), R17.2
unnamed: 4.2, D16.A
unnamed: OK2.3 (EMIT), Q4.1 (B)
unnamed: 5.2, D17.A, D18.A
unnamed: D7.A, K2.2, OK2.4 (COL), Q4.3 (C)
unnamed: D6.C, D7.C
unnamed: 6.2, D19.A, D20.A
unnamed: 7.2, D21.A, D22.A, D23.A
unnamed: OK2.1 (A), R18.2
unnamed: OK3.3 (EMIT), Q5.1 (B)
unnamed: 0.2, D27.A, D28.A
unnamed: D9.A, K3.2, OK3.4 (COL), Q5.3 (C)
unnamed: OK4.4 (A1), T1.G
unnamed: C14.1, T1.T1 (A1), U$4.2
unnamed: C14.2, U$4.1, U$5.2
unnamed: D8.C, D9.C
unnamed: D13.C, D15.C, D19.C, D22.C, D27.C, D30.C, D33.C, D41.C
unnamed: D29.A, D30.A, D31.A, UP.2
unnamed: 8.2, D24.A
unnamed: OK5.4 (A1), T2.G
unnamed: C15.1, T2.T1 (A1), U$6.2
unnamed: C15.2, U$6.1, U$7.2
unnamed: OK3.1 (A), R19.2
unnamed: OK8.3 (EMIT), Q6.1 (B)
unnamed: D11.A, K4.2, OK8.4 (COL), Q6.3 (C)
unnamed: D36.A, D37.A, F_ON.2
unnamed: D10.C, D11.C
unnamed: OK6.4 (A1), T3.G
unnamed: C16.1, C17.1, T3.T1 (A1), U$8.2
unnamed: C16.2, C17.2, U$8.1, U$9.2
unnamed: 9.2, D25.A, D26.A
unnamed: D38.A, D39.A, D40.A, DOWN.2
unnamed: D32.A, D33.A, D34.A, D35.A, MASTER.2
unnamed: OK8.1 (A), R20.2
unnamed: OK7.4 (A1), T4.G
unnamed: D41.A, D42.A, D43.A, F_OFF.2
unnamed: ATMEGA32U4.8 (PB0(SS)), R17.1
NEUTRAL: AC.2, LOAD_CN.2, LOAD_CN.3, R1.1, SMPS_5V@2A.2 (N)
OSC1: IC2.16 (A8), R16.1
OSC2: IC2.15 (A7), R16.2
PLUG_CONTROL: K3.NO (S), LOAD_CN.7
RX: ATMEGA32U4.21 (PD3(TX)), R5.1
SCK: ATMEGA32U4.9 (PB1(SCK)), JP1.4, R18.1
SCL: ATMEGA32U4.18 (PD0(SCL)), R7.2, U$1.6 (SCL)
SDA: ATMEGA32U4.19 (PD1(SDA)), R8.2, U$1.5 (SDA)
SW-1: ATMEGA32U4.22 (PD5), CN2.2, RN1.2
SW-2: ATMEGA32U4.25 (PD4(ADC8)), CN2.3, RN1.3
SW-3: ATMEGA32U4.26 (PD6(ADC9)), CN2.4, RN1.4
SW-4: ATMEGA32U4.27 (PD7(ADC10)), CN2.5, RN1.5
TX: ATMEGA32U4.20 (PD2(RX)), R4.1
UP: ATMEGA32U4.28 (PB4(ADC11)), CN2.6, RN1.6
V+: 0.1, 1.1, 2.1, 3.1, 4.1, 5.1, 6.1, 7.1, 8.1, 9.1, DOWN.1, F_OFF.1, F_ON.1, IC3.18 (VDD), MASTER.1, UP.1

Notes on the sheet:
Microcontroller Unit
Level-1
Level-2
Level-3
Level-4
Fan Regulator
Bluetooth Section
Add MOV inFAN REGULATOR
RTC Managment
Temperature Sensor Module
RF Receiver 434 MHz
Temperature Sensor Removed
MASTER
FAN ON
FAN OFF
DOWN
RF Remote Transmitter
ADD RC SNUBBER CIRCUIT IN FAN REGULATOR

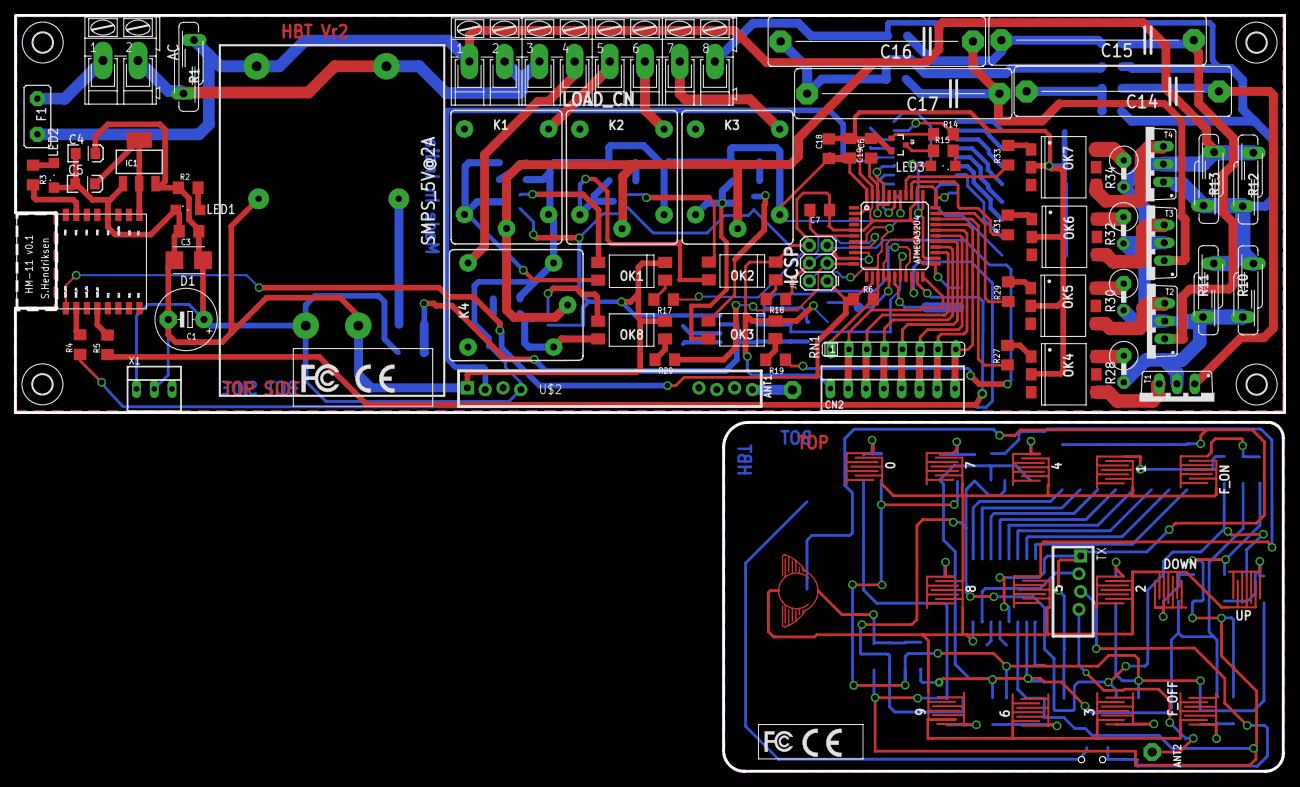
[picture p45: board 8ModuleBoard_vr2.brd from above]

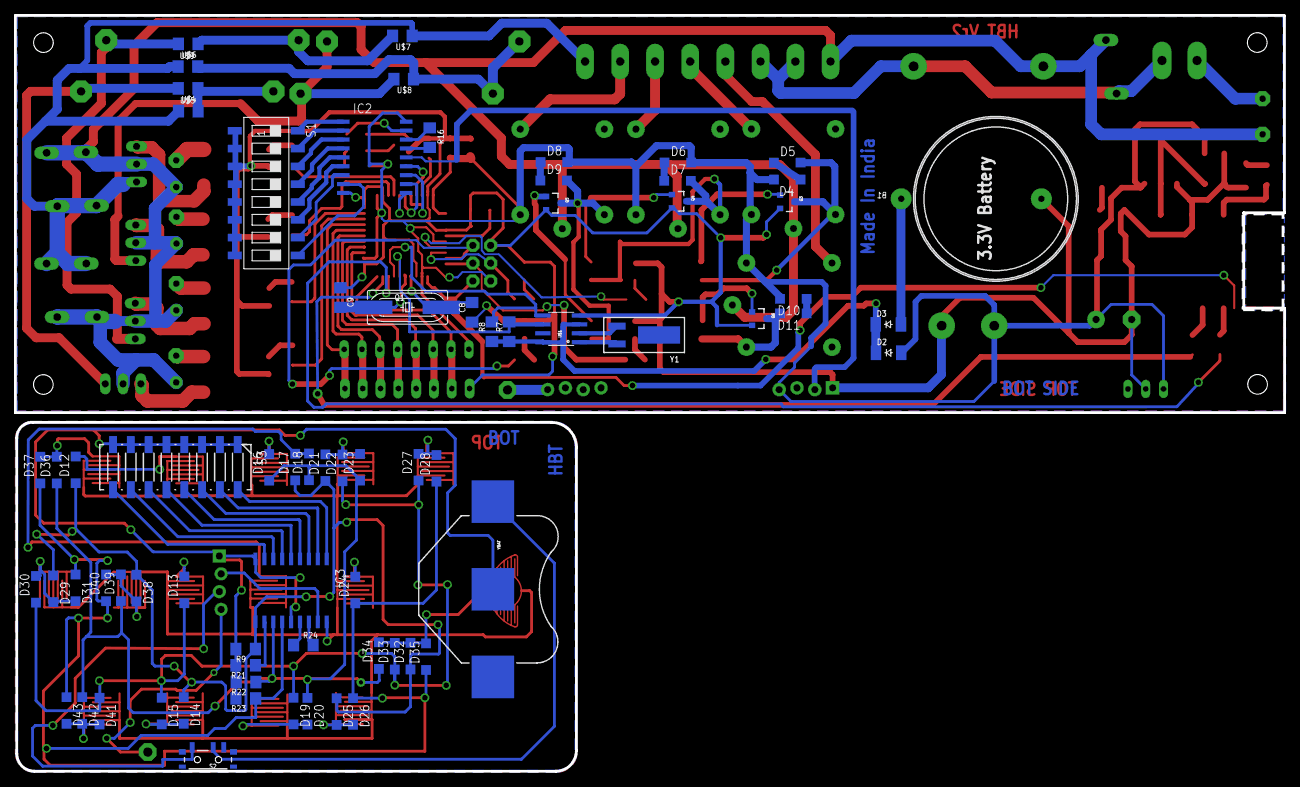
[picture p46: board 8ModuleBoard_vr2.brd from below]

Board: 2 copper layers, 181.0 x 107.8 mm, 167 parts (71 on the bottom side), 134 nets.

Other parts of the board:
U$10, U$13: CE-4MM
U$11: FCC_6.1X15MM
U$12: FCC_20X8.35MM
