nmaiti/smartswitchboard/Hardware/4Key1SliderCapsenseDesign/4key1SliderCapsenseDesign.brd

## EAGLE design Hardware/4Key1SliderCapsenseDesign/4key1SliderCapsenseDesign.brd (2015-12-22)

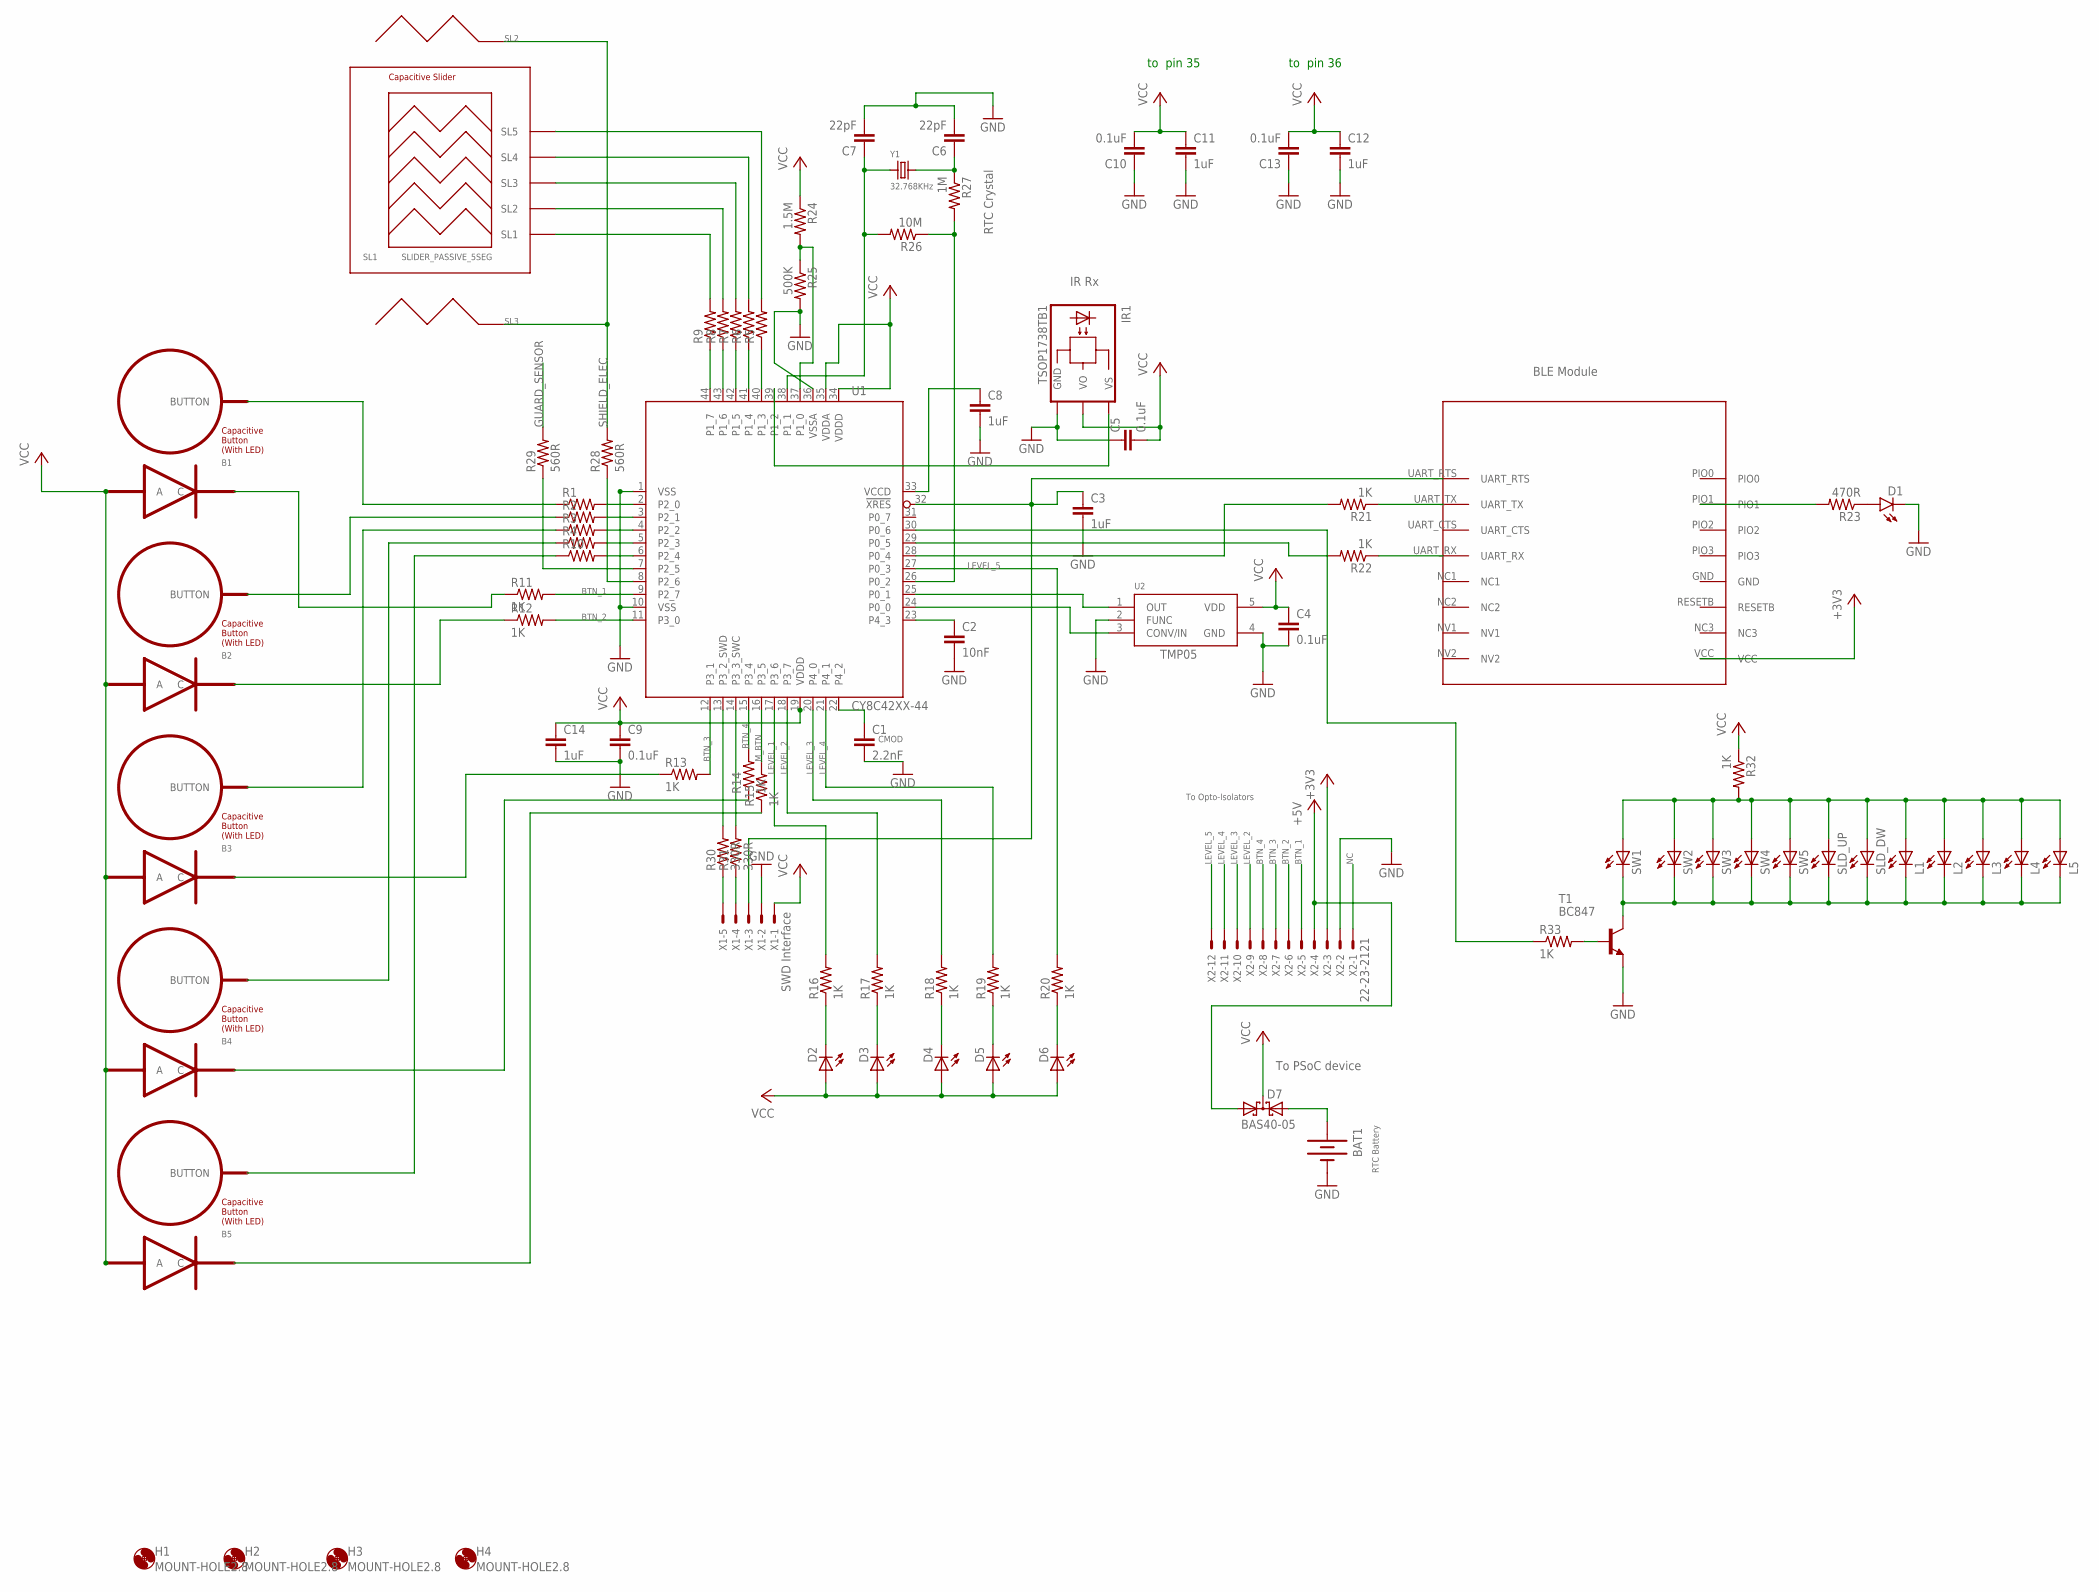
[picture p47: schematic 4key1SliderCapsenseDesign.sch]

Parts:
B1, B2, B3, B4, B5: BUTTON_PASSIVE_LED; BUTTON_PASSIVE_12MM_LED
BAT1: BATTERY245MM; BATTCON_245MM
C1: 2.2nF; 1206
C2: 10nF; 1206
C3, C8, C11, C12, C14: 1uF; 1206
C4, C5, C9, C10, C13: 0.1uF; 1206
C6, C7: 22pF; 1206
D1: LED1206-BOTTOM; LED-1206-BOTTOM
D2, D3, D4, D5, D6: LEDCHIP-LED0805; CHIP-LED0805
D7: BAS40-05; SOT23
H1, H2, H3, H4: MOUNT-HOLE2.8; 2,8
IR1: TSOP1738TB1; TSOP17_TB1
L1, L2, L3, L4, L5: LEDCHIPLED_1206; CHIPLED_1206
R1, R2, R3, R4, R5, R6, R7, R8, R9, R10: RESISTOR1206; 1206
R11, R12, R13, R14, R15, R16, R17, R18, R19, R20, R21, R22, R32, R33: 1K; 1206
R23: 470R; 1206
R24: 1.5M; 1206
R25: 500K; 1206
R26: 10M; 1206
R27: 1M; 1206
R28, R29: 560R; 1206
R30, R31: 330R; 1206
SL1: SLIDER_PASSIVE_5SEG; SLIDER_PASSIVE_5SEG_12MM
SL2, SL3: SLIDER_PASSIVE_1SEG; SLIDER_PASSIVE_1SEG_12MM
SLD_DW: LEDCHIPLED_1206; CHIPLED_1206
SLD_UP: LEDCHIPLED_1206; CHIPLED_1206
SW1, SW2, SW3, SW4, SW5: LEDCHIPLED_1206; CHIPLED_1206
T1: BC847; SOT23
U1: CY8C42XX-44; TQFP-10X10-44
U2: NCP1400A_STEPUP; SOT23-5
U$1: HM-11
X1: SWD Interface; 22-23-2051
X2: 22-23-2121
Y1: 32.768KHz; CRYSTAL_CYL_2X6MM_SMT

Connections:
+3V3: U$1.VCC, X2.3
+5V: D7.1 (A1), X2.4
BTN_1: R11.2, U1.9 (P2_7), X2.5
BTN_2: R12.2, U1.11 (P3_0), X2.6
BTN_3: R13.2, U1.12 (P3_1), X2.7
BTN_4: R14.2, U1.15 (P3_4), X2.8
GND: BAT1.2 (-), C1.2, C2.2, C3.2, C4.2, C5.1, C6.2, C7.2, C8.2, C9.2, C10.1, C11.2, C12.2, C13.1, C14.2, D1.C, IR1.GND, R25.2, T1.2 (E), U1.1 (VSS), U1.10 (VSS), U1.36 (VSSA), U2.2 (FUNC), U2.4 (GND), X1.2, X2.2
GUARD_SENSOR: R29.1, R29.2, U1.7 (P2_5)
LEVEL_1: R16.2, U1.17 (P3_6)
LEVEL_2: R17.2, U1.18 (P3_7), X2.9
LEVEL_3: R18.2, U1.20 (P4_0), X2.10
LEVEL_4: R19.2, U1.21 (P4_1), X2.11
LEVEL_5: R20.2, U1.27 (P0_3), X2.12
M_BTN: R15.2, U1.16 (P3_5)
unnamed: C1.1, U1.22 (P4_2)
unnamed: R1.2, U1.2 (P2_0)
unnamed: C2.1, U1.23 (P4_3)
unnamed: R2.2, U1.3 (P2_1)
unnamed: R3.2, U1.4 (P2_2)
unnamed: R4.2, U1.5 (P2_3)
unnamed: B1.BUTTON, R1.1
unnamed: B2.BUTTON, R2.1
unnamed: B3.BUTTON, R3.1
unnamed: B4.BUTTON, R4.1
unnamed: R10.2, U1.6 (P2_4)
unnamed: B5.BUTTON, R10.1
unnamed: R5.1, U1.40 (P1_3)
unnamed: R6.1, U1.41 (P1_4)
unnamed: R7.1, U1.42 (P1_5)
unnamed: R8.1, U1.43 (P1_6)
unnamed: R9.1, U1.44 (P1_7)
unnamed: R9.2, SL1.SL1
unnamed: R8.2, SL1.SL2
unnamed: R7.2, SL1.SL3
unnamed: R6.2, SL1.SL4
unnamed: R5.2, SL1.SL5
unnamed: R28.1, U1.8 (P2_6)
unnamed: B1.C, R11.1
unnamed: B2.C, R12.1
unnamed: B3.C, R13.1
unnamed: B4.C, R14.1
unnamed: B5.C, R15.1
unnamed: R30.2, U1.13 (P3_2_SWD)
unnamed: C8.1, U1.33 (VCCD)
unnamed: R30.1, X1.5
unnamed: R31.2, U1.14 (P3_3_SWC)
unnamed: R31.1, X1.4
unnamed: L1.A, L2.A, L3.A, L4.A, L5.A, R32.2, SLD_DW.A, SLD_UP.A, SW1.A, SW2.A, SW3.A, SW4.A, SW5.A
unnamed: D2.C, R16.1
unnamed: L1.C, L2.C, L3.C, L4.C, L5.C, SLD_DW.C, SLD_UP.C, SW1.C, SW2.C, SW3.C, SW4.C, SW5.C, T1.3 (C)
unnamed: D3.C, R17.1
unnamed: R33.2, T1.1 (B)
unnamed: BAT1.1 (+), D7.2 (A2)
unnamed: C3.1, U1.32 (!XRES), U$1.UART_RTS, X1.3
unnamed: R21.1, U$1.UART_TX
unnamed: R33.1, U1.30 (P0_6)
unnamed: R22.1, U$1.UART_RX
unnamed: R21.2, U1.28 (P0_4)
unnamed: R22.2, U1.29 (P0_5)
unnamed: D1.A, R23.1
unnamed: U1.24 (P0_0), U2.3 (CONV/IN)
unnamed: R23.2, U$1.PIO1
unnamed: U1.25 (P0_1), U2.1 (OUT)
unnamed: IR1.VS, U1.39 (P1_2)
unnamed: R24.2, R25.1, U1.37 (P1_0)
unnamed: R26.1, R27.2, U1.26 (P0_2)
unnamed: C6.1, R27.1, Y1.2
unnamed: C7.1, R26.2, U1.38 (P1_1), Y1.1
unnamed: D6.C, R20.1
unnamed: D5.C, R19.1
unnamed: D4.C, R18.1
NC: X2.1
SHIELD_ELEC: R28.2, SL2.S1, SL3.S1
VCC: B1.A, B2.A, B3.A, B4.A, B5.A, C4.1, C5.2, C9.1, C10.2, C11.1, C12.1, C13.2, C14.1, D2.A, D3.A, D4.A, D5.A, D6.A, D7.3 (C), IR1.VO, R24.1, R32.1, U1.19 (VDDD), U1.34 (VDDD), U1.35 (VDDA), U2.5 (VDD), X1.1

Notes on the sheet:
CMOD
TMP05
To Opto-Isolators
IR Rx
BLE Module
RTC Crystal
to pin 36
to pin 35
To PSoC device
RTC Battery

Board: 2 copper layers, 87 parts (35 on the bottom side), 73 nets, no tracks yet.
