nmaiti/smartswitchboard/Hardware/LightDimmer/TriacDimmer.brd

## EAGLE design Hardware/LightDimmer/TriacDimmer.brd (2015-08-11)

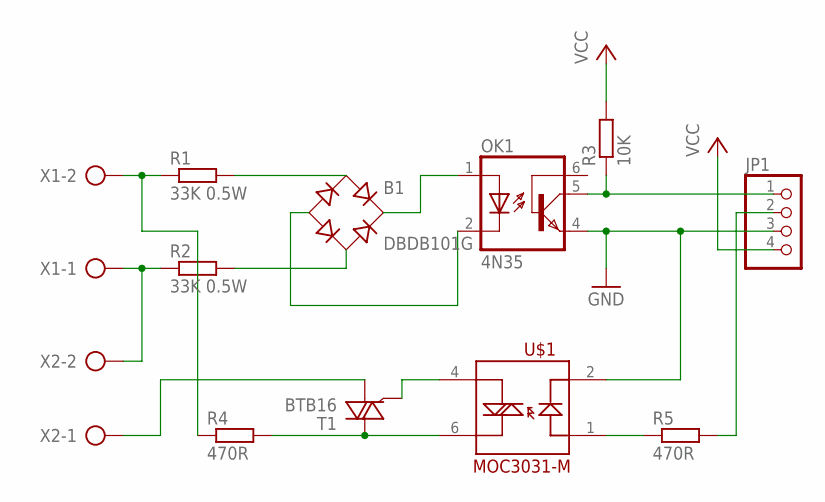
[picture p48: schematic TriacDimmer.sch]

Parts:
B1: DBDB101G; DB
JP1: PINHD-1X4; 1X04
OK1: 4N35; DIL06
R1, R2: 33K 0.5W; 0207/10
R3: 10K; 0207/10
R4, R5: 470R; 0207/10
T1: BTB16; TO220BV
U$1: MOC3031-M; DIL06
X1, X2: AK300/2

Connections:
GND: JP1.3, OK1.4 (EMI), U$1.2
unnamed: R1.1, R4.1, X1.2
unnamed: R2.1, X1.1, X2.2
unnamed: B1.AC1, R1.2
unnamed: B1.AC2, R2.2
unnamed: B1.+, OK1.1 (A)
unnamed: B1.-, OK1.2 (C)
unnamed: JP1.1, OK1.5 (COL), R3.1
unnamed: JP1.2, R5.2
unnamed: R4.2, T1.T2 (A2), U$1.6
unnamed: T1.G, U$1.4
unnamed: T1.T1 (A1), X2.1
unnamed: R5.1, U$1.1
VCC: JP1.4, R3.2

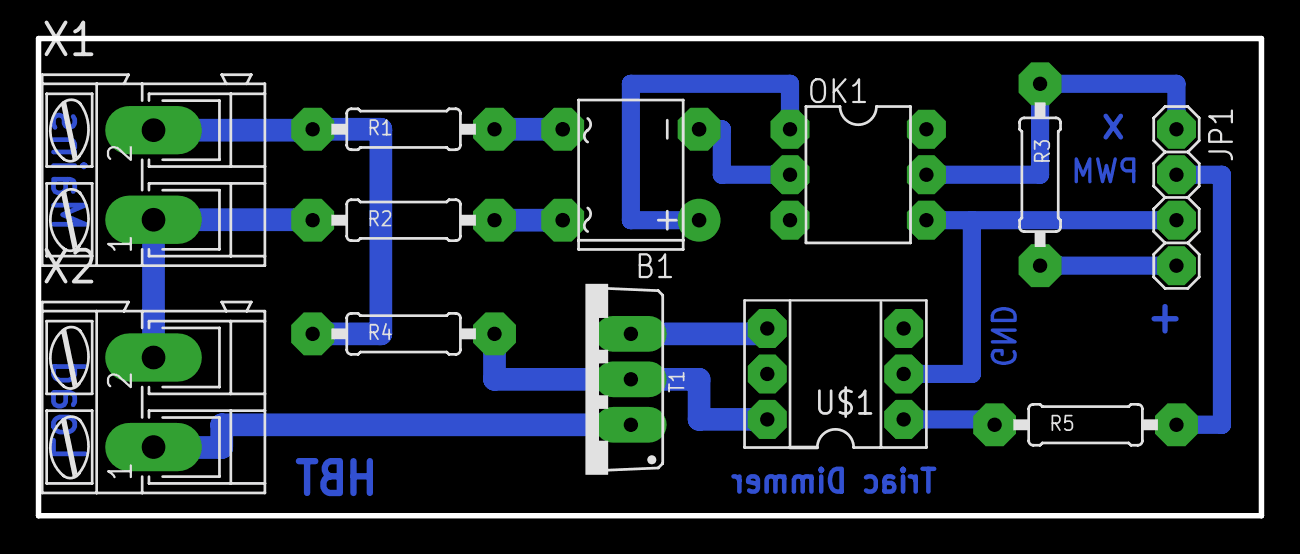
[picture p49: board TriacDimmer.brd from above]

Board: 2 copper layers, 68.3 x 26.7 mm, 12 parts (0 on the bottom side), 14 nets.
