nmaiti/smartswitchboard/Hardware/8ModuleRealyProtoBoard/untitled.brd

## EAGLE design Hardware/8ModuleRealyProtoBoard/untitled.brd (2016-08-19)

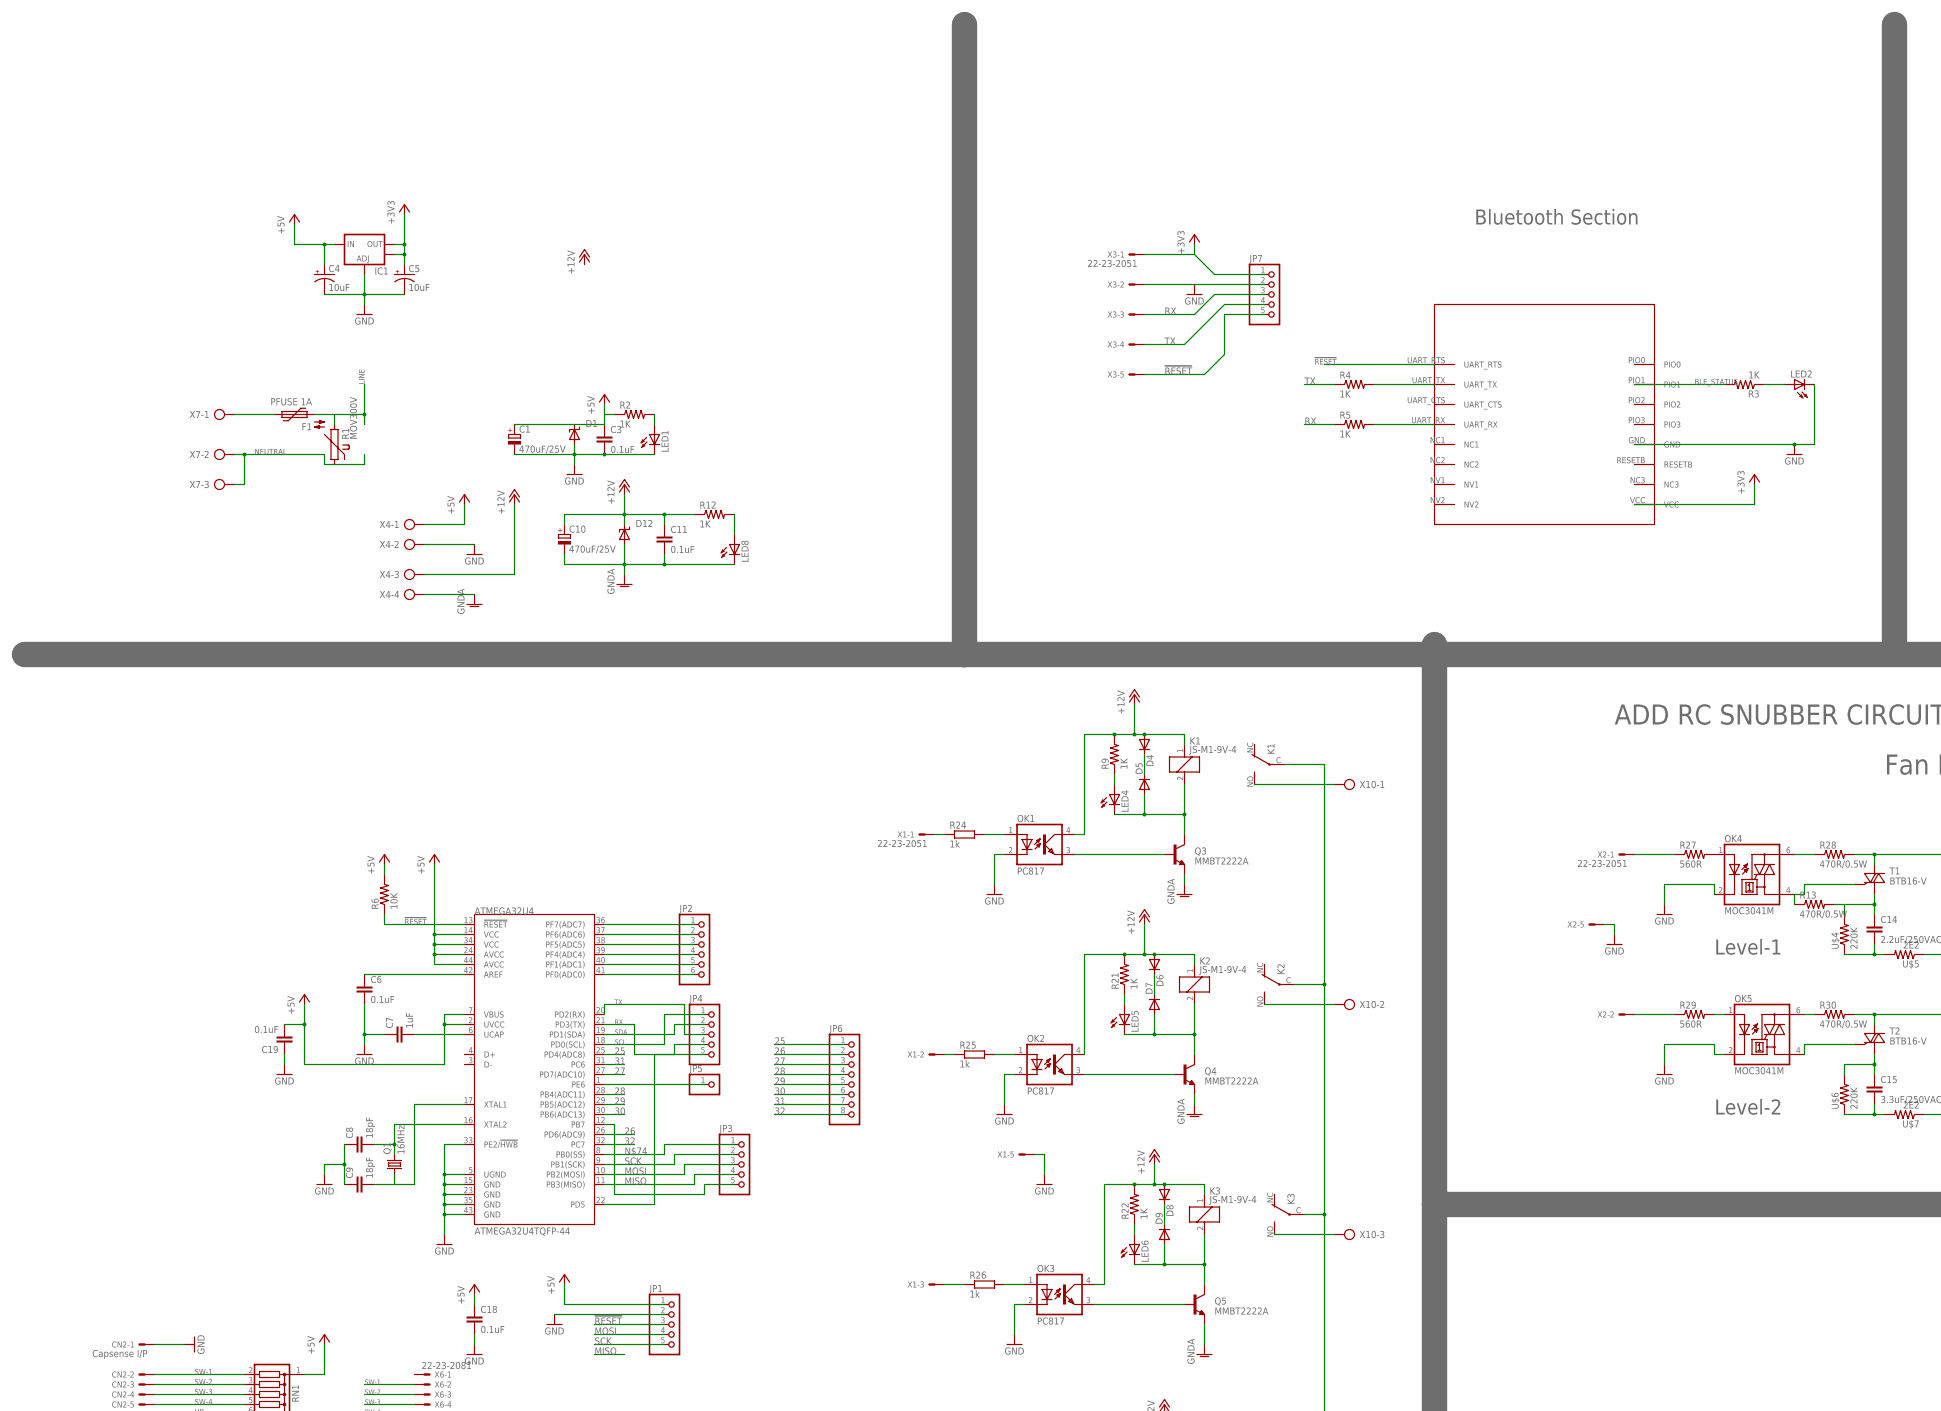
[picture p50: schematic untitled.sch, part in row 1, column 1]

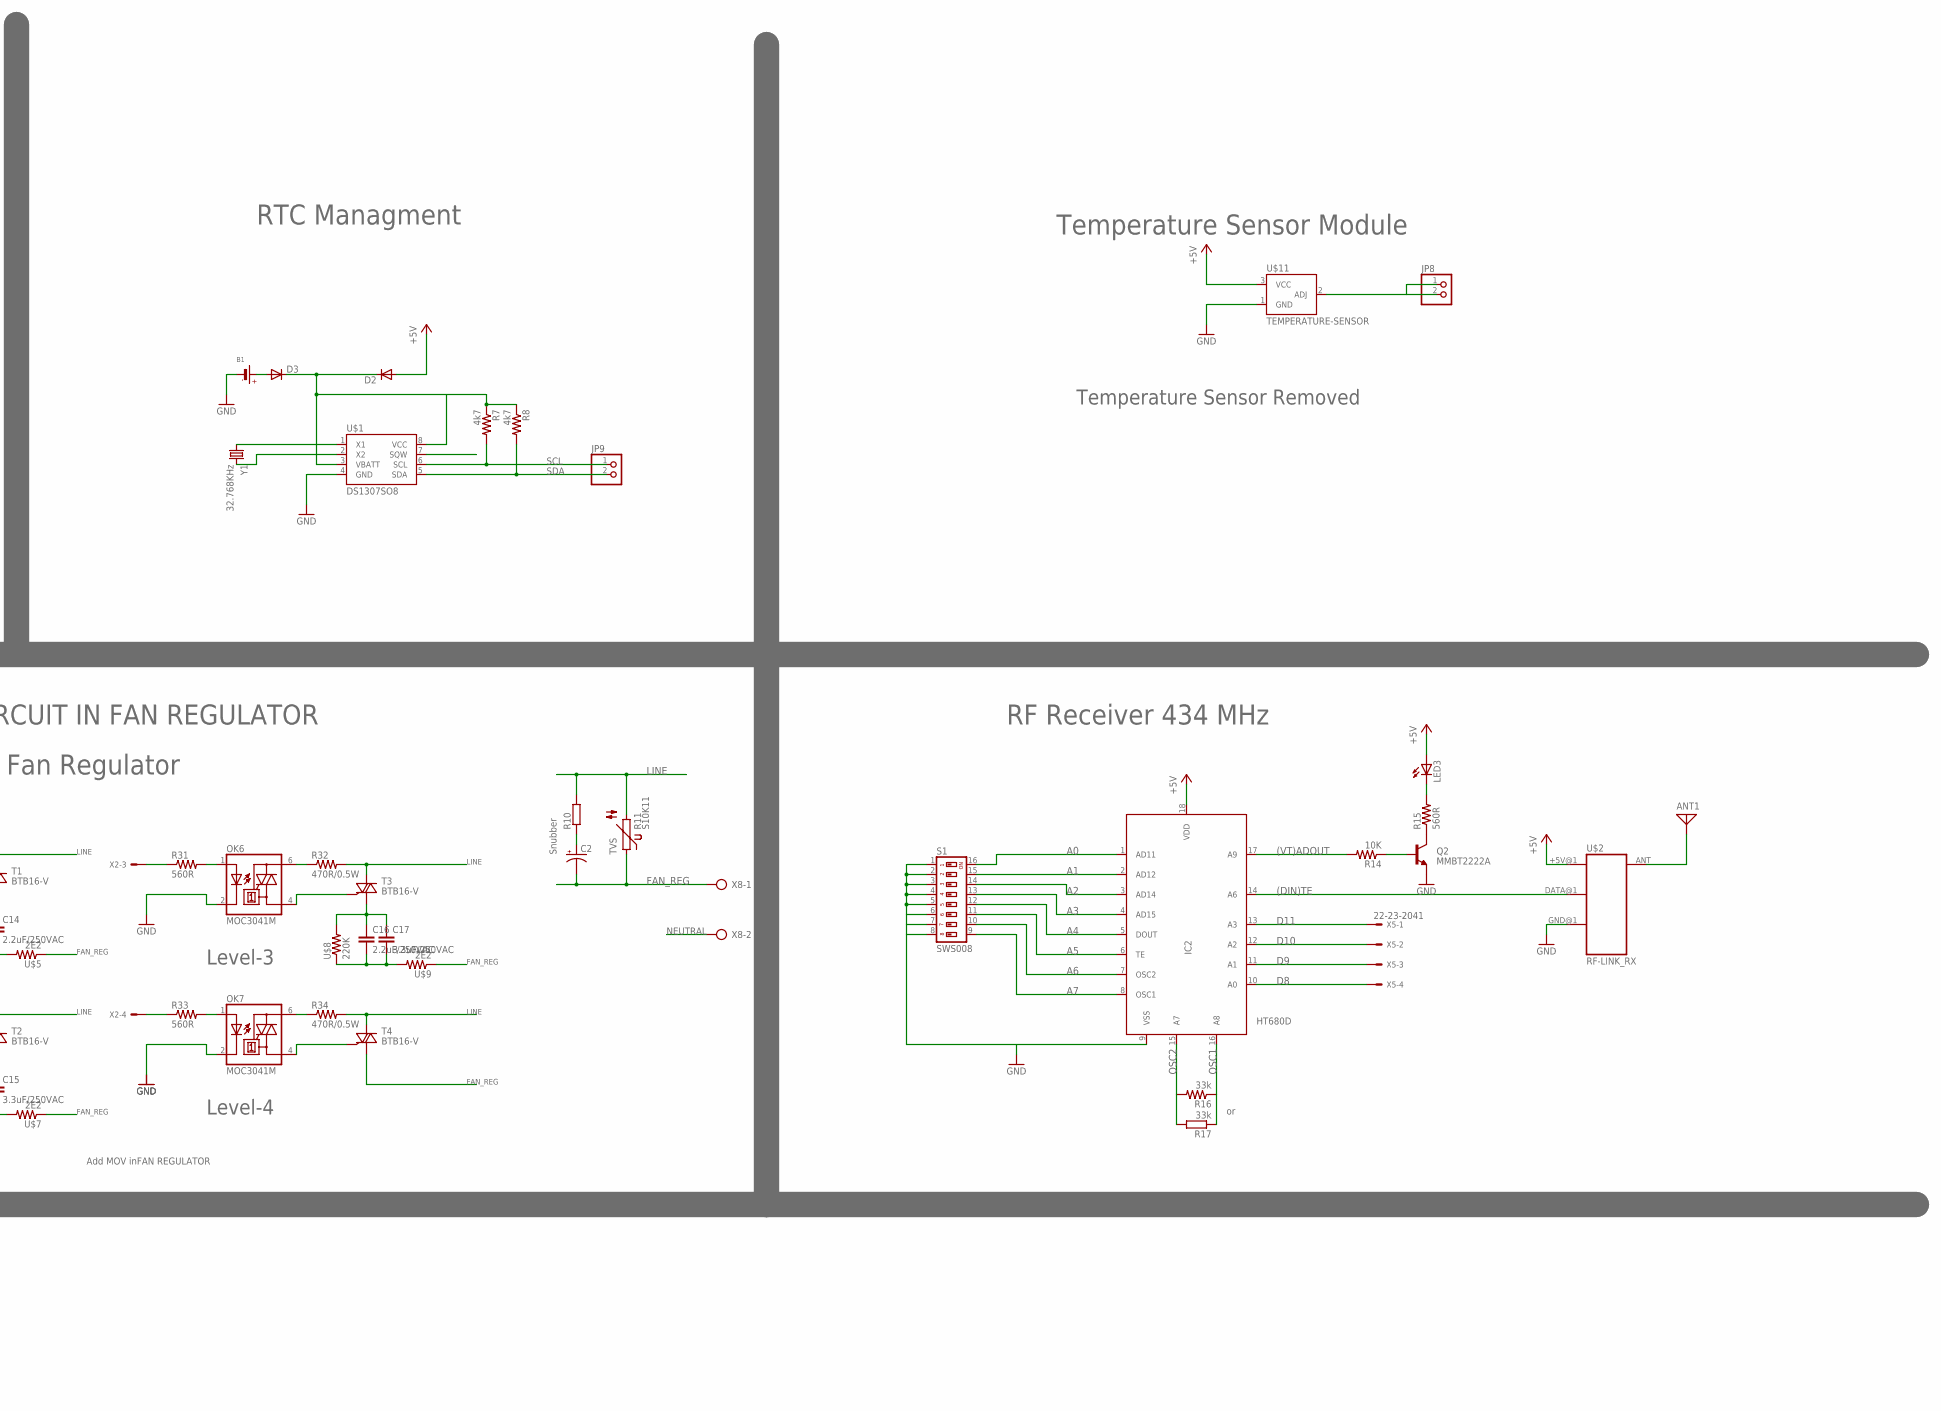
[picture p51: schematic untitled.sch, part in row 1, column 2]

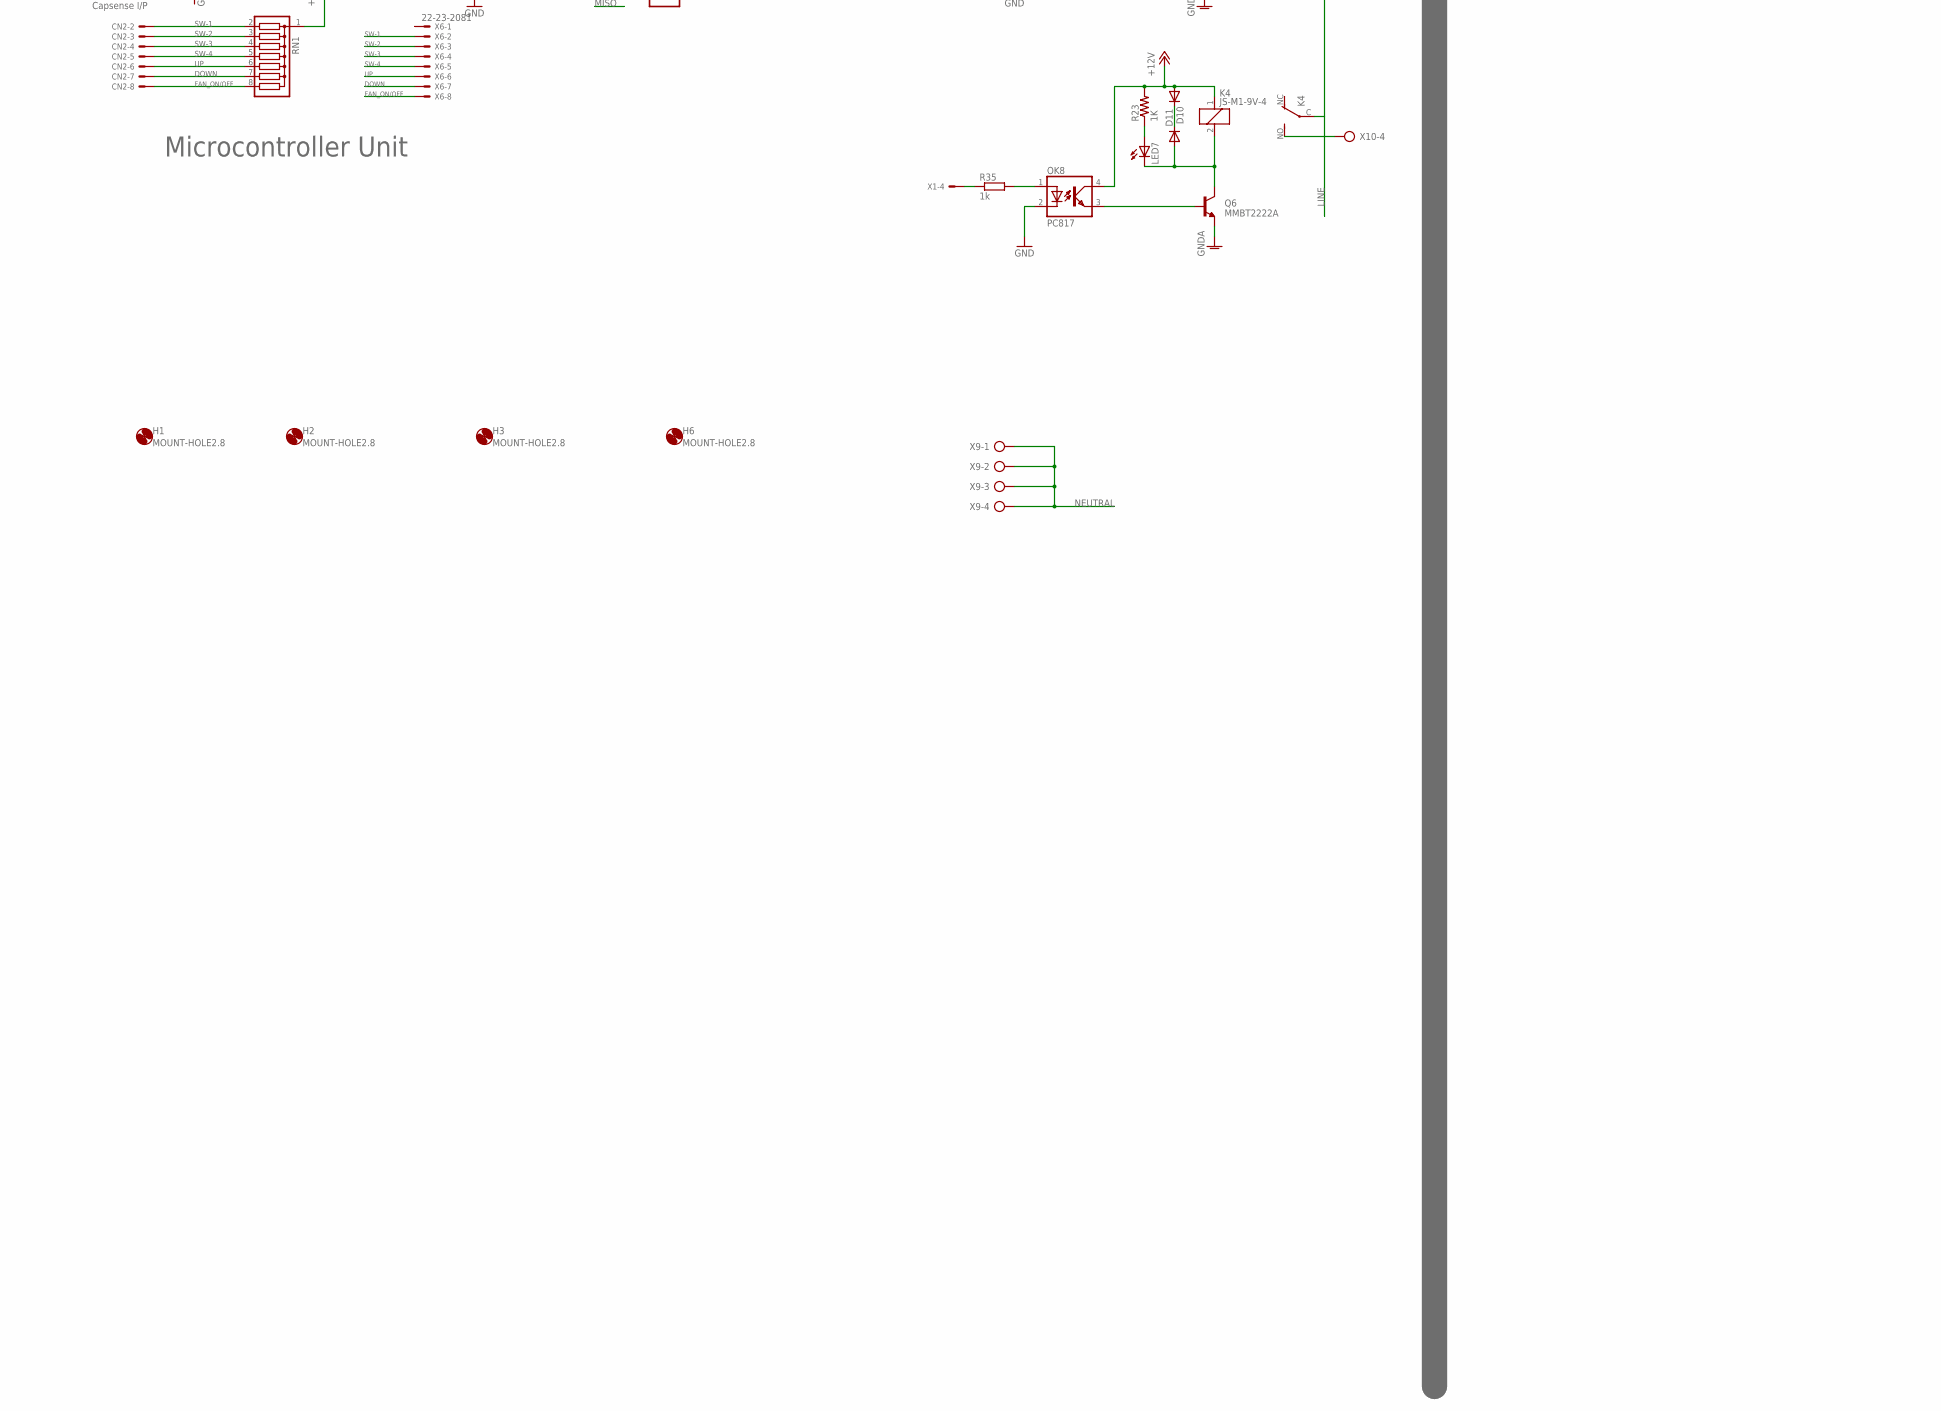
[picture p52: schematic untitled.sch, part in row 2, column 1]

Parts:
ANT1: ANTENNA; PAD-01
ATMEGA32U4: ATMEGA32U4TQFP-44; TQFP44
B1: BATTERYCR2032; CR2032
C1, C10: 470uF/25V; E5-8,5
C2: CPOL-USE5-9VAXIAL; E5R
C3, C6, C11, C18, C19: 0.1uF; 1206
C4, C5: 10uF; EIA3216
C7: 1uF; 1206
C8, C9: 18pF; 1206
C14, C16: 2.2uF/250VAC; C27.5B9
C15, C17: 3.3uF/250VAC; C27.5B9
CN2: Capsense I/P; 22-23-2081
D1, D12: SUPPRESSOR-SMBJ; SMBJ
D2, D3: DIODE-D-5; D-5
D4, D5, D6, D7, D8, D9, D10, D11: DIODE-D-2.5; D-2.5
F1: PFUSE 1A; MF-5,1B
H1, H2, H3, H6: MOUNT-HOLE2.8; 2,8
IC1: V_REG_LM1117SOT223; SOT223
IC2: HT680D; SOP18
JP1, JP3, JP4, JP7: PINHD-1X5; 1X05
JP2: PINHD-1X6; 1X06
JP5: PINHD-1X1; 1X01
JP6: PINHD-1X8; 1X08
JP8, JP9: PINHD-1X2; 1X02
K1, K2, K3, K4: JS-M1-9V-4; JS-M
LED1, LED3, LED4, LED5, LED6, LED7, LED8: LED3MM
LED2: LEDSML1206; SML1206
OK1, OK2, OK3, OK8: PC817; DIL04
OK4: MOC3041M; DIL06; MPN MOC3041M
OK5, OK6, OK7: MOC3041M; DIL06; MPN MOC3031SM
Q1: 16MHz; HC49UP
Q2: MMBT2222A; SOT23-3
Q3, Q4, Q5, Q6: MMBT2222A; TO-92-AMMO
R1: MOV300V; S10K11
R2, R3, R4, R5, R9, R12, R21, R22, R23: 1K; 1206
R6, R14: 10K; 1206
R7, R8: 4k7; 1206
R10: R-EU_0411/3V; 0411V
R11: S10K11
R13, R28, R30, R32, R34: 470R/0.5W; 0411V
R15, R27, R29, R31, R33: 560R; 1206
R16: 33k; 1206
R17: 33k; 0207/2V
R24, R25, R26, R35: 1k; 0207/10
RN1: G07R; SIL8
S1: SWS008; SMS-008
T1, T2, T3, T4: BTB16-V; TO220BV
U$1: DS1307SO8; SO08
U$2: RF-LINK_RX
U$3: HM-11
U$4, U$6, U$8: 220K; 1206
U$5, U$7, U$9: 2E2; 1206
U$11: TEMPERATURE-SENSOR; TO-92
X1, X2, X3: 22-23-2051
X4, X9, X10: AK300/4
X5: 22-23-2041
X6: 22-23-2081
X7: AK300/3
X8: AK300/2
Y1: 32.768KHz; TC26V

Connections:
25: ATMEGA32U4.25 (PD4(ADC8)), JP6.1
26: ATMEGA32U4.26 (PD6(ADC9)), JP6.2
27: ATMEGA32U4.27 (PD7(ADC10)), JP6.3
28: ATMEGA32U4.28 (PB4(ADC11)), JP6.4
29: ATMEGA32U4.29 (PB5(ADC12)), JP6.5
30: ATMEGA32U4.30 (PB6(ADC13)), JP6.6
31: ATMEGA32U4.31 (PC6), JP6.7
32: ATMEGA32U4.32 (PC7), JP6.8
!RESET: ATMEGA32U4.13 (!RESET), JP1.3, JP7.5, R6.1, U$3.UART_RTS, X3.5
(DIN)TE: IC2.14 (A6), U$2.DATA@1 (DATA)
(VT)ADOUT: IC2.17 (A9), R14.2
+3V3: C5.A (+), IC1.2 (OUT), IC1.4 (OUT), JP7.1, U$3.VCC, X3.1
+5V: ATMEGA32U4.2 (UVCC), ATMEGA32U4.7 (VBUS), ATMEGA32U4.14 (VCC), ATMEGA32U4.24 (AVCC), ATMEGA32U4.34 (VCC), ATMEGA32U4.44 (AVCC), C1.+, C3.1, C4.A (+), C18.1, C19.2, D1.C, D2.A, IC1.3 (IN), IC2.18 (VDD), JP1.1, LED3.A, R2.1, R6.2, RN1.1, U$2.+5V@1 (+5V), U$11.3 (VCC), X4.1
+12V: C10.+, C11.1, D4.A, D6.A, D8.A, D10.A, D12.C, K1.1, K2.1, K3.1, K4.1, OK1.4 (COL), OK2.4 (COL), OK3.4 (COL), OK8.4 (COL), R9.2, R12.1, R21.2, R22.2, R23.2, X4.3
A0: IC2.1 (AD11), S1.16
A1: IC2.2 (AD12), S1.15
A2: IC2.3 (AD14), S1.14
A3: IC2.4 (AD15), S1.13
A4: IC2.5 (DOUT), S1.12
A5: IC2.6 (TE), S1.11
A6: IC2.7 (OSC2), S1.10
A7: IC2.8 (OSC1), S1.9
BLE_STATUS: R3.2, U$3.PIO1
D8: IC2.10 (A0), X5.4
D9: IC2.11 (A1), X5.3
D10: IC2.12 (A2), X5.2
D11: IC2.13 (A3), X5.1
DOWN: CN2.7, RN1.7, X6.7
FAN_ON/OFF: CN2.8, RN1.8, X6.8
FAN_REG: C2.-, R11.1, T4.T1 (A1), U$5.1, U$7.1, U$9.1, X8.1
GND: ATMEGA32U4.5 (UGND), ATMEGA32U4.15 (GND), ATMEGA32U4.23 (GND), ATMEGA32U4.33 (PE2/!HWB), ATMEGA32U4.35 (GND), ATMEGA32U4.43 (GND), B1.-, C1.-, C3.2, C4.C (-), C5.C (-), C6.2, C7.1, C8.1, C9.1, C18.2, C19.1, CN2.1, D1.A, IC1.1 (ADJ), IC2.9 (VSS), JP1.2, JP7.2, LED1.K (C), LED2.C, OK1.2 (C), OK2.2 (C), OK3.2 (C), OK4.2 (C), OK5.2 (C), OK6.2 (C), OK7.2 (C), OK8.2 (C), Q2.2 (E), S1.1, S1.2, S1.3, S1.4, S1.5, S1.6, S1.7, S1.8, U$1.4 (GND), U$2.GND@1 (GND), U$3.GND, U$11.1 (GND), X1.5, X2.5, X3.2, X4.2
GNDA: C10.-, C11.2, D12.A, LED8.K (C), Q3.3 (E), Q4.3 (E), Q5.3 (E), Q6.3 (E), X4.4
LINE: F1.1, K1.C, K2.C, K3.C, K4.C, R1.2, R10.2, R11.2, R28.2, R30.2, R32.2, R34.2, T1.T2 (A2), T2.T2 (A2), T3.T2 (A2), T4.T2 (A2)
MISO: ATMEGA32U4.11 (PB3(MISO)), JP3.4
MOSI: ATMEGA32U4.10 (PB2(MOSI)), JP1.4, JP3.3
unnamed: OK6.1 (A), R31.2
unnamed: OK4.1 (A), R27.2
unnamed: OK5.1 (A), R29.2
unnamed: OK4.6 (A2), R28.1
unnamed: OK7.1 (A), R33.2
unnamed: R4.2, U$3.UART_TX
unnamed: ATMEGA32U4.6 (UCAP), C7.2
unnamed: Q2.1 (B), R14.1
unnamed: LED2.A, R3.1
unnamed: ATMEGA32U4.42 (AREF), C6.1
unnamed: R5.2, U$3.UART_RX
unnamed: U$1.1 (X1), Y1.1
unnamed: U$1.2 (X2), Y1.2
unnamed: D2.C, D3.C, R7.1, R8.1, U$1.3 (VBATT), U$1.8 (VCC)
unnamed: LED1.A, R2.2
unnamed: B1.+, D3.A
unnamed: C2.+, R10.1
unnamed: ATMEGA32U4.36 (PF7(ADC7)), JP2.1
unnamed: ATMEGA32U4.37 (PF6(ADC6)), JP2.2
unnamed: ATMEGA32U4.38 (PF5(ADC5)), JP2.3
unnamed: ATMEGA32U4.16 (XTAL2), C8.2, Q1.2
unnamed: ATMEGA32U4.17 (XTAL1), C9.2, Q1.1
unnamed: Q2.3 (C), R15.1
unnamed: R24.1, X1.1
unnamed: LED4.A, R9.1
unnamed: LED3.K (C), R15.2
unnamed: LED5.A, R21.1
unnamed: OK5.6 (A2), R30.1
unnamed: OK6.6 (A2), R32.1
unnamed: ANT1.1, U$2.ANT
unnamed: OK1.3 (EMIT), Q3.2 (B)
unnamed: D5.A, K1.2, LED4.K (C), Q3.1 (C)
unnamed: OK7.6 (A2), R34.1
unnamed: LED6.A, R22.1
unnamed: F1.2, X7.1
unnamed: D4.C, D5.C
unnamed: K4.NO (S), X10.4
unnamed: LED7.A, R23.1
unnamed: OK3.1 (A), R26.2
unnamed: OK1.1 (A), R24.2
unnamed: R25.1, X1.2
unnamed: OK2.3 (EMIT), Q4.2 (B)
unnamed: R26.1, X1.3
unnamed: D7.A, K2.2, LED5.K (C), Q4.1 (C)
unnamed: D6.C, D7.C
unnamed: K3.NO (S), X10.3
unnamed: R35.1, X1.4
unnamed: R27.1, X2.1
unnamed: OK2.1 (A), R25.2
unnamed: OK3.3 (EMIT), Q5.2 (B)
unnamed: R29.1, X2.2
unnamed: D9.A, K3.2, LED6.K (C), Q5.1 (C)
unnamed: OK4.4 (A1), R13.1, T1.G
unnamed: C14.1, R13.2, T1.T1 (A1), U$4.2
unnamed: C14.2, U$4.1, U$5.2
unnamed: D8.C, D9.C
unnamed: K2.NO (S), X10.2
unnamed: R31.1, X2.3
unnamed: R33.1, X2.4
unnamed: K1.NO (S), X10.1
unnamed: OK5.4 (A1), T2.G
unnamed: C15.1, T2.T1 (A1), U$6.2
unnamed: C15.2, U$6.1, U$7.2
unnamed: LED8.A, R12.2
unnamed: OK8.3 (EMIT), Q6.2 (B)
unnamed: D11.A, K4.2, LED7.K (C), Q6.1 (C)
unnamed: D10.C, D11.C
unnamed: OK6.4 (A1), T3.G
unnamed: C16.1, C17.1, T3.T1 (A1), U$8.2
unnamed: C16.2, C17.2, U$8.1, U$9.2
unnamed: ATMEGA32U4.8 (PB0(SS)), JP3.1
unnamed: ATMEGA32U4.39 (PF4(ADC4)), JP2.4
unnamed: OK8.1 (A), R35.2
unnamed: OK7.4 (A1), T4.G
unnamed: ATMEGA32U4.40 (PF1(ADC1)), JP2.5
unnamed: ATMEGA32U4.41 (PF0(ADC0)), JP2.6
unnamed: ATMEGA32U4.12 (PB7), JP3.5
unnamed: ATMEGA32U4.22 (PD5), JP4.5
unnamed: ATMEGA32U4.1 (PE6), JP5.1
unnamed: JP8.1, JP8.2, U$11.2 (ADJ)
NEUTRAL: R1.1, X7.2, X7.3, X8.2, X9.1, X9.2, X9.3, X9.4
OSC1: IC2.16 (A8), R16.1, R17.1
OSC2: IC2.15 (A7), R16.2, R17.2
RX: ATMEGA32U4.21 (PD3(TX)), JP4.4, JP7.3, R5.1, X3.3
SCK: ATMEGA32U4.9 (PB1(SCK)), JP1.5, JP3.2
SCL: ATMEGA32U4.18 (PD0(SCL)), JP4.1, JP9.1, R7.2, U$1.6 (SCL)
SDA: ATMEGA32U4.19 (PD1(SDA)), JP4.2, JP9.2, R8.2, U$1.5 (SDA)
SW-1: CN2.2, RN1.2, X6.2
SW-2: CN2.3, RN1.3, X6.3
SW-3: CN2.4, RN1.4, X6.4
SW-4: CN2.5, RN1.5, X6.5
TX: ATMEGA32U4.20 (PD2(RX)), JP4.3, JP7.4, R4.1, X3.4
UP: CN2.6, RN1.6, X6.6

Notes on the sheet:
Microcontroller Unit
Level-1
Level-2
Level-3
Level-4
Fan Regulator
Bluetooth Section
Add MOV inFAN REGULATOR
RTC Managment
Temperature Sensor Module
RF Receiver 434 MHz
Temperature Sensor Removed
ADD RC SNUBBER CIRCUIT IN FAN REGULATOR
Snubber
TVS

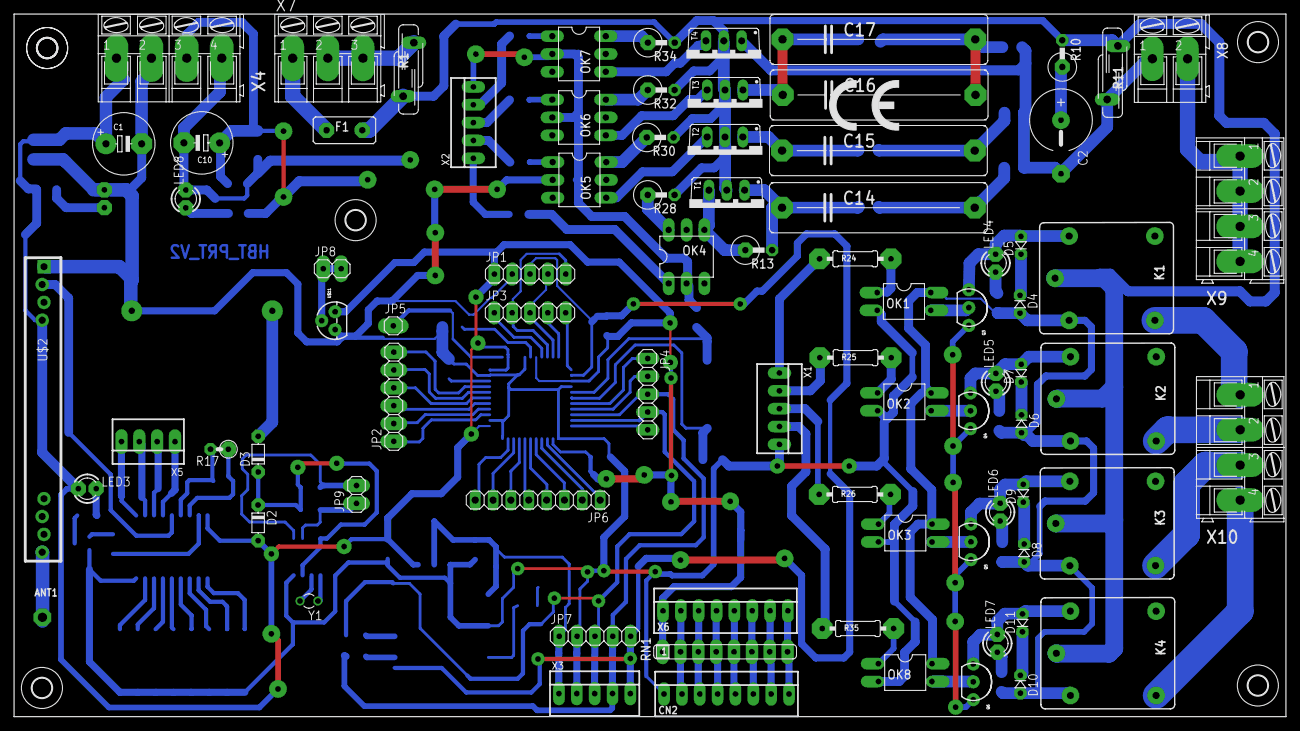
[picture p53: board untitled.brd from above]

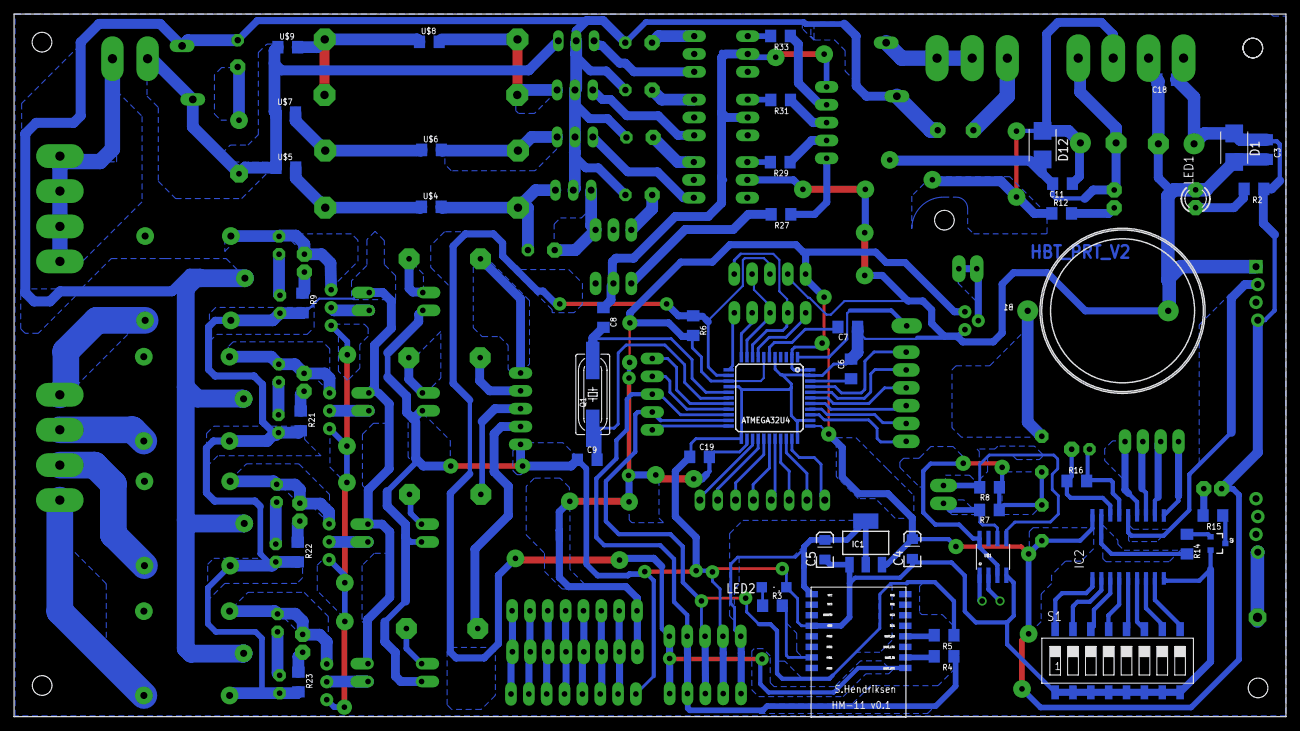
[picture p54: board untitled.brd from below]

Board: 2 copper layers, 181.0 x 100.0 mm, 137 parts (47 on the bottom side), 128 nets.

Other parts of the board:
H4, H5: MOUNT-HOLE2.8; 2,8
U$17: CE_10.00
