nmaiti/smartswitchboard/Hardware/Fan_Regulator/FanRegulator.brd

## EAGLE design Hardware/Fan_Regulator/FanRegulator.brd (2015-07-25)

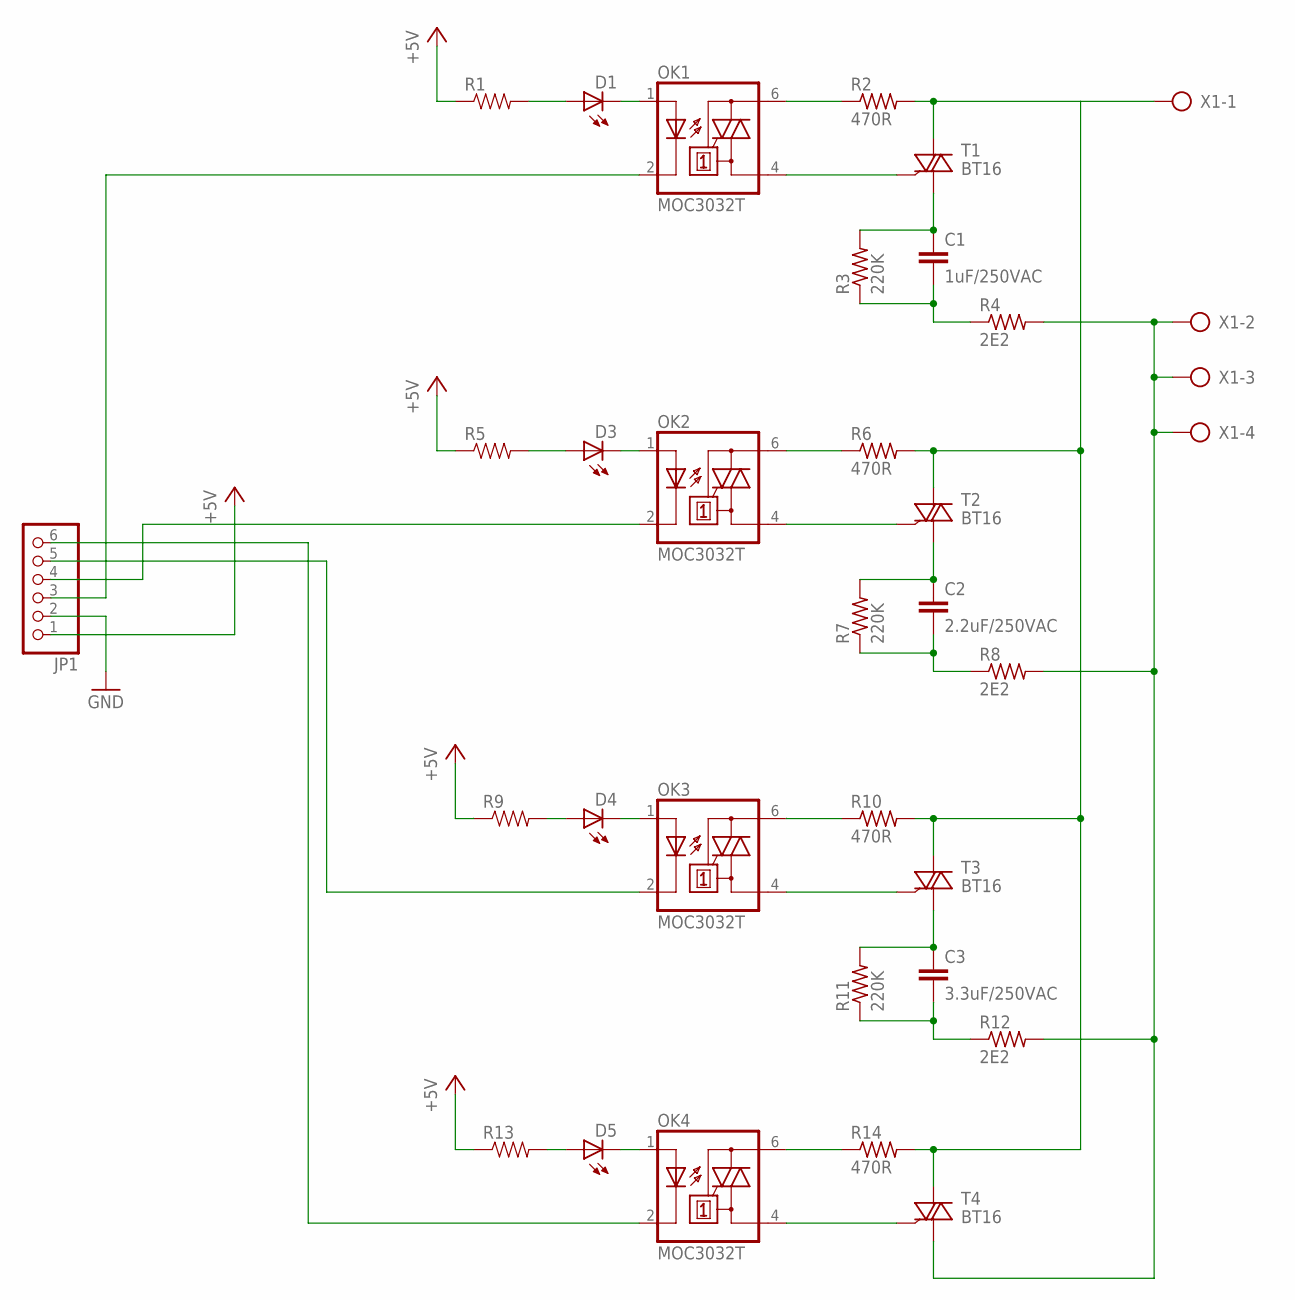
[picture p55: schematic FanRegulator.sch]

Parts:
C1: 1uF/250VAC; C27.5B9
C2: 2.2uF/250VAC; C27.5B9
C3: 3.3uF/250VAC; C27.5B9
D1, D3, D4, D5: LED3MM
JP1: PINHD-1X6; 1X06
OK1, OK2, OK3, OK4: MOC3032T; DIL06B
R1, R5, R9, R13: RESISTOR1206; 1206
R2, R6, R10, R14: 470R; R0207/1V
R3, R7, R11: 220K; R0207/1V
R4, R8, R12: 2E2; R0207/1V
T1, T2, T3, T4: BT16; TO220BV
X1: AK300/4

Connections:
+5V: JP1.1, R1.1, R5.1, R9.1, R13.1
GND: JP1.2
unnamed: OK1.6 (A2), R2.1
unnamed: OK1.4 (A1), T1.G
unnamed: D1.A, R1.2
unnamed: C1.1, R3.2, T1.T1 (A1)
unnamed: C1.2, R3.1, R4.1
unnamed: D1.K (C), OK1.1 (A)
unnamed: D3.A, R5.2
unnamed: JP1.3, OK1.2 (C)
unnamed: OK2.6 (A2), R6.1
unnamed: OK2.4 (A1), T2.G
unnamed: R2.2, R6.2, R10.2, R14.2, T1.T2 (A2), T2.T2 (A2), T3.T2 (A2), T4.T2 (A2), X1.1
unnamed: C2.1, R7.2, T2.T1 (A1)
unnamed: C2.2, R7.1, R8.1
unnamed: D3.K (C), OK2.1 (A)
unnamed: D4.A, R9.2
unnamed: JP1.4, OK2.2 (C)
unnamed: OK3.6 (A2), R10.1
unnamed: OK3.4 (A1), T3.G
unnamed: D4.K (C), OK3.1 (A)
unnamed: C3.1, R11.2, T3.T1 (A1)
unnamed: C3.2, R11.1, R12.1
unnamed: D5.A, R13.2
unnamed: D5.K (C), OK4.1 (A)
unnamed: JP1.5, OK3.2 (C)
unnamed: OK4.6 (A2), R14.1
unnamed: OK4.4 (A1), T4.G
unnamed: JP1.6, OK4.2 (C)
unnamed: R4.2, R8.2, R12.2, T4.T1 (A1), X1.2, X1.3, X1.4

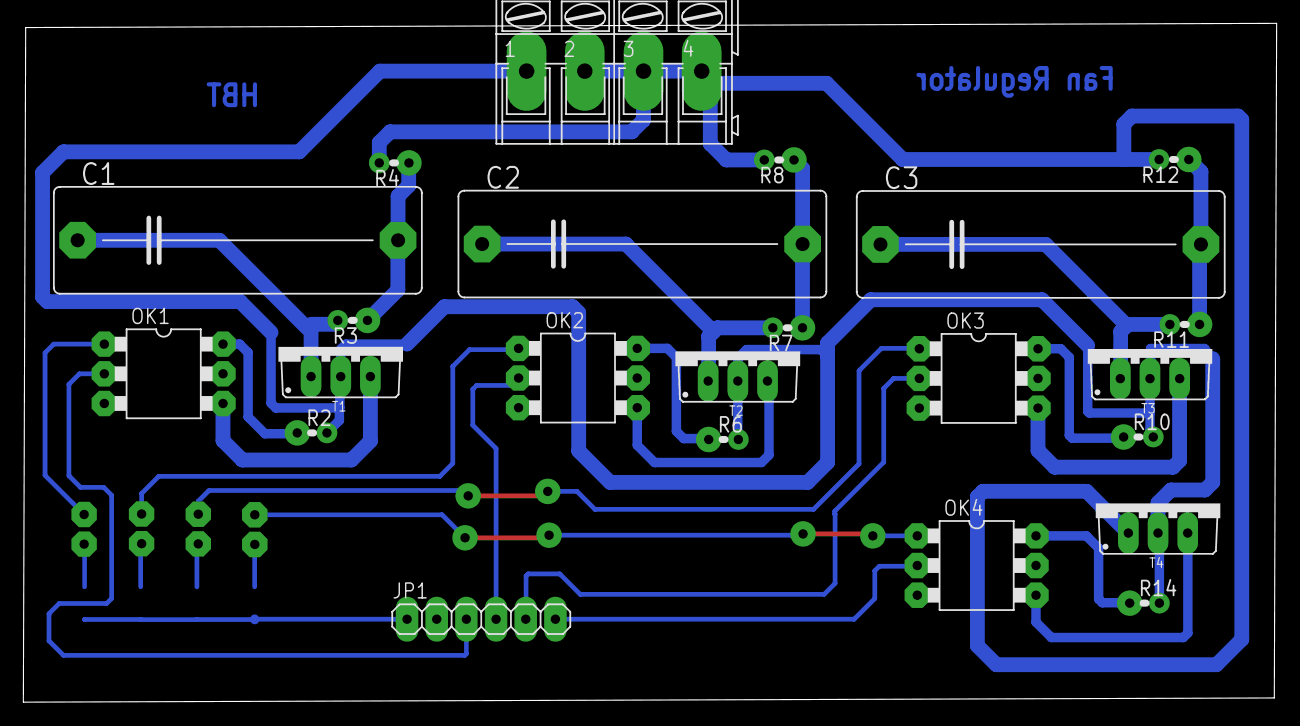
[picture p56: board FanRegulator.brd from above]

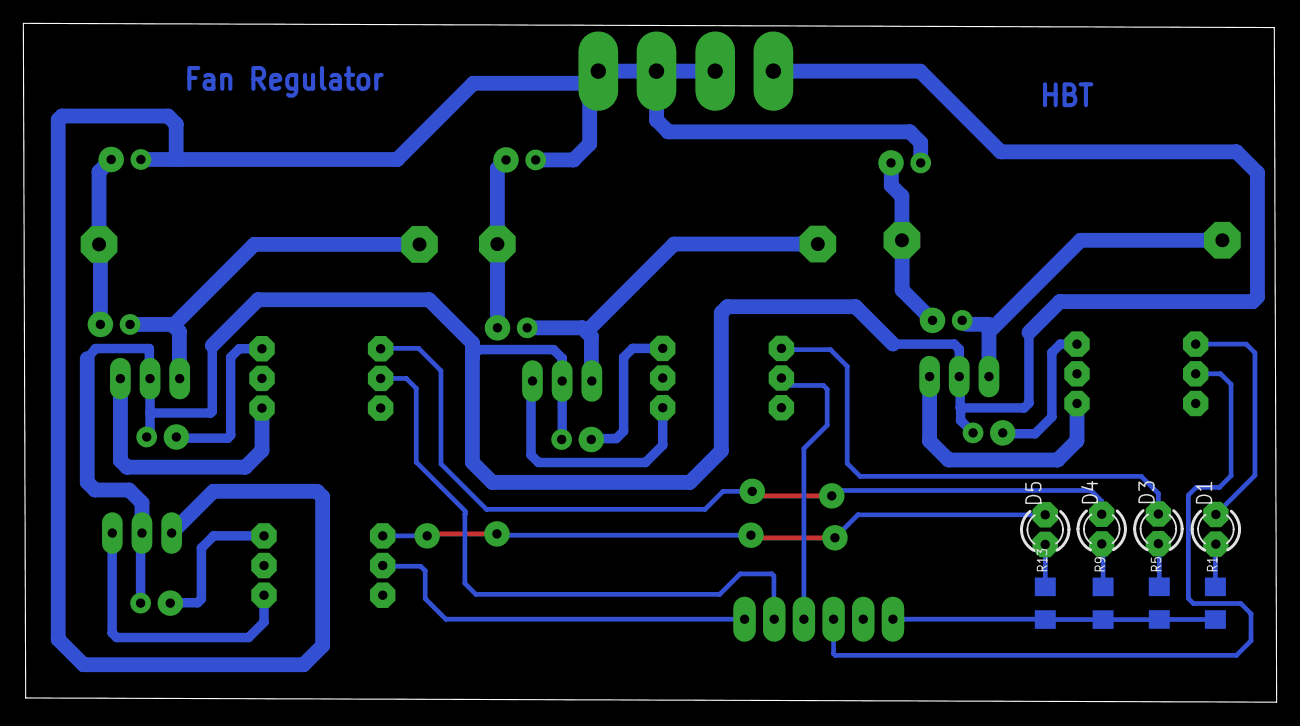
[picture p57: board FanRegulator.brd from below]

Board: 2 copper layers, 107.3 x 58.1 mm, 31 parts (8 on the bottom side), 29 nets.
