nmaiti/smartswitchboard/Hardware/Power_Supply_Board/ACtoDCconvtr.brd

## EAGLE design Hardware/Power_Supply_Board/ACtoDCconvtr.brd (2015-07-25)

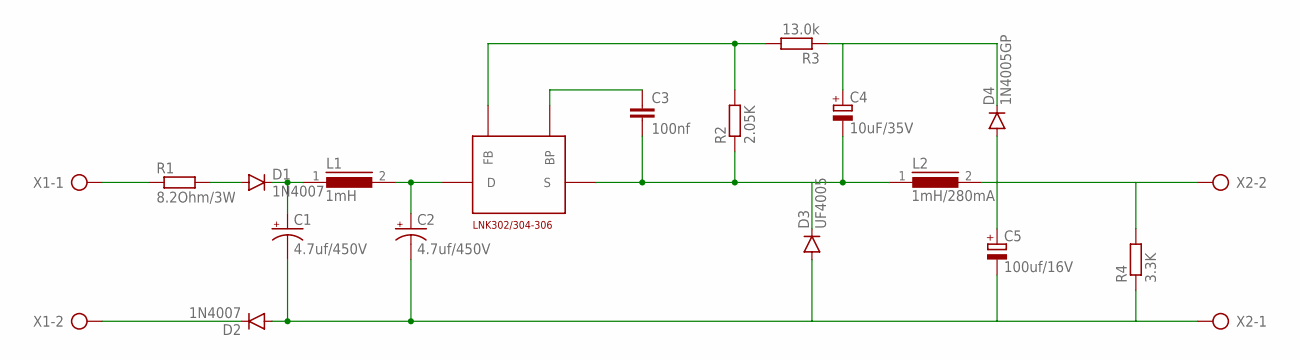
[picture p58: schematic ACtoDCconvtr.sch]

Parts:
C1, C2: 4.7uf/450V; CPOL-RADIAL-1000UF-25V-KIT
C3: 100nf; C2.5-4
C4: 10uF/35V; E2,5-5
C5: 100uf/16V; E2,5-7
D1, D2: 1N4007; DIODE-1N4148-KIT
D3: UF4005; DIODE-1N4148-KIT
D4: 1N4005GP; DIODE-1N4148-KIT
L1: 1mH; 82114R
L2: 1mH/280mA; 82114R
R1: 8.2Ohm/3W; 0411/15
R2: 2.05K; 0207/2V
R3: 13.0k; 0207/2V
R4: 3.3K; 0207/10
U$1: LNK302/304-306; SMD-8B
X1, X2: AK300/2

Connections:
unnamed: R1.1, X1.1
unnamed: D1.A, R1.2
unnamed: C1.+, D1.C, L1.1
unnamed: C2.+, L1.2, U$1.D
unnamed: D2.C, X1.2
unnamed: C1.-, C2.-, C5.-, D2.A, D3.A, R4.1, X2.1
unnamed: C3.2, C4.-, D3.C, L2.1, R2.1, U$1.S1 (S)
unnamed: C3.1, U$1.BP
unnamed: R2.2, R3.2, U$1.FB
unnamed: C4.+, D4.C, R3.1
unnamed: C5.+, D4.A, L2.2, R4.2, X2.2

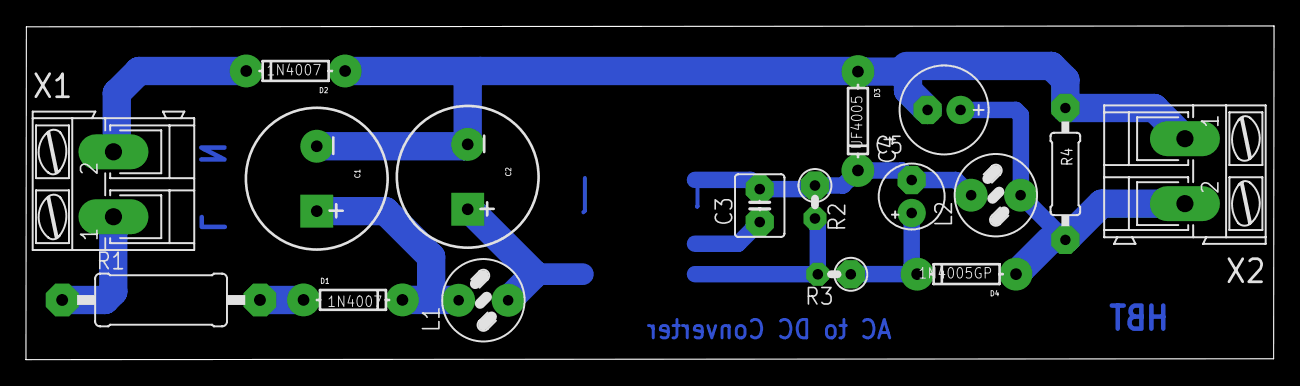
[picture p59: board ACtoDCconvtr.brd from above]

Board: 2 copper layers, 96.2 x 25.7 mm, 18 parts (1 on the bottom side), 11 nets.
