nmaiti/smartswitchboard/Hardware/CapsenseBoard/capsenseboard.brd

## EAGLE design Hardware/CapsenseBoard/capsenseboard.brd (2015-07-10)

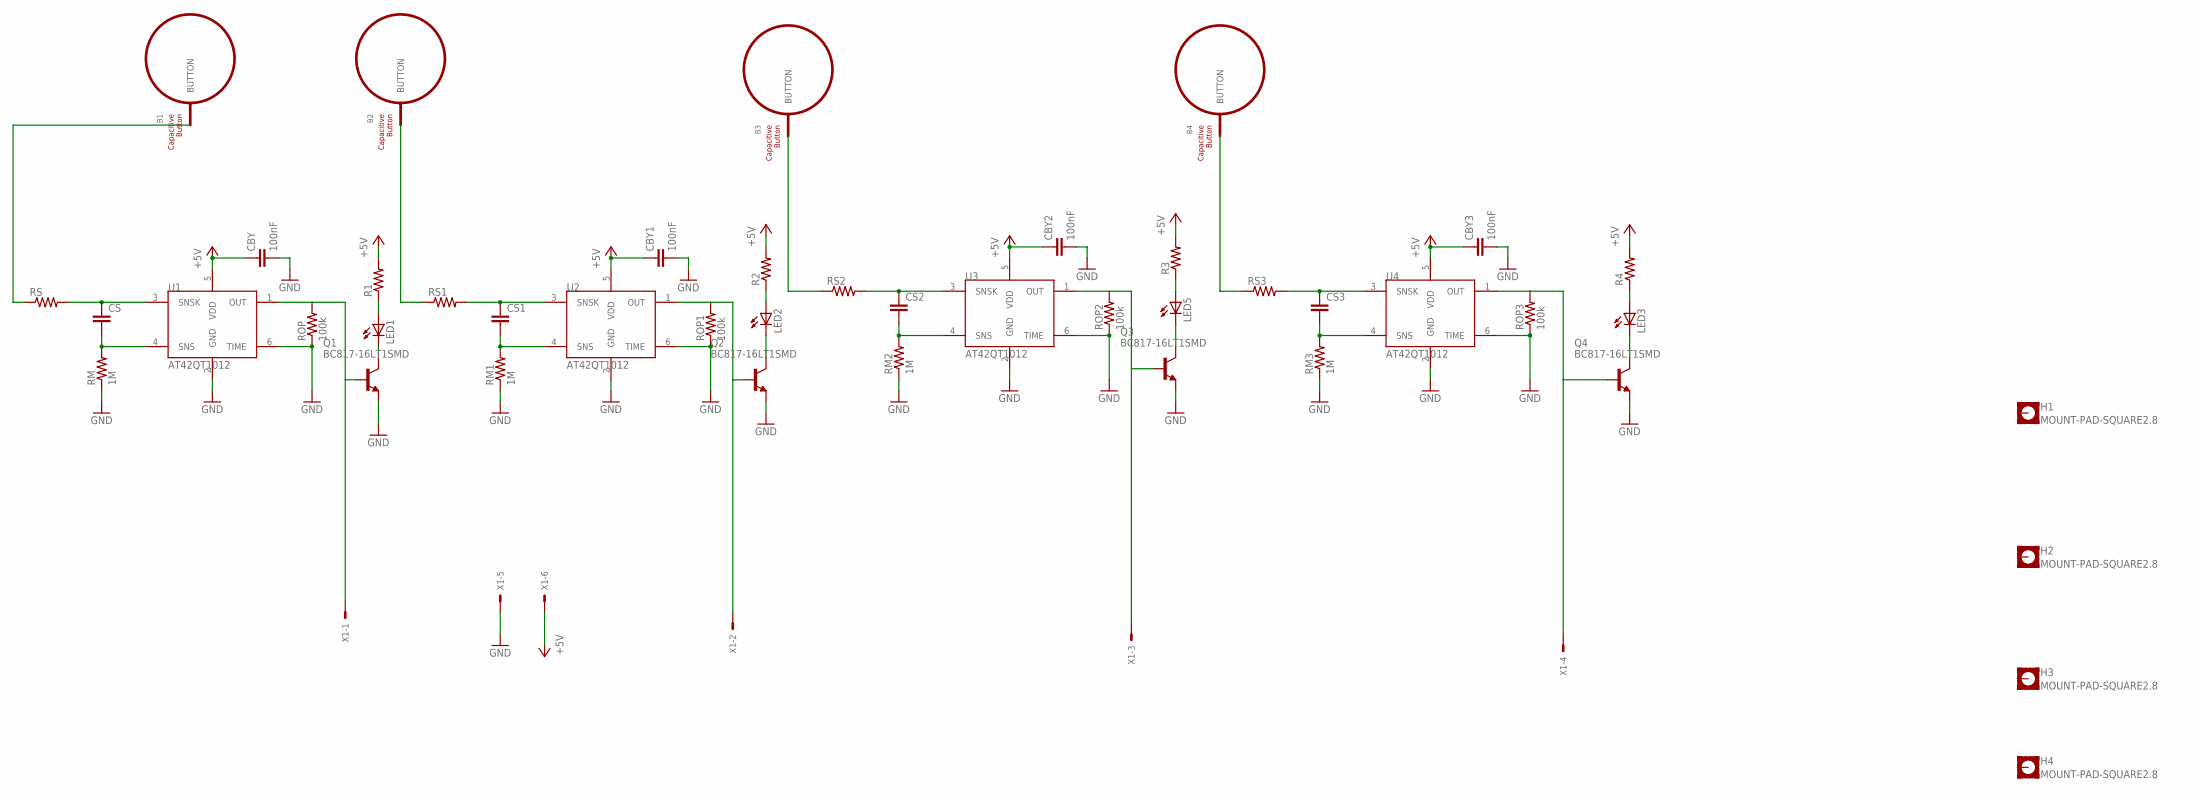
[picture p60: schematic capsenseboard.sch]

Parts:
B1, B2, B3, B4: BUTTON_PASSIVE12MM; BUTTON_PASSIVE_12MM
CBY, CBY1, CBY2, CBY3: 100nF; C1206K
CS, CS1, CS2, CS3: C-EUC1206K; C1206K
H1, H2, H3, H4: MOUNT-PAD-SQUARE2.8; 2,8-PAD-SQUARE
LED1, LED2, LED3, LED5: LEDCHIPLED_1206; CHIPLED_1206
Q1, Q2, Q3, Q4: BC817-16LT1SMD; SOT23-BEC
R1, R2, R3, R4: R-US_R1206; R1206
RM, RM1, RM2, RM3: 1M; R1206
ROP, ROP1, ROP2, ROP3: 100k; R1206
RS, RS1, RS2, RS3: R-US_R1206; R1206
U1, U2, U3, U4: AT42QT1012; SOT-23-6
X1: 22-23-2061

Connections:
+5V: CBY.1, CBY1.1, CBY2.1, CBY3.1, R1.2, R2.2, R3.2, R4.2, U1.5 (VDD), U2.5 (VDD), U3.5 (VDD), U4.5 (VDD), X1.6
GND: CBY.2, CBY1.2, CBY2.2, CBY3.2, Q1.E, Q2.E, Q3.E, Q4.E, RM.1, RM1.1, RM2.1, RM3.1, ROP.1, ROP1.1, ROP2.1, ROP3.1, U1.2 (GND), U1.6 (TIME), U2.2 (GND), U2.6 (TIME), U3.2 (GND), U3.6 (TIME), U4.2 (GND), U4.6 (TIME), X1.5
unnamed: CS.1, RS.2, U1.3 (SNSK)
unnamed: CS.2, RM.2, U1.4 (SNS)
unnamed: Q1.B, ROP.2, U1.1 (OUT), X1.1
unnamed: B1.BUTTON, RS.1
unnamed: CS1.1, RS1.2, U2.3 (SNSK)
unnamed: CS1.2, RM1.2, U2.4 (SNS)
unnamed: Q2.B, ROP1.2, U2.1 (OUT), X1.2
unnamed: B2.BUTTON, RS1.1
unnamed: CS2.1, RS2.2, U3.3 (SNSK)
unnamed: CS2.2, RM2.2, U3.4 (SNS)
unnamed: Q4.B, ROP3.2, U4.1 (OUT), X1.4
unnamed: B3.BUTTON, RS2.1
unnamed: CS3.1, RS3.2, U4.3 (SNSK)
unnamed: CS3.2, RM3.2, U4.4 (SNS)
unnamed: B4.BUTTON, RS3.1
unnamed: LED1.A, R1.1
unnamed: LED1.C, Q1.C
unnamed: Q3.B, ROP2.2, U3.1 (OUT), X1.3
unnamed: LED5.A, R3.1
unnamed: LED2.A, R2.1
unnamed: LED2.C, Q2.C
unnamed: LED5.C, Q3.C
unnamed: LED3.A, R4.1
unnamed: LED3.C, Q4.C

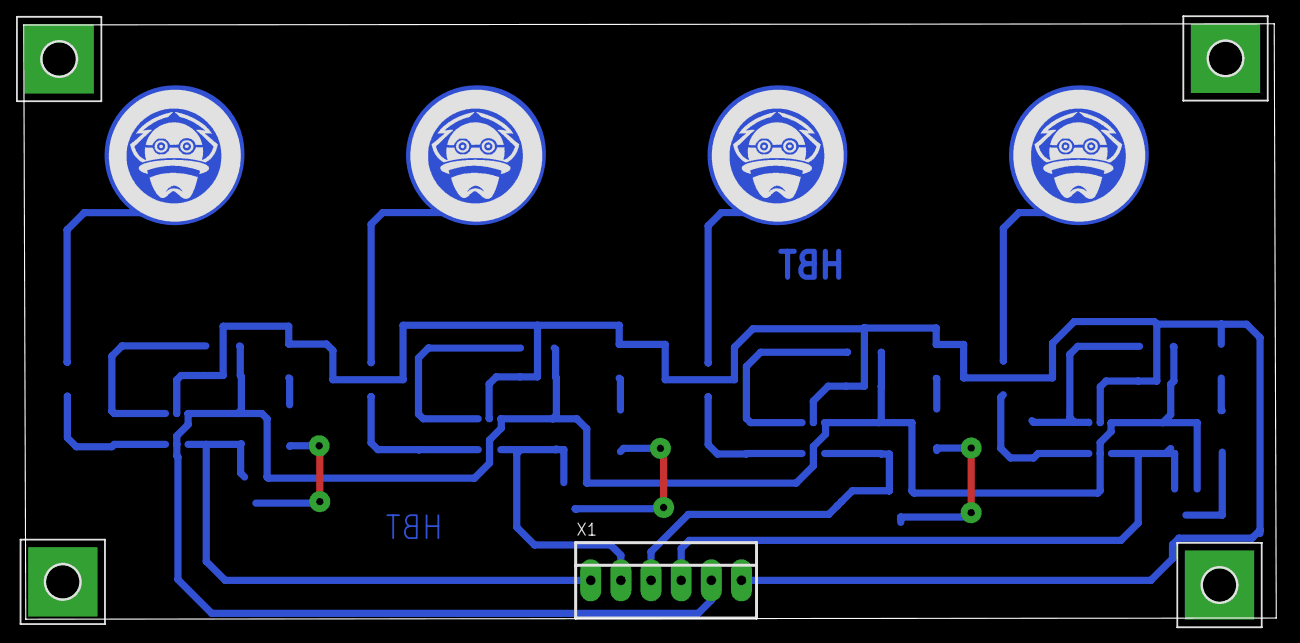
[picture p61: board capsenseboard.brd from above]

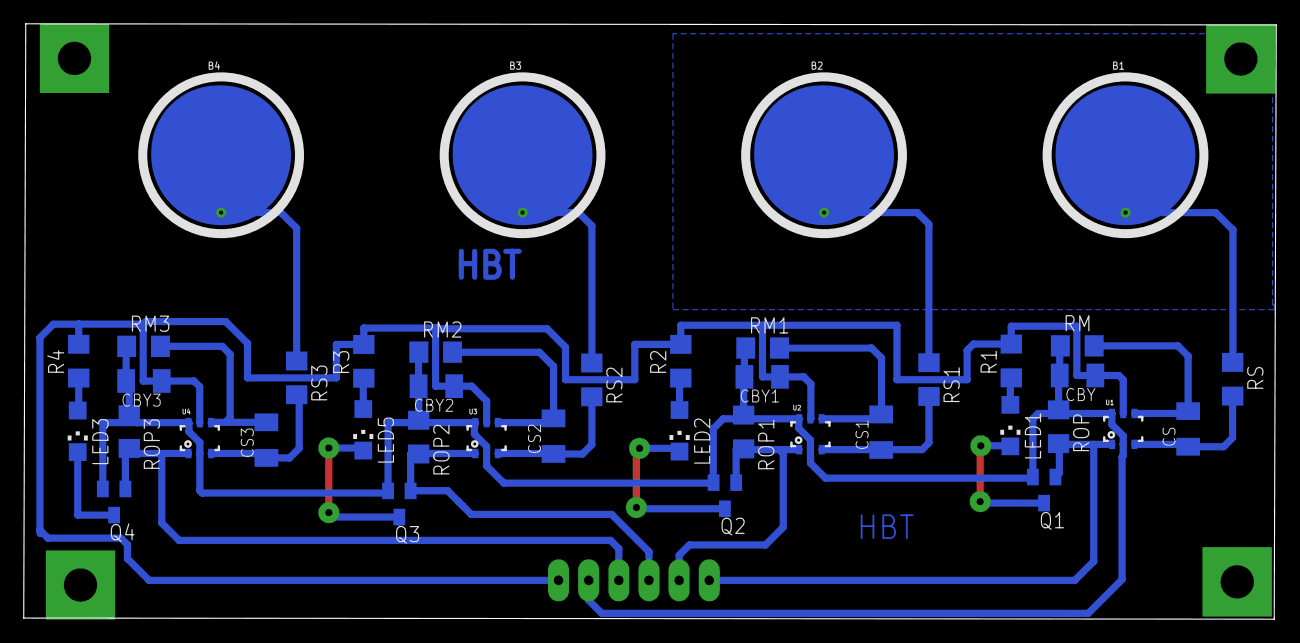
[picture p62: board capsenseboard.brd from below]

Board: 2 copper layers, 105.5 x 50.2 mm, 45 parts (40 on the bottom side), 26 nets.
