nmaiti/smartswitchboard/Hardware/Pi_MCU_Shield/PiMCU_Shield.brd

## EAGLE design Hardware/Pi_MCU_Shield/PiMCU_Shield.brd (2016-08-02)

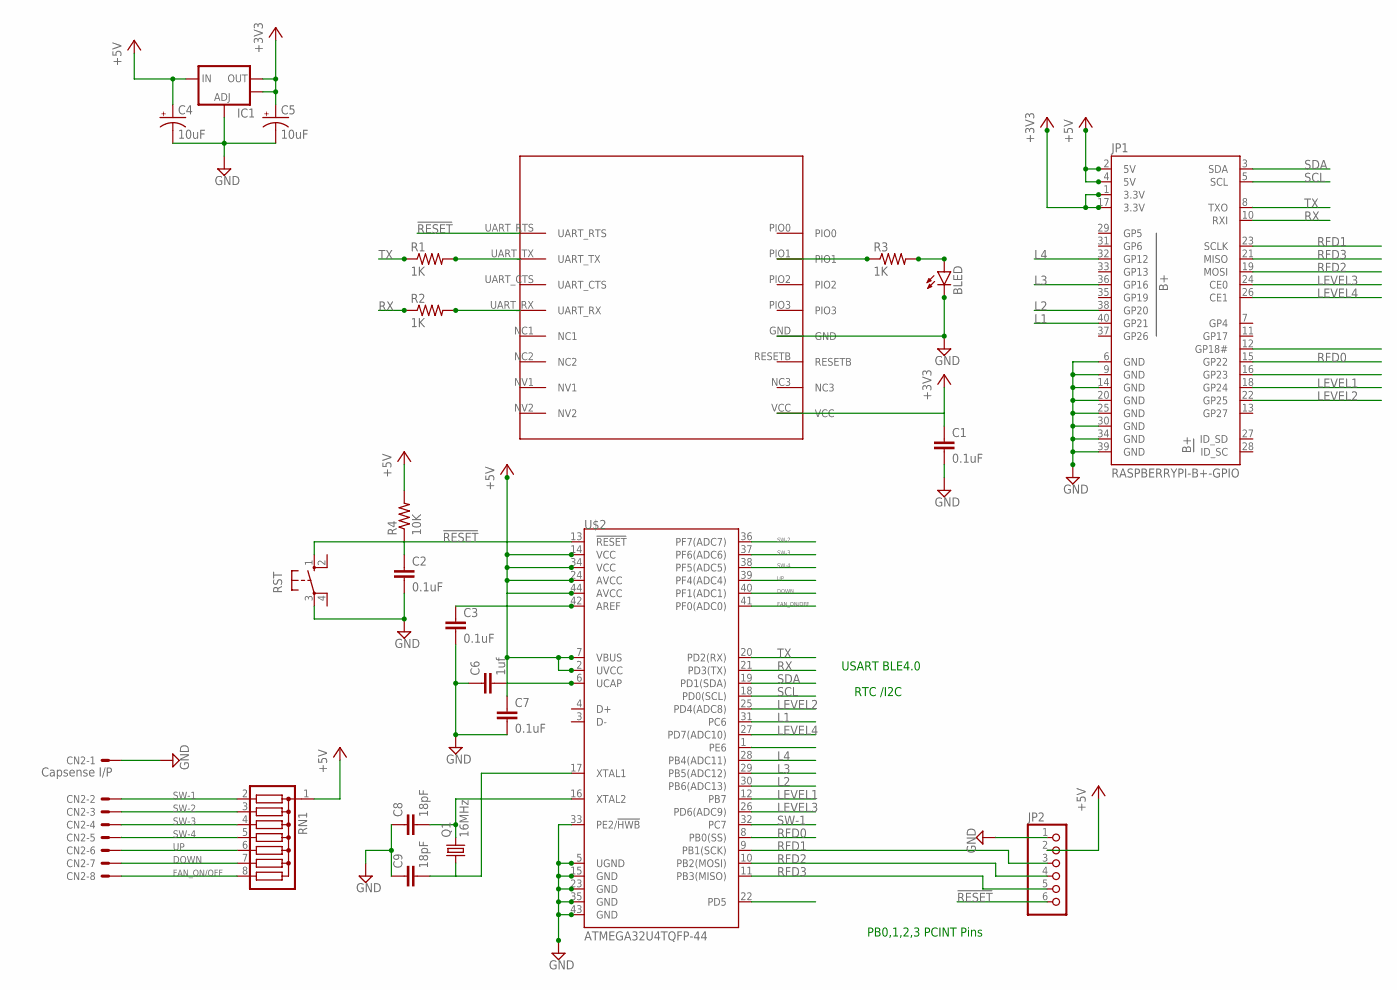
[picture p63: schematic PiMCU_Shield.sch]

Parts:
BLED: LED1206; LED-1206
C1, C2, C3, C7: 0.1uF; 1206
C4, C5: 10uF; EIA3216
C6: 1uf; 1206
C8, C9: 18pF; 1206
CN2: Capsense I/P; 22-23-2081
IC1: V_REG_LM1117SOT223; SOT223
JP1: RASPBERRYPI-B+-GPIO; 2X20-SHROUDED
JP2: PINHD-1X6; 1X06
Q1: 16MHz; HC49UP
R1, R2, R3: 1K; 1206
R4: 10K; 1206
RN1: G07R; SIL8
RST: 10-XX; B3F-10XX
U$1: HM-11
U$2: ATMEGA32U4TQFP-44; TQFP44

Connections:
!RESET: C2.1, JP2.6, R4.1, RST.1 (S), U$1.UART_RTS, U$2.13 (!RESET)
+3V3: C1.1, C5.A (+), IC1.2 (OUT), IC1.4 (OUT), JP1.1 (3.3V), JP1.17 (3.3V), U$1.VCC
+5V: C4.A (+), C7.1, IC1.3 (IN), JP1.2 (5V), JP1.4 (5V), JP2.2, R4.2, RN1.1, U$2.2 (UVCC), U$2.7 (VBUS), U$2.14 (VCC), U$2.24 (AVCC), U$2.34 (VCC), U$2.44 (AVCC)
DOWN: CN2.7, RN1.7, U$2.40 (PF1(ADC1))
FAN_ON/OFF: CN2.8, RN1.8, U$2.41 (PF0(ADC0))
GND: BLED.C, C1.2, C2.2, C3.2, C4.C (-), C5.C (-), C6.1, C7.2, C8.1, C9.1, CN2.1, IC1.1 (ADJ), JP1.6 (GND), JP1.9 (GND), JP1.14 (GND), JP1.20 (GND), JP1.25 (GND), JP1.30 (GND), JP1.34 (GND), JP1.39 (GND), JP2.1, RST.3, U$1.GND, U$2.5 (UGND), U$2.15 (GND), U$2.23 (GND), U$2.33 (PE2/!HWB), U$2.35 (GND), U$2.43 (GND)
L1: JP1.40 (GP21), U$2.31 (PC6)
L2: JP1.38 (GP20), U$2.30 (PB6(ADC13))
L3: JP1.36 (GP16), U$2.29 (PB5(ADC12))
L4: JP1.32 (GP12), U$2.28 (PB4(ADC11))
LEVEL1: JP1.18 (GP24), U$2.12 (PB7)
LEVEL2: JP1.22 (GP25), U$2.25 (PD4(ADC8))
LEVEL3: JP1.24 (CE0), U$2.26 (PD6(ADC9))
LEVEL4: JP1.26 (CE1), U$2.27 (PD7(ADC10))
unnamed: R1.2, U$1.UART_TX
unnamed: R2.2, U$1.UART_RX
unnamed: R3.1, U$1.PIO1
unnamed: BLED.A, R3.2
unnamed: C3.1, U$2.42 (AREF)
unnamed: C6.2, U$2.6 (UCAP)
unnamed: C8.2, Q1.2, U$2.16 (XTAL2)
unnamed: C9.2, Q1.1, U$2.17 (XTAL1)
RFD0: JP1.15 (GP22), U$2.8 (PB0(SS))
RFD1: JP1.23 (SCLK), JP2.3, U$2.9 (PB1(SCK))
RFD2: JP1.19 (MOSI), JP2.4, U$2.10 (PB2(MOSI))
RFD3: JP1.21 (MISO), JP2.5, U$2.11 (PB3(MISO))
RX: JP1.10 (RXI), R2.1, U$2.21 (PD3(TX))
SCL: JP1.5 (SCL), U$2.18 (PD0(SCL))
SDA: JP1.3 (SDA), U$2.19 (PD1(SDA))
SW-1: CN2.2, RN1.2, U$2.32 (PC7)
SW-2: CN2.3, RN1.3, U$2.36 (PF7(ADC7))
SW-3: CN2.4, RN1.4, U$2.37 (PF6(ADC6))
SW-4: CN2.5, RN1.5, U$2.38 (PF5(ADC5))
TX: JP1.8 (TXO), R1.1, U$2.20 (PD2(RX))
UP: CN2.6, RN1.6, U$2.39 (PF4(ADC4))

Notes on the sheet:
PB0,1,2,3 PCINT Pins
USART BLE4.0
RTC /I2C

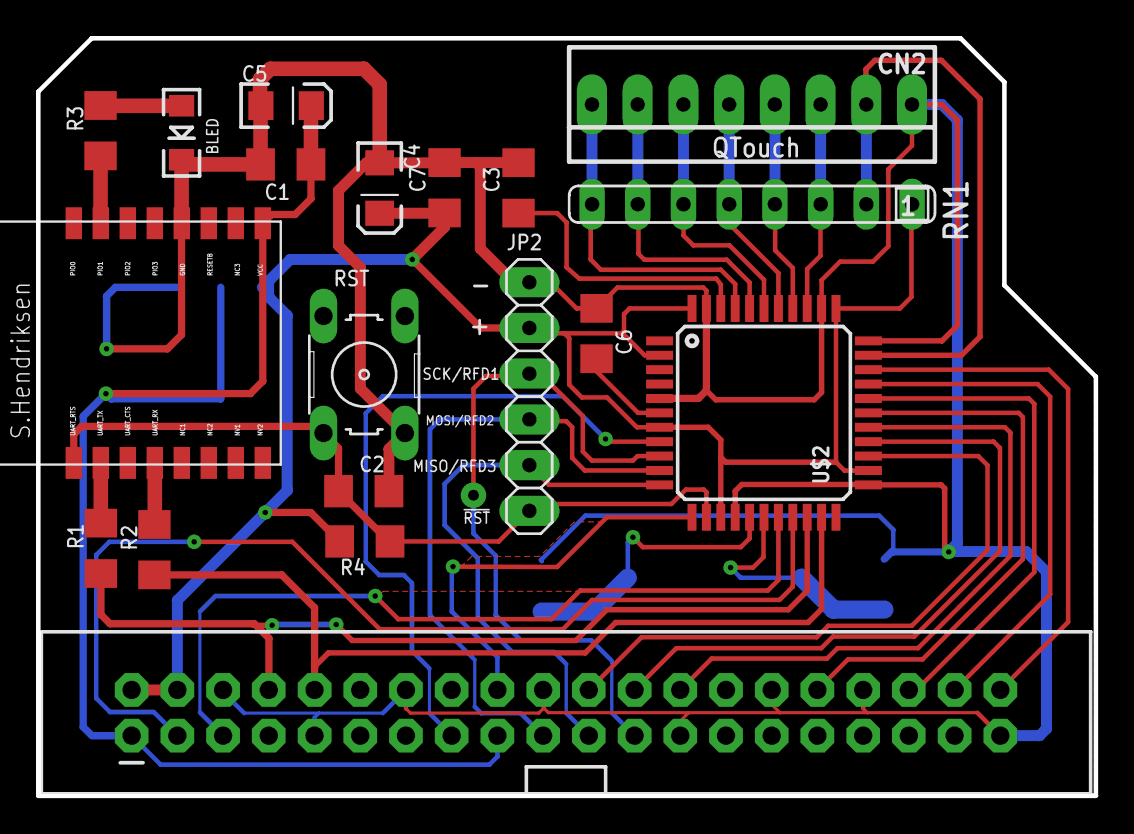
[picture p64: board PiMCU_Shield.brd from above]

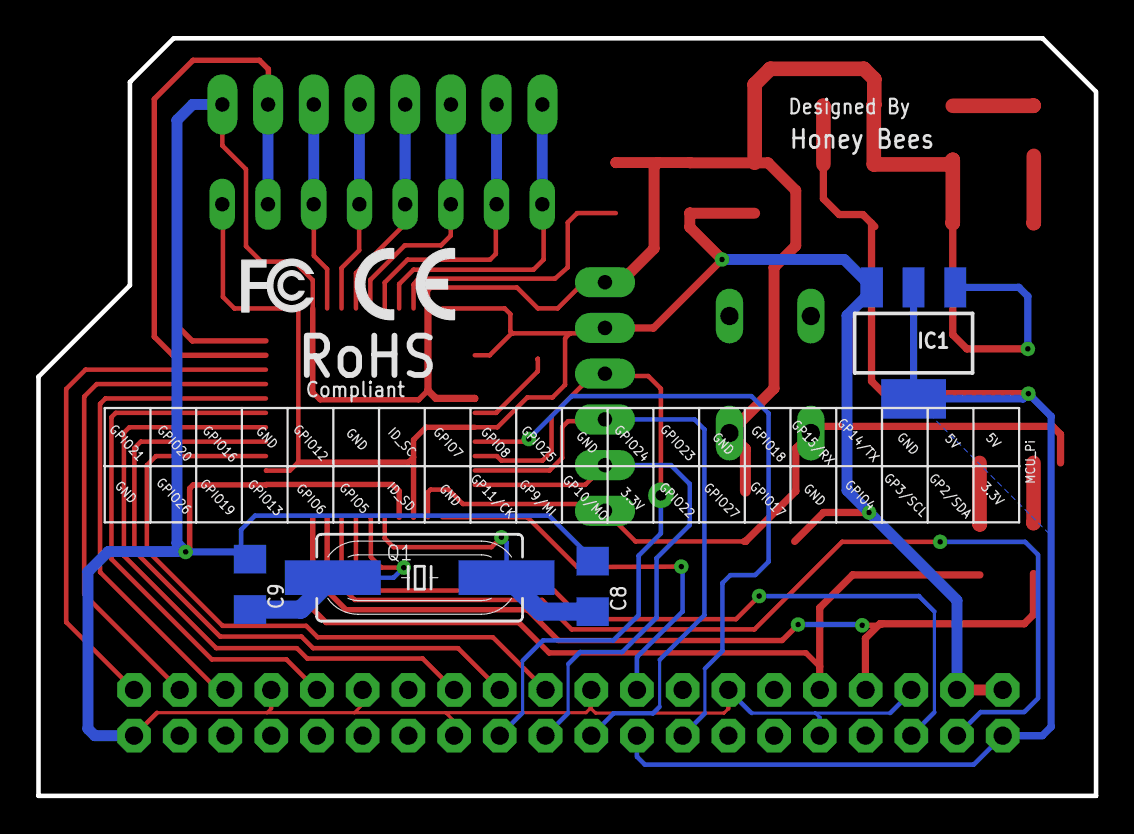
[picture p65: board PiMCU_Shield.brd from below]

Board: 2 copper layers, 58.8 x 42.1 mm, 25 parts (4 on the bottom side), 35 nets.

Other parts of the board:
U$4: CE-4MM
U$5: FCC_6.1X15MM
