nmaiti/smartswitchboard/Hardware/6ModuleBoard/6moduleboard.brd

## EAGLE design Hardware/6ModuleBoard/6moduleboard.brd (2015-07-10)

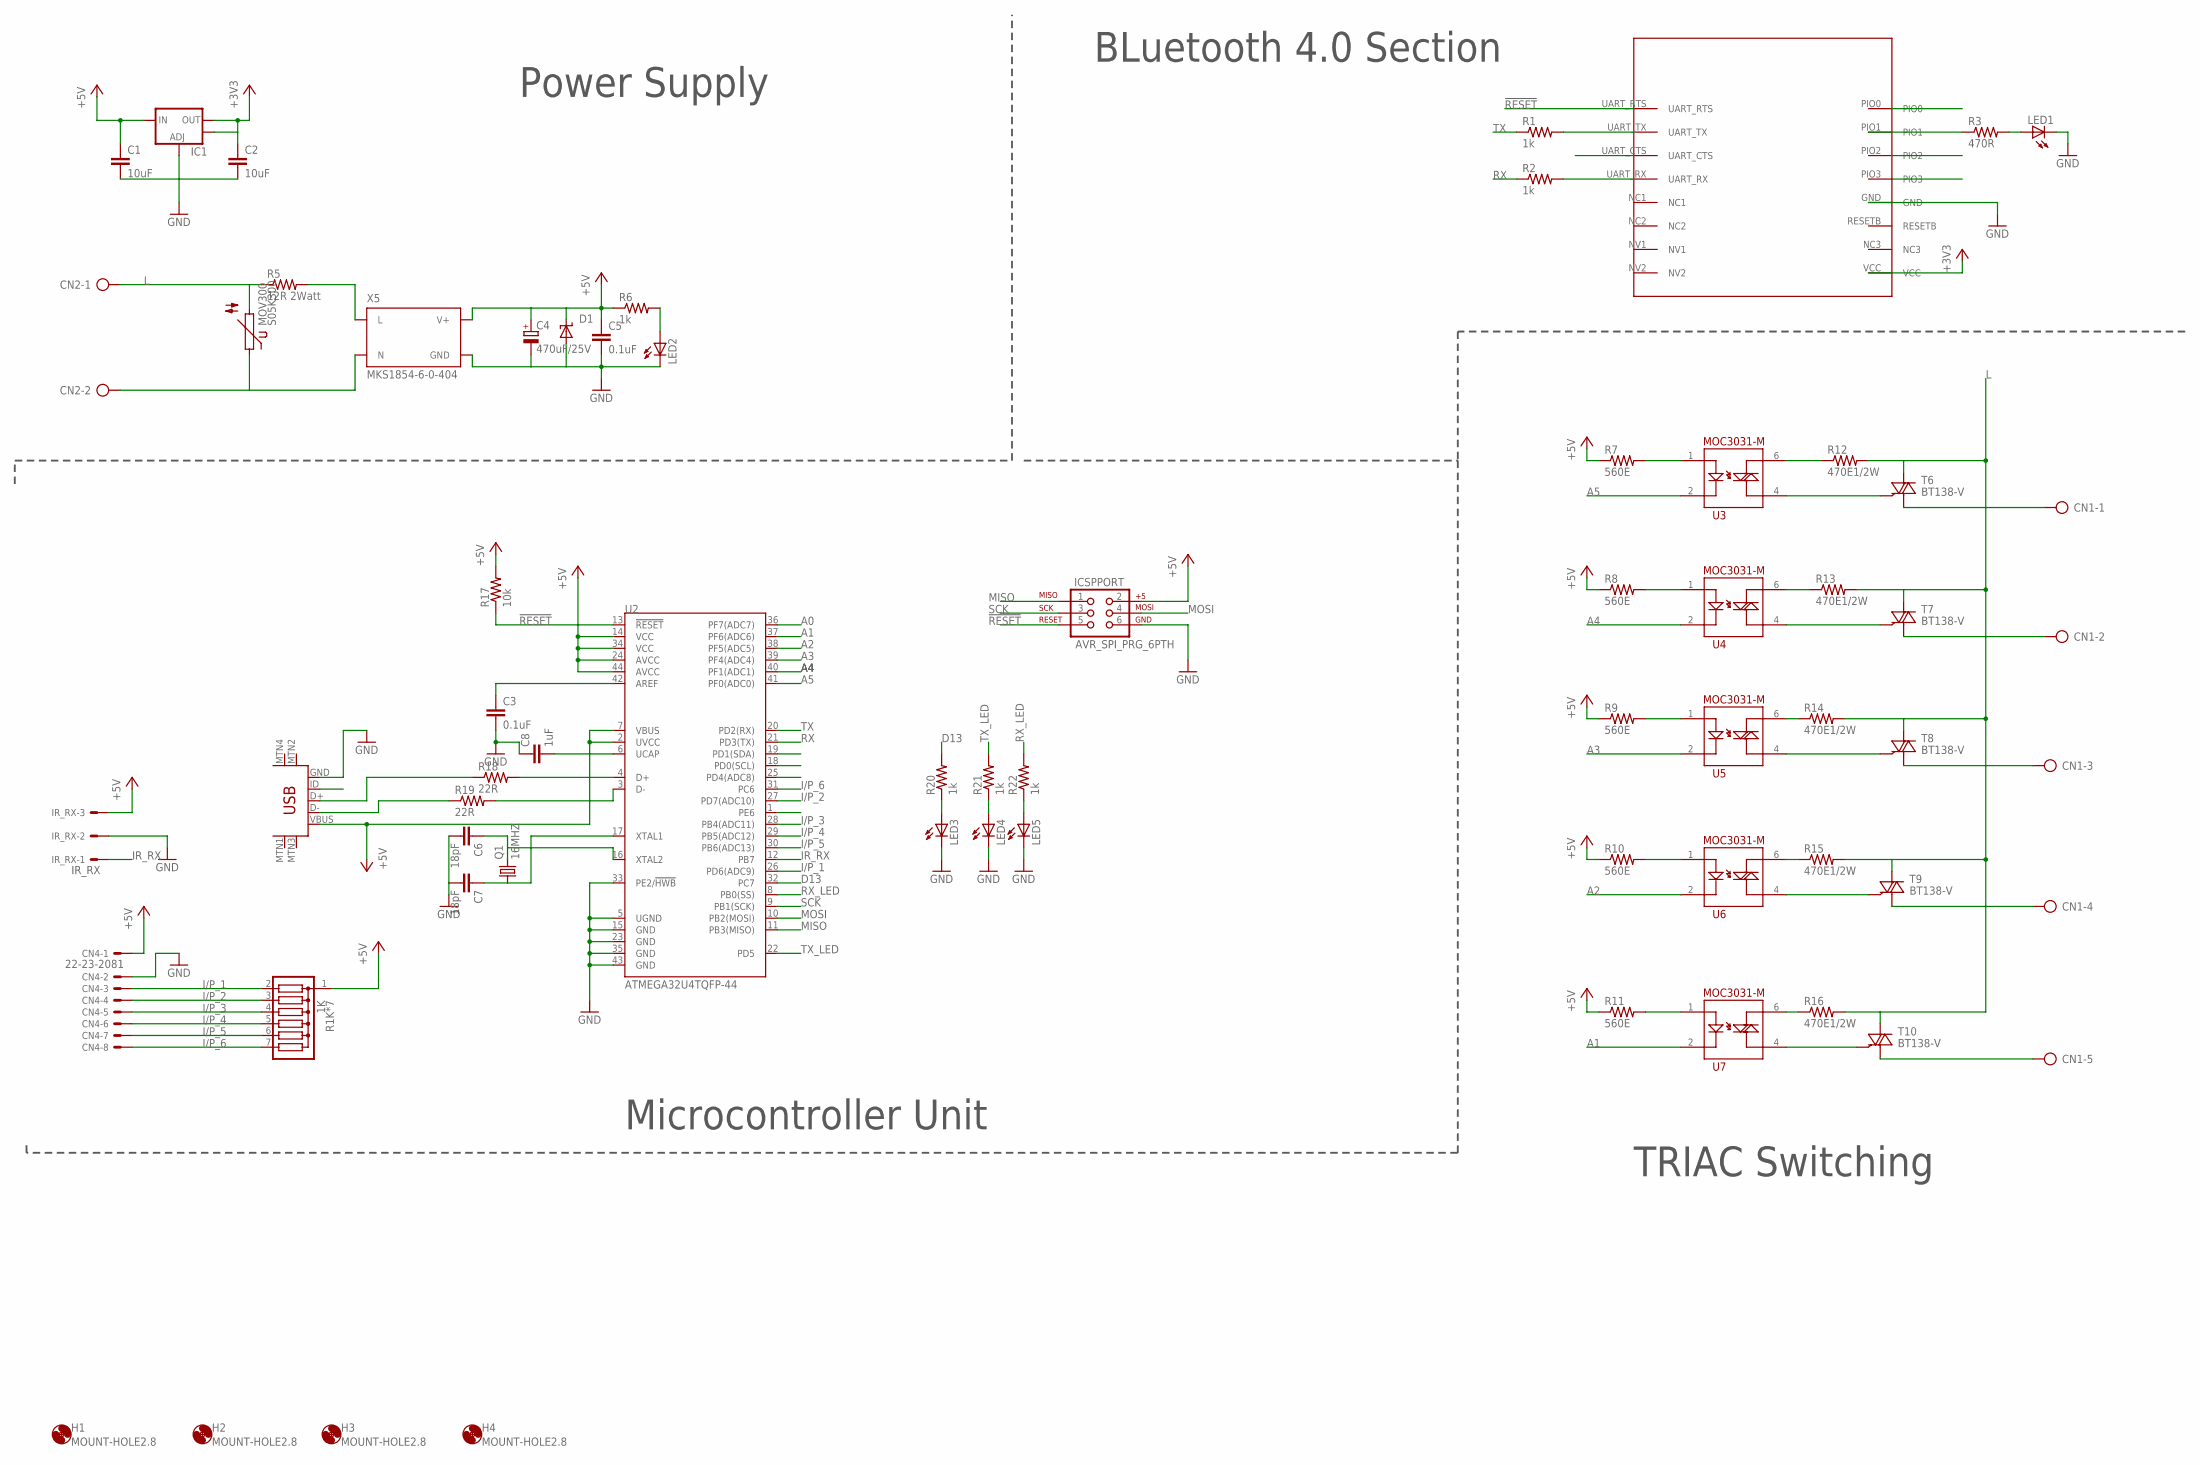
[picture p66: schematic 6moduleboard.sch]

Parts:
C1, C2: 10uF; 1206
C3, C5: 0.1uF; 1206
C4: 470uF/25V; E5-8,5
C6, C7: 18pF; 1206
C8: 1uF; 1206
CN1: AK300/5
CN2: AK300/2
CN4: 22-23-2081
D1: SUPPRESSOR-SMBJ; SMBJ
H1, H2, H3, H4: MOUNT-HOLE2.8; 2,8
IC1: V_REG_LM1117SOT223; SOT223
ICSPPORT: AVR_SPI_PRG_6PTH; 2X3
IR_RX: IR_RX; 22-23-2031
LED1, LED2, LED3, LED4, LED5: LEDSMT1206; 1206
MOV300: S05K300
Q1: 16MHZ; HC49UP
R1, R2, R6, R20, R21, R22: 1k; 1206
R1K*7: 1K; SIL7
R3: 470R; 1206
R5: 12R 2Watt; 0207/10
R7, R8, R9, R10, R11: 560E; 1206
R12, R13, R14, R15, R16: 470E1/2W; 0411V
R17: 10k; 1206
R18, R19: 22R; 1206
T6, T7, T8, T9, T10: BT138-V; TO220BV
U2: ATMEGA32U4TQFP-44; TQFP44
U3, U4, U5, U6, U7: MOC3083; DIL06
U8: USB-MINIB-5PIN; USB-MINIB
U$1: HM-11
X5: MKS1854-6-0-404

Connections:
!RESET: ICSPPORT.5, R17.1, U2.13 (!RESET), U$1.UART_RTS
+3V3: C2.1, IC1.2 (OUT), IC1.4 (OUT), U$1.VCC
+5V: C1.1, C4.+, C5.1, CN4.1, D1.C, IC1.3 (IN), ICSPPORT.2, IR_RX.3, R1K*7.1, R6.1, R7.1, R8.1, R9.1, R10.1, R11.1, R17.2, U2.2 (UVCC), U2.7 (VBUS), U2.14 (VCC), U2.24 (AVCC), U2.34 (VCC), U2.44 (AVCC), U8.VBUS, X5.3 (V+)
A0: U2.36 (PF7(ADC7))
A1: U2.37 (PF6(ADC6)), U7.2
A2: U2.38 (PF5(ADC5)), U6.2
A3: U2.39 (PF4(ADC4)), U5.2
A4: U2.40 (PF1(ADC1)), U4.2
A5: U2.41 (PF0(ADC0)), U3.2
D13: R20.2, U2.32 (PC7)
GND: C1.2, C2.2, C3.2, C4.-, C5.2, C6.2, C7.2, C8.1, CN4.2, D1.A, IC1.1 (ADJ), ICSPPORT.6, IR_RX.2, LED1.C, LED2.C, LED3.C, LED4.C, LED5.C, U2.5 (UGND), U2.15 (GND), U2.23 (GND), U2.33 (PE2/!HWB), U2.35 (GND), U2.43 (GND), U8.GND, U$1.GND, X5.4 (GND)
I/P_1: CN4.3, R1K*7.2, U2.26 (PD6(ADC9))
I/P_2: CN4.4, R1K*7.3, U2.27 (PD7(ADC10))
I/P_3: CN4.5, R1K*7.4, U2.28 (PB4(ADC11))
I/P_4: CN4.6, R1K*7.5, U2.29 (PB5(ADC12))
I/P_5: CN4.7, R1K*7.6, U2.30 (PB6(ADC13))
I/P_6: CN4.8, R1K*7.7, U2.31 (PC6)
IR_RX: IR_RX.1, U2.12 (PB7)
L: CN2.1, MOV300.2, R5.1, R12.2, R13.2, R14.2, R15.2, R16.2, T6.T2 (A2), T7.T2 (A2), T8.T2 (A2), T9.T2 (A2), T10.T2 (A2)
MISO: ICSPPORT.1, U2.11 (PB3(MISO))
MOSI: ICSPPORT.4, U2.10 (PB2(MOSI))
unnamed: R3.1, U$1.PIO1
unnamed: LED1.A, R3.2
unnamed: R5.2, X5.1 (L)
unnamed: CN2.2, MOV300.1, X5.2 (N)
unnamed: R1.2, U$1.UART_TX
unnamed: R2.2, U$1.UART_RX
unnamed: CN1.1, T6.T1 (A1)
unnamed: CN1.2, T7.T1 (A1)
unnamed: R7.2, U3.1
unnamed: R12.1, U3.6
unnamed: R8.2, U4.1
unnamed: LED2.A, R6.2
unnamed: R9.2, U5.1
unnamed: R10.2, U6.1
unnamed: R11.2, U7.1
unnamed: LED4.A, R21.1
unnamed: LED5.A, R22.1
unnamed: R13.1, U4.6
unnamed: R14.1, U5.6
unnamed: R15.1, U6.6
unnamed: R16.1, U7.6
unnamed: T6.G, U3.4
unnamed: T7.G, U4.4
unnamed: T8.G, U5.4
unnamed: C8.2, U2.6 (UCAP)
unnamed: T9.G, U6.4
unnamed: C3.1, U2.42 (AREF)
unnamed: T10.G, U7.4
unnamed: CN1.5, T10.T1 (A1)
unnamed: CN1.3, T8.T1 (A1)
unnamed: CN1.4, T9.T1 (A1)
unnamed: R18.2, U2.4 (D+)
unnamed: R19.2, U2.3 (D-)
unnamed: R18.1, U8.D+
unnamed: R19.1, U8.D-
unnamed: C6.1, Q1.2, U2.16 (XTAL2)
unnamed: C7.1, Q1.1, U2.17 (XTAL1)
unnamed: LED3.A, R20.1
RX: R2.1, U2.21 (PD3(TX))
RX_LED: R22.2, U2.8 (PB0(SS))
SCK: ICSPPORT.3, U2.9 (PB1(SCK))
TX: R1.1, U2.20 (PD2(RX))
TX_LED: R21.2, U2.22 (PD5)

Notes on the sheet:
Power Supply
BLuetooth 4.0 Section
Microcontroller Unit
TRIAC Switching

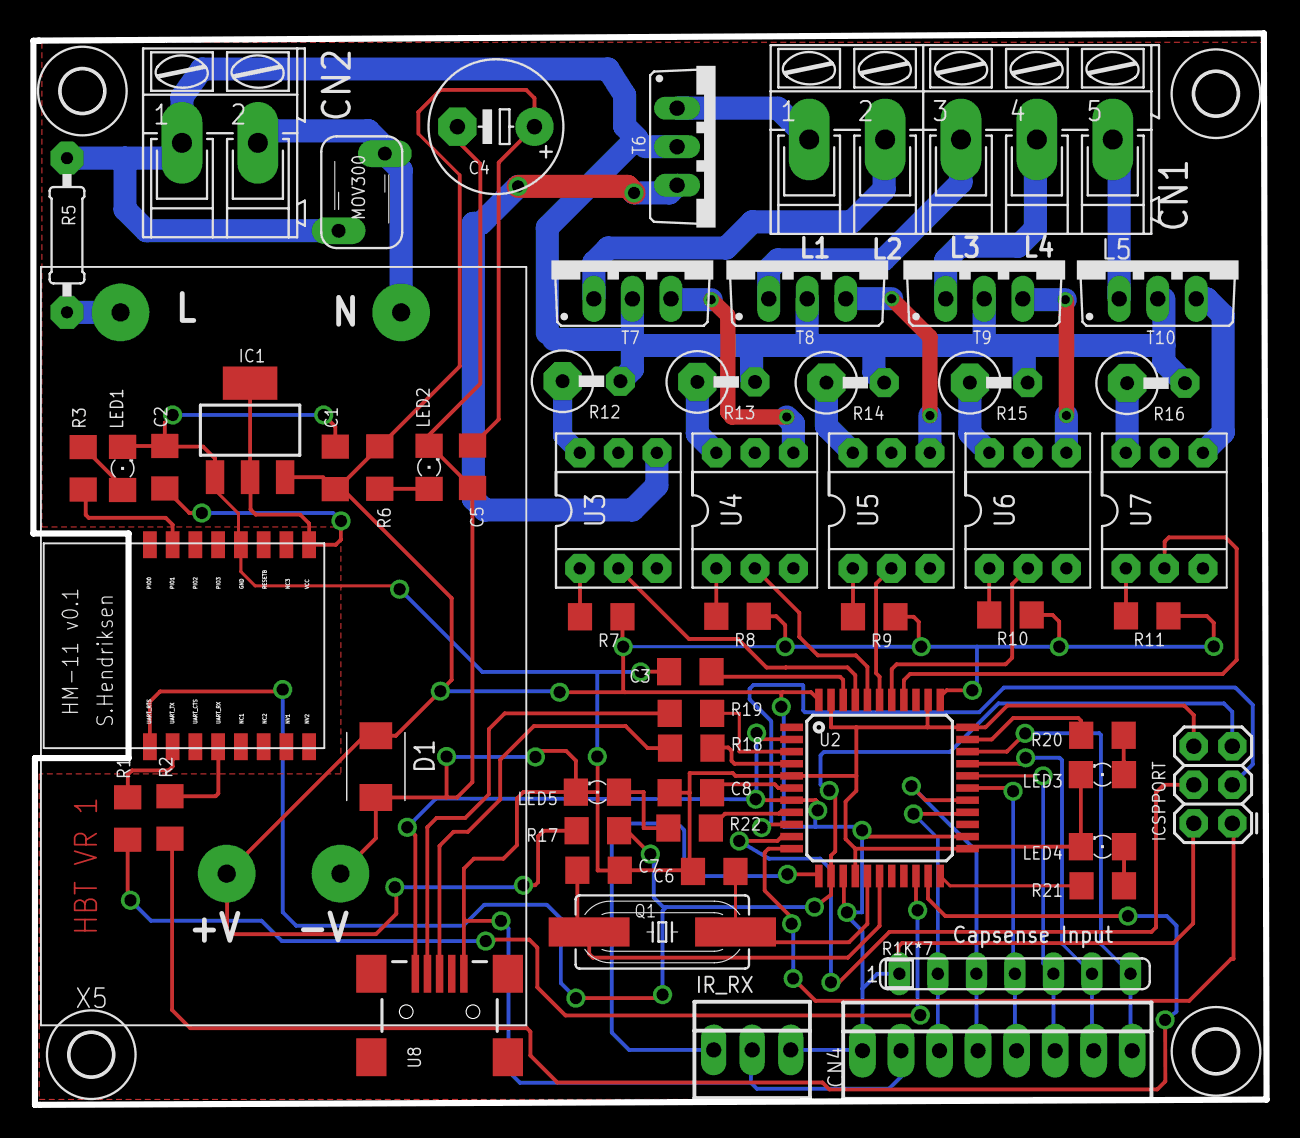
[picture p67: board 6moduleboard.brd from above]

Board: 2 copper layers, 81.3 x 70.6 mm, 62 parts (0 on the bottom side), 63 nets.
