nmaiti/smartswitchboard/Hardware/8ModuleBoard/8ModuleBoard.brd

## EAGLE design Hardware/8ModuleBoard/8ModuleBoard.brd (2015-10-31)

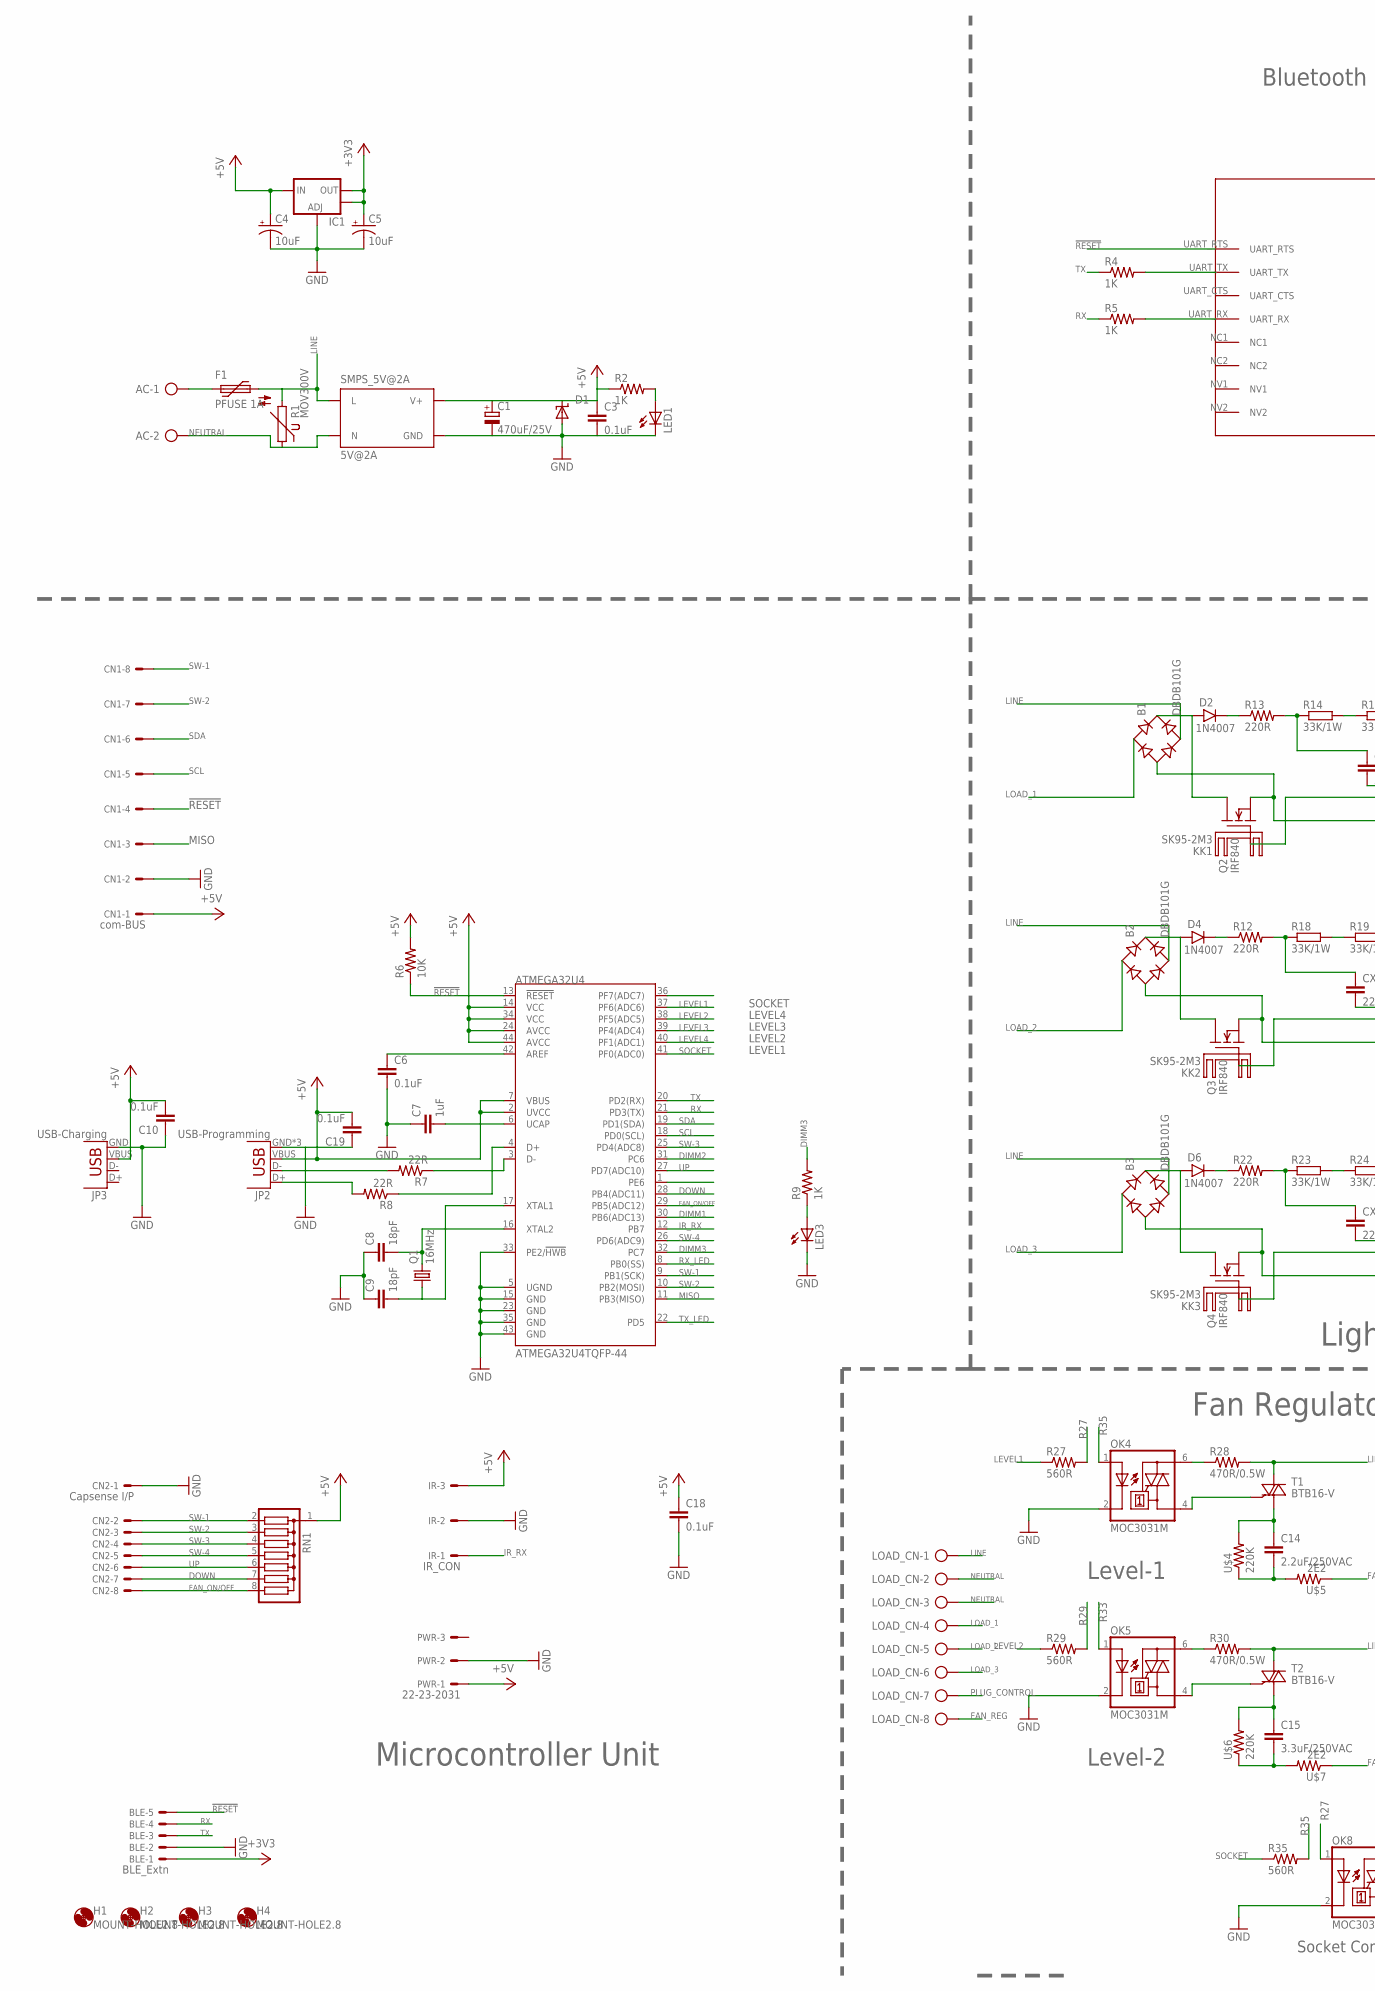
[picture p68: schematic 8ModuleBoard.sch, part in row 1, column 1]

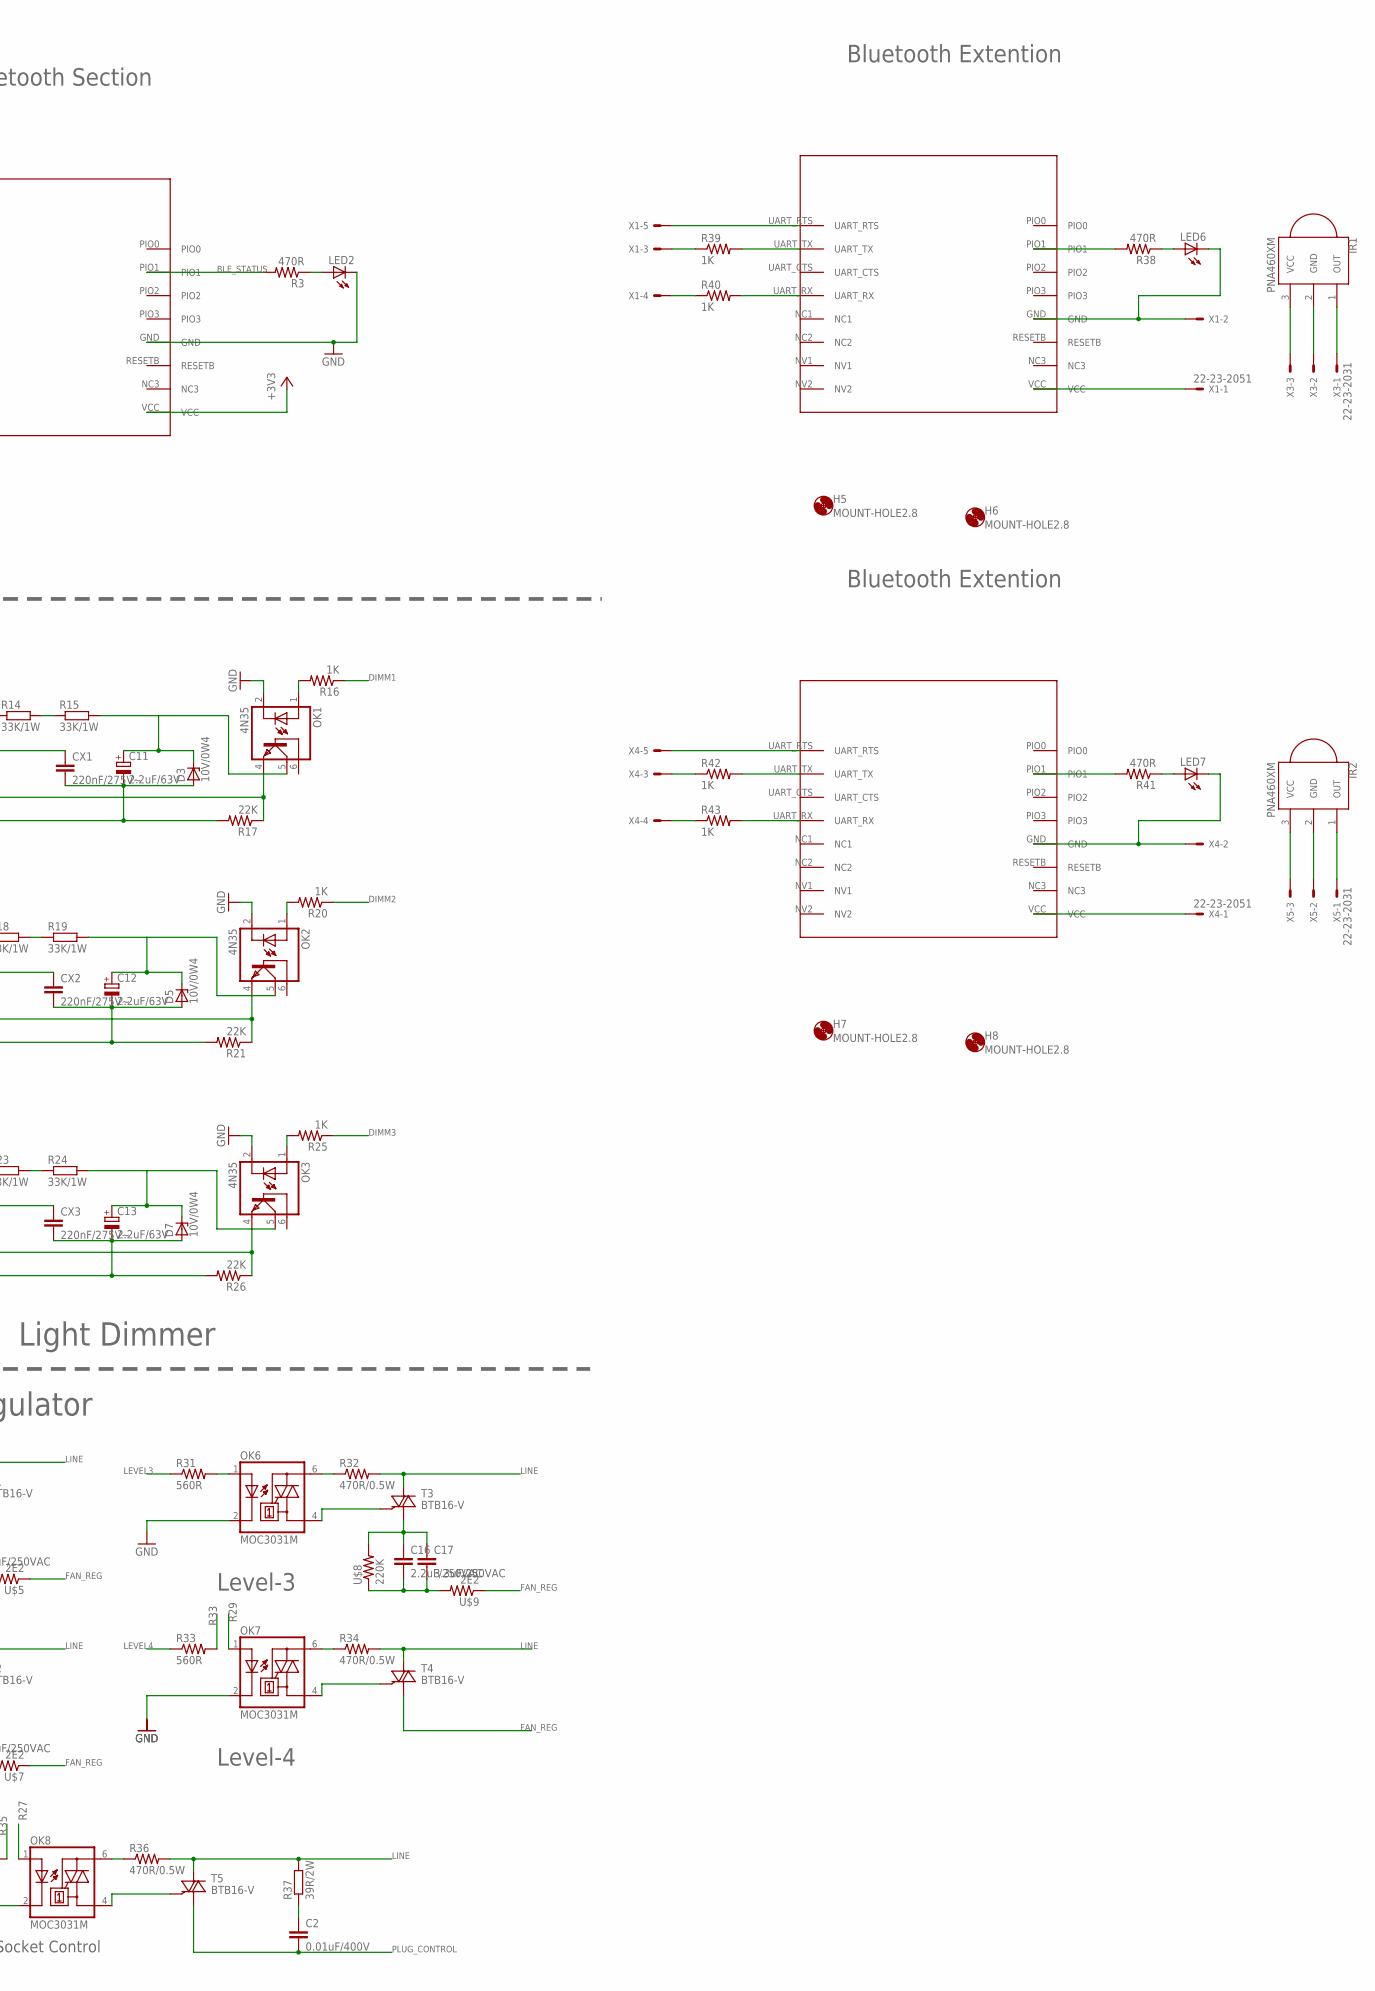
[picture p69: schematic 8ModuleBoard.sch, part in row 1, column 2]

Parts:
AC: AK300/2
ATMEGA32U4: ATMEGA32U4TQFP-44; TQFP44
B1, B2, B3: DBDB101G; DB
BLE: BLE_Extn; 22-23-2051
C1: 470uF/25V; E5-8,5
C2: 0.01uF/400V; C2.5-2
C3, C6, C10, C18, C19: 0.1uF; 1206
C4, C5: 10uF; EIA3216
C7: 1uF; 1206
C8, C9: 18pF; 1206
C11, C12, C13: 2.2uF/63V; E1,8-4
C14, C16: 2.2uF/250VAC; C27.5B9
C15, C17: 3.3uF/250VAC; C27.5B9
CN1: com-BUS; 22-23-2081
CN2: Capsense I/P; 22-23-2081
CX1, CX2, CX3: 220nF/275V~; XC15B5
D1: SUPPRESSOR-SMBJ; SMBJ
D2, D4, D6: 1N4007; DO41-1
D3, D5, D7: 10V/0W4; ZDIO-2.5
F1: PFUSE 1A; MF-5,1B
H1, H2, H3, H4, H5, H6, H7, H8: MOUNT-HOLE2.8; 2,8
IC1: V_REG_LM1117SOT223; SOT223
IR: IR_CON; 22-23-2031
IR1, IR2: PNA460XM
JP2: USB-Programming; USB-MICROB
JP3: USB-Charging; USB-A-H
KK1, KK2, KK3: SK95-2M3
LED1, LED2, LED3: LEDSML1206; SML1206
LED6, LED7: LEDSMT1206; 1206
LOAD_CN: AK300/8
OK1, OK2, OK3: 4N35; DIL06
OK4, OK5, OK6, OK7, OK8: MOC3031M; DIL06
PWR: 22-23-2031
Q1: 16MHz; HC49UP
Q2, Q3, Q4: IRF840; TO220
R1: MOV300V; S07K11
R2, R4, R5, R9, R16, R20, R25, R39, R40, R42, R43: 1K; 1206
R3, R38, R41: 470R; 1206
R6: 10K; 1206
R7, R8: 22R; 1206
R12, R13, R22: 220R; 1206
R14, R15, R18, R19, R23, R24: 33K/1W; 0411V
R17, R21, R26: 22K; 1206
R27, R29, R31, R33, R35: 560R; 1206
R28, R30, R32, R34, R36: 470R/0.5W; 0411V
R37: 39R/2W; 0411V
RN1: G07R; SIL8
SMPS_5V@2A: 5V@2A; MKS1854-6-0-404
T1, T2, T3, T4, T5: BTB16-V; TO220BV
U$1, U$3, U$11: HM-11
U$4, U$6, U$8: 220K; 1206
U$5, U$7, U$9: 2E2; 1206
X1, X4: 22-23-2051
X3, X5: 22-23-2031

Connections:
!RESET: ATMEGA32U4.13 (!RESET), BLE.5, CN1.4, R6.1, U$3.UART_RTS
+3V3: BLE.1, C5.A (+), IC1.2 (OUT), IC1.4 (OUT), U$3.VCC
+5V: ATMEGA32U4.2 (UVCC), ATMEGA32U4.7 (VBUS), ATMEGA32U4.14 (VCC), ATMEGA32U4.24 (AVCC), ATMEGA32U4.34 (VCC), ATMEGA32U4.44 (AVCC), C1.+, C3.1, C4.A (+), C10.2, C18.1, C19.2, CN1.1, D1.C, IC1.3 (IN), IR.3, JP2.VBUS, JP3.VBUS, PWR.1, R2.1, R6.2, RN1.1, SMPS_5V@2A.3 (V+)
BGND: IR1.2 (GND), LED6.C, U$1.GND, X1.2, X3.2
BLE_STATUS: R3.2, U$3.PIO1
CGND: IR2.2 (GND), LED7.C, U$11.GND, X4.2, X5.2
DIMM1: ATMEGA32U4.30 (PB6(ADC13)), R16.1
DIMM2: ATMEGA32U4.31 (PC6), R20.1
DIMM3: ATMEGA32U4.32 (PC7), R9.2, R25.1
DOWN: ATMEGA32U4.28 (PB4(ADC11)), CN2.7, RN1.7
FAN_ON/OFF: ATMEGA32U4.29 (PB5(ADC12)), CN2.8, RN1.8
FAN_REG: LOAD_CN.8, T4.T1 (A1), U$5.1, U$7.1, U$9.1
GND: ATMEGA32U4.5 (UGND), ATMEGA32U4.15 (GND), ATMEGA32U4.23 (GND), ATMEGA32U4.33 (PE2/!HWB), ATMEGA32U4.35 (GND), ATMEGA32U4.43 (GND), BLE.2, C1.-, C3.2, C4.C (-), C5.C (-), C6.2, C7.1, C8.1, C9.1, C10.1, C18.2, C19.1, CN1.2, CN2.1, D1.A, IC1.1 (ADJ), IR.2, JP2.GND, JP2.MT1 (GND), JP2.MT2 (GND), JP3.GND, LED1.C, LED2.C, LED3.C, OK1.2 (C), OK2.2 (C), OK3.2 (C), OK4.2 (C), OK5.2 (C), OK6.2 (C), OK7.2 (C), OK8.2 (C), PWR.2, SMPS_5V@2A.4 (GND), U$3.GND
IR_RX: ATMEGA32U4.12 (PB7), IR.1
LEVEL1: ATMEGA32U4.37 (PF6(ADC6)), R27.1
LEVEL2: ATMEGA32U4.38 (PF5(ADC5)), R29.1
LEVEL3: ATMEGA32U4.39 (PF4(ADC4)), R31.1
LEVEL4: ATMEGA32U4.40 (PF1(ADC1)), R33.1
LINE: B1.AC2, B2.AC2, B3.AC2, F1.2, LOAD_CN.1, R1.2, R28.2, R30.2, R32.2, R34.2, R36.2, R37.2, SMPS_5V@2A.1 (L), T1.T2 (A2), T2.T2 (A2), T3.T2 (A2), T4.T2 (A2), T5.T2 (A2)
LOAD_1: B1.AC1, LOAD_CN.4
LOAD_2: B2.AC1, LOAD_CN.5
LOAD_3: B3.AC1, LOAD_CN.6
MISO: ATMEGA32U4.11 (PB3(MISO)), CN1.3
unnamed: OK6.1 (A), R31.2
unnamed: B2.-, C12.-, CX2.2, D5.A, Q3.3 (S), R21.2
unnamed: R39.2, U$1.UART_TX
unnamed: R4.2, U$3.UART_TX
unnamed: LED3.A, R9.1
unnamed: ATMEGA32U4.6 (UCAP), C7.2
unnamed: LED2.A, R3.1
unnamed: ATMEGA32U4.42 (AREF), C6.1
unnamed: R5.2, U$3.UART_RX
unnamed: R40.2, U$1.UART_RX
unnamed: B1.-, C11.-, CX1.2, D3.A, Q2.3 (S), R17.2
unnamed: D2.C, R13.1
unnamed: LED1.A, R2.2
unnamed: JP2.D-, R7.2
unnamed: JP2.D+, R8.2
unnamed: ATMEGA32U4.3 (D-), R7.1
unnamed: ATMEGA32U4.4 (D+), R8.1
unnamed: CX1.1, R13.2, R14.1
unnamed: R14.2, R15.1
unnamed: ATMEGA32U4.16 (XTAL2), C8.2, Q1.2
unnamed: ATMEGA32U4.17 (XTAL1), C9.2, Q1.1
unnamed: OK1.1 (A), R16.2
unnamed: C11.+, D3.C, OK1.5 (COL), R15.2
unnamed: R38.2, U$1.PIO1
unnamed: C2.1, R37.1
unnamed: OK1.4 (EMI), Q2.1 (G), R17.1
unnamed: D4.C, R12.1
unnamed: CX2.1, R12.2, R18.1
unnamed: B1.+, D2.A, Q2.2 (D)
unnamed: R18.2, R19.1
unnamed: C12.+, D5.C, OK2.5 (COL), R19.2
unnamed: OK2.1 (A), R20.2
unnamed: AC.1, F1.1
unnamed: OK2.4 (EMI), Q3.1 (G), R21.1
unnamed: B2.+, D4.A, Q3.2 (D)
unnamed: LED6.A, R38.1
unnamed: U$1.UART_RTS, X1.5
unnamed: B3.-, C13.-, CX3.2, D7.A, Q4.3 (S), R26.2
unnamed: D6.C, R22.1
unnamed: CX3.1, R22.2, R23.1
unnamed: R23.2, R24.1
unnamed: C13.+, D7.C, OK3.5 (COL), R24.2
unnamed: OK3.1 (A), R25.2
unnamed: R40.1, X1.4
unnamed: OK3.4 (EMI), Q4.1 (G), R26.1
unnamed: B3.+, D6.A, Q4.2 (D)
unnamed: R39.1, X1.3
unnamed: OK4.6 (A2), R28.1
unnamed: OK4.4 (A1), T1.G
unnamed: C14.1, T1.T1 (A1), U$4.2
unnamed: C14.2, U$4.1, U$5.2
unnamed: U$1.VCC, X1.1
unnamed: OK5.6 (A2), R30.1
unnamed: IR1.1 (OUT), X3.1
unnamed: OK5.4 (A1), T2.G
unnamed: C15.1, T2.T1 (A1), U$6.2
unnamed: C15.2, U$6.1, U$7.2
unnamed: IR1.3 (VCC), X3.3
unnamed: OK6.6 (A2), R32.1
unnamed: OK6.4 (A1), T3.G
unnamed: C16.1, C17.1, T3.T1 (A1), U$8.2
unnamed: C16.2, C17.2, U$8.1, U$9.2
unnamed: OK7.6 (A2), R34.1
unnamed: OK7.4 (A1), T4.G
unnamed: OK8.6 (A2), R36.1
unnamed: OK8.4 (A1), T5.G
unnamed: R42.2, U$11.UART_TX
unnamed: R43.2, U$11.UART_RX
unnamed: R41.2, U$11.PIO1
unnamed: LED7.A, R41.1
unnamed: U$11.UART_RTS, X4.5
unnamed: R43.1, X4.4
unnamed: R42.1, X4.3
unnamed: U$11.VCC, X4.1
unnamed: IR2.1 (OUT), X5.1
unnamed: IR2.3 (VCC), X5.3
NEUTRAL: AC.2, LOAD_CN.2, LOAD_CN.3, R1.1, SMPS_5V@2A.2 (N)
PLUG_CONTROL: C2.2, LOAD_CN.7, T5.T1 (A1)
R27: OK8.1 (A), R27.2
R29: OK7.1 (A), R29.2
R33: OK5.1 (A), R33.2
R35: OK4.1 (A), R35.2
RX: ATMEGA32U4.21 (PD3(TX)), BLE.4, R5.1
RX_LED: ATMEGA32U4.8 (PB0(SS))
SCL: ATMEGA32U4.18 (PD0(SCL)), CN1.5
SDA: ATMEGA32U4.19 (PD1(SDA)), CN1.6
SOCKET: ATMEGA32U4.41 (PF0(ADC0)), R35.1
SW-1: ATMEGA32U4.9 (PB1(SCK)), CN1.8, CN2.2, RN1.2
SW-2: ATMEGA32U4.10 (PB2(MOSI)), CN1.7, CN2.3, RN1.3
SW-3: ATMEGA32U4.25 (PD4(ADC8)), CN2.4, RN1.4
SW-4: ATMEGA32U4.26 (PD6(ADC9)), CN2.5, RN1.5
TX: ATMEGA32U4.20 (PD2(RX)), BLE.3, R4.1
TX_LED: ATMEGA32U4.22 (PD5)
UP: ATMEGA32U4.27 (PD7(ADC10)), CN2.6, RN1.6

Notes on the sheet:
Bluetooth Section
Microcontroller Unit
Light Dimmer
Level-1
Level-2
Level-3
Level-4
Socket Control
Fan Regulator
Bluetooth Extention
SOCKET
LEVEL4
LEVEL3
LEVEL2
LEVEL1

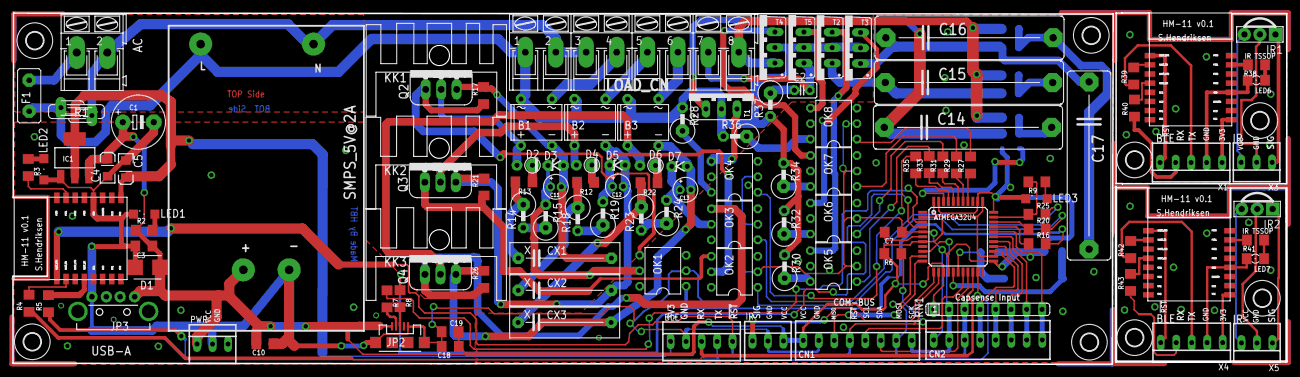
[picture p70: board 8ModuleBoard.brd from above]

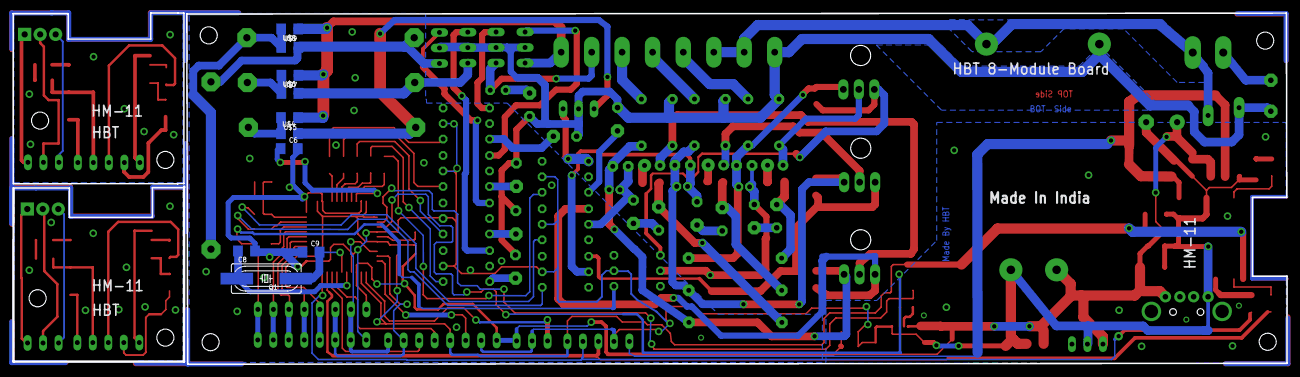
[picture p71: board 8ModuleBoard.brd from below]

Board: 2 copper layers, 180.3 x 57.6 mm, 135 parts (10 on the bottom side), 115 nets.
