nmaiti/smartswitchboard/Hardware/RF434/h-Remote.brd

## EAGLE design Hardware/RF434/h-Remote.brd (2015-12-22)

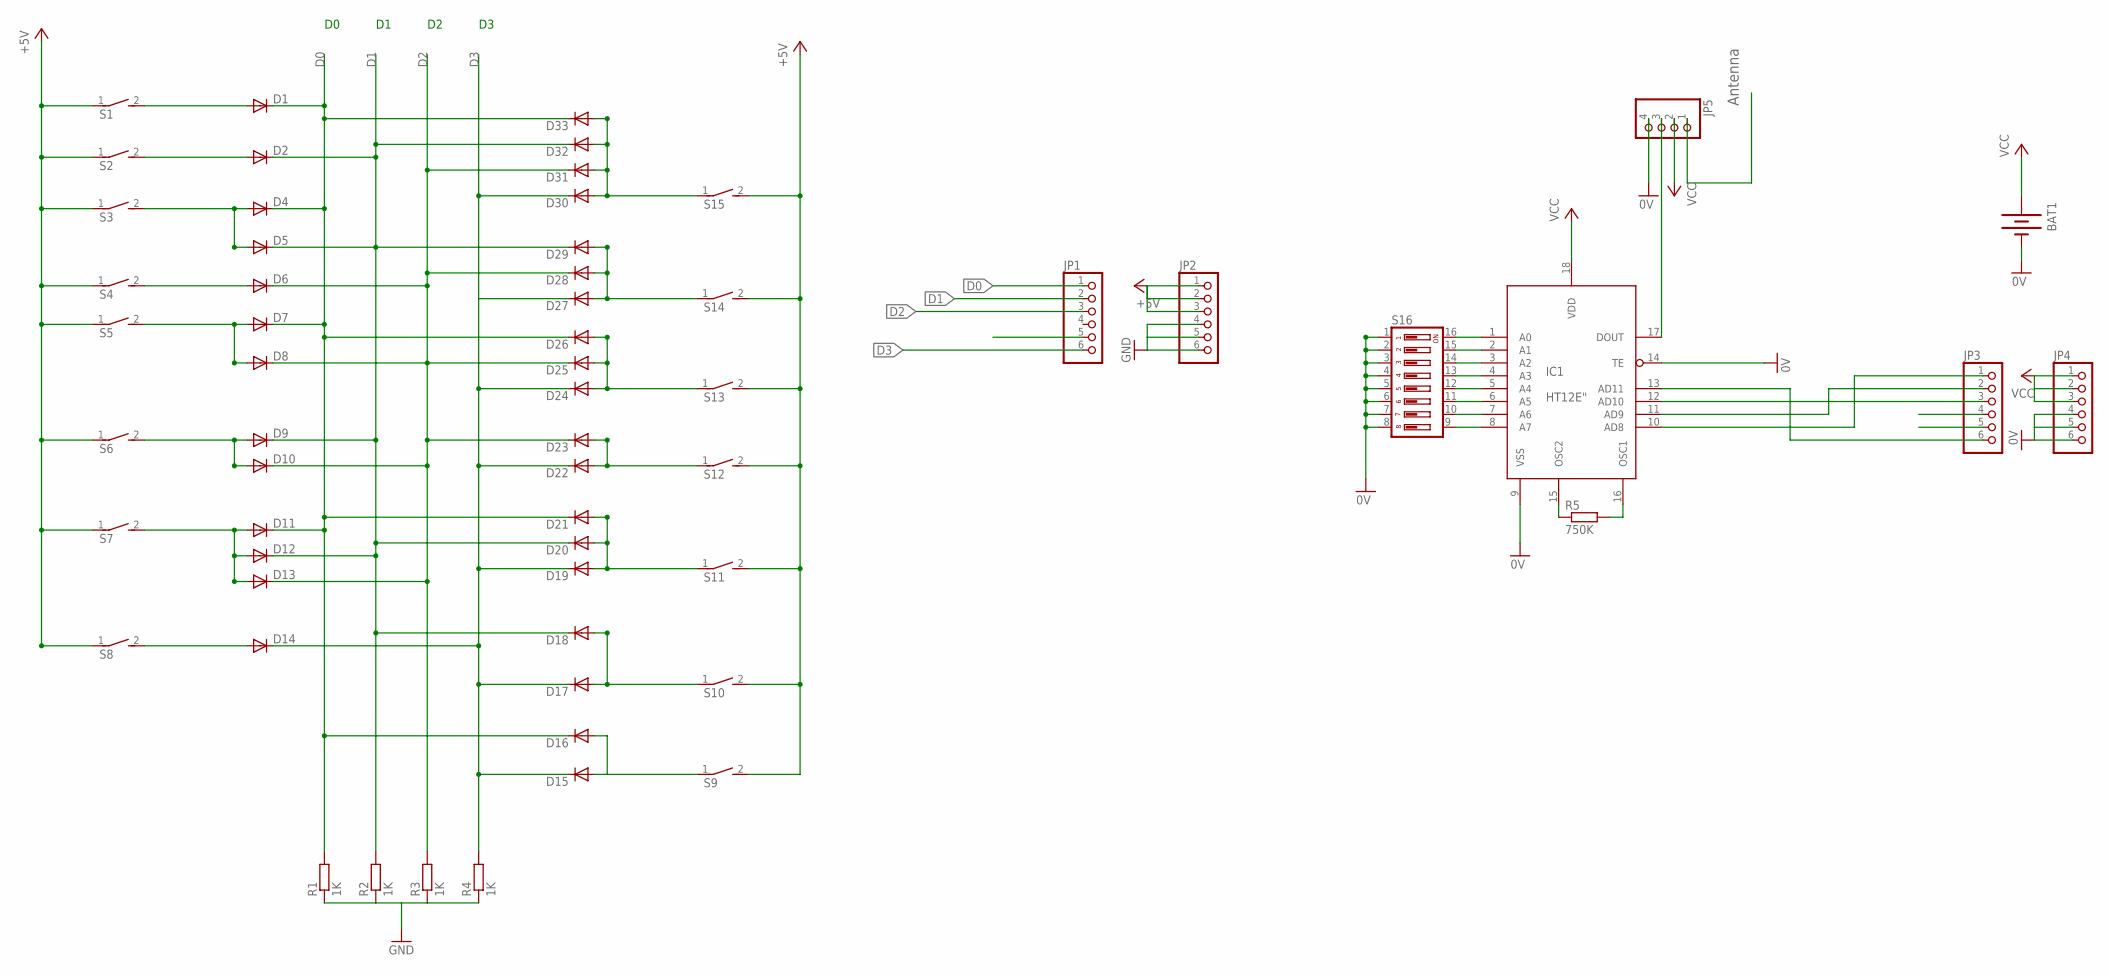
[picture p72: schematic h-Remote.sch]

Parts:
BAT1: BATTERY20PTH; BATTCOM_20MM_PTH
D1, D2, D4, D5, D6, D7, D8, D9, D10, D11, D12, D13, D14, D15, D16, D17, D18, D19, D20, D21, D22, D23, D24, D25, D26, D27, D28, D29, D30, D31, D32, D33: DIODE-MELF-MLL41; MELF-MLL41
IC1: HT12E"; 18-DIP-A
JP1, JP2, JP3, JP4: PINHD-1X6; 1X06
JP5: PINHD-1X4; 1X04
R1, R2, R3, R4: 1K; R1206
R5: 750K; 0207/10
S1, S2, S3, S4, S5, S6, S7, S8, S9, S10, S11, S12, S13, S14, S15: DS01E; DS-01
S16: DIP08YL

Connections:
0V: BAT1.2 (-), IC1.9 (VSS), IC1.14 (TE), JP4.4, JP4.5, JP4.6, JP5.4, S16.1, S16.2, S16.3, S16.4, S16.5, S16.6, S16.7, S16.8
+5V: JP2.1, JP2.2, JP2.3, S1.1, S2.1, S3.1, S4.1, S5.1, S6.1, S7.1, S8.1, S9.2, S10.2, S11.2, S12.2, S13.2, S14.2, S15.2
D0: D1.C, D4.C, D7.C, D11.C, D16.C, D21.C, D26.C, D33.C, JP1.1, R1.2
D1: D2.C, D5.C, D9.C, D12.C, D18.C, D20.C, D29.C, D32.C, JP1.2, R2.2
D2: D6.C, D8.C, D10.C, D13.C, D23.C, D25.C, D28.C, D31.C, JP1.3, R3.2
D3: D14.C, D15.C, D17.C, D19.C, D22.C, D24.C, D27.C, D30.C, JP1.6, R4.2
GND: JP2.4, JP2.5, JP2.6, R1.1, R2.1, R3.1, R4.1
unnamed: D7.A, D8.A, S5.2
unnamed: IC1.13 (AD11), JP3.6
unnamed: IC1.12 (AD10), JP3.3
unnamed: D2.A, S2.2
unnamed: IC1.11 (AD9), JP3.2
unnamed: D6.A, S4.2
unnamed: D4.A, D5.A, S3.2
unnamed: D1.A, S1.2
unnamed: D9.A, D10.A, S6.2
unnamed: D11.A, D12.A, D13.A, S7.2
unnamed: D14.A, S8.2
unnamed: D15.A, D16.A, S9.1
unnamed: D17.A, D18.A, S10.1
unnamed: D19.A, D20.A, D21.A, S11.1
unnamed: D22.A, D23.A, S12.1
unnamed: D24.A, D25.A, D26.A, S13.1
unnamed: D27.A, D28.A, D29.A, S14.1
unnamed: D30.A, D31.A, D32.A, D33.A, S15.1
unnamed: IC1.10 (AD8), JP3.1
unnamed: IC1.1 (A0), S16.16
unnamed: IC1.2 (A1), S16.15
unnamed: IC1.3 (A2), S16.14
unnamed: IC1.4 (A3), S16.13
unnamed: IC1.5 (A4), S16.12
unnamed: IC1.6 (A5), S16.11
unnamed: IC1.7 (A6), S16.10
unnamed: IC1.8 (A7), S16.9
unnamed: IC1.15 (OSC2), R5.1
unnamed: IC1.16 (OSC1), R5.2
unnamed: IC1.17 (DOUT), JP5.3
VCC: BAT1.1 (+), IC1.18 (VDD), JP4.1, JP4.2, JP4.3, JP5.2

Notes on the sheet:
Antenna

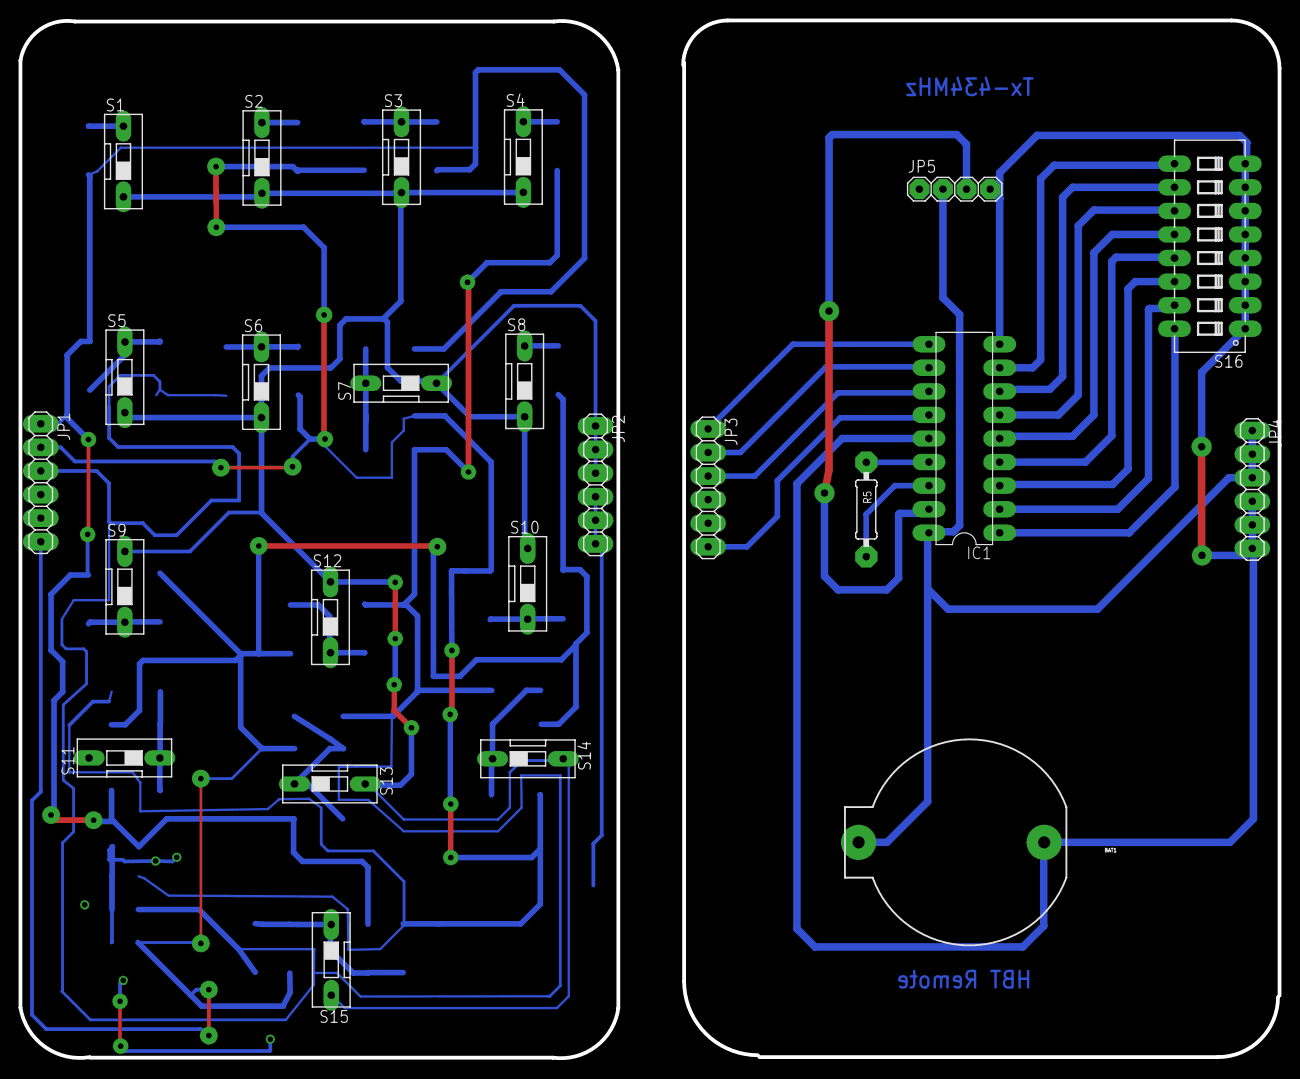
[picture p73: board h-Remote.brd from above]

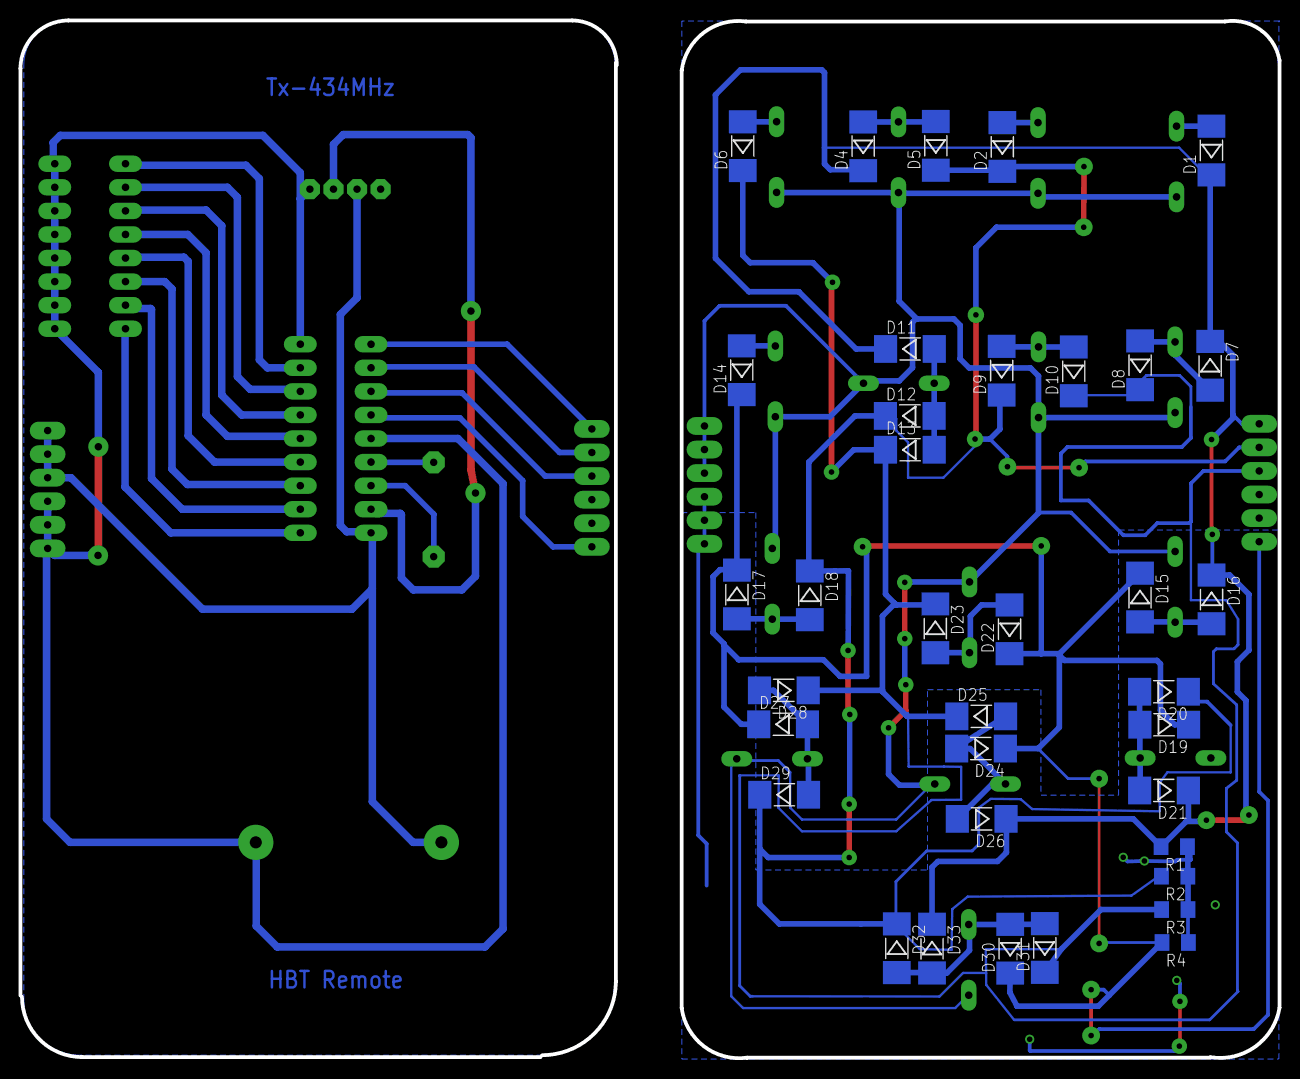
[picture p74: board h-Remote.brd from below]

Board: 2 copper layers, 64.4 x 111.8 mm, 60 parts (36 on the bottom side), 38 nets.
