nmaiti/smartswitchboard/Hardware/LedflikerremoverCct/ledflikerlessCct.brd

## EAGLE design Hardware/LedflikerremoverCct/ledflikerlessCct.brd (2015-12-22)

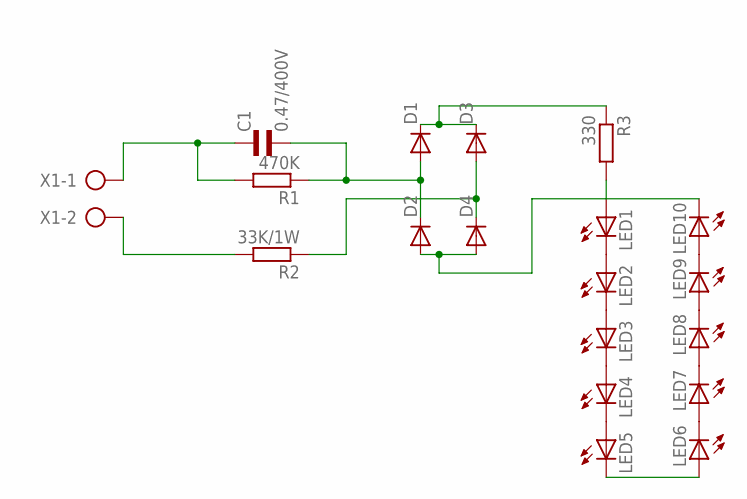
[picture p75: schematic ledflikerlessCct.sch]

Parts:
C1: 0.47/400V; EU25-10
D1, D2, D3, D4: DIODE-D-5; D-5
LED1, LED2, LED3, LED4, LED5, LED6, LED7, LED8, LED9, LED10: LEDP-LCC-2-BACK; P-LCC-2-TOPLED-RG
R1: 470K; 0207/10
R2: 33K/1W; 0411/15
R3: 330; R1206
X1: AK300/2

Connections:
unnamed: D1.C, D3.C, R3.1
unnamed: C1.2, D1.A, D2.C, R1.1
unnamed: D3.A, D4.C, R2.1
unnamed: LED1.C, LED2.A
unnamed: C1.1, R1.2, X1.1
unnamed: LED2.C, LED3.A
unnamed: R2.2, X1.2
unnamed: LED1.A, R3.2
unnamed: D2.A, D4.A, LED10.C
unnamed: LED3.C, LED4.A
unnamed: LED4.C, LED5.A
unnamed: LED6.C, LED7.A
unnamed: LED7.C, LED8.A
unnamed: LED8.C, LED9.A
unnamed: LED9.C, LED10.A
unnamed: LED5.C, LED6.A

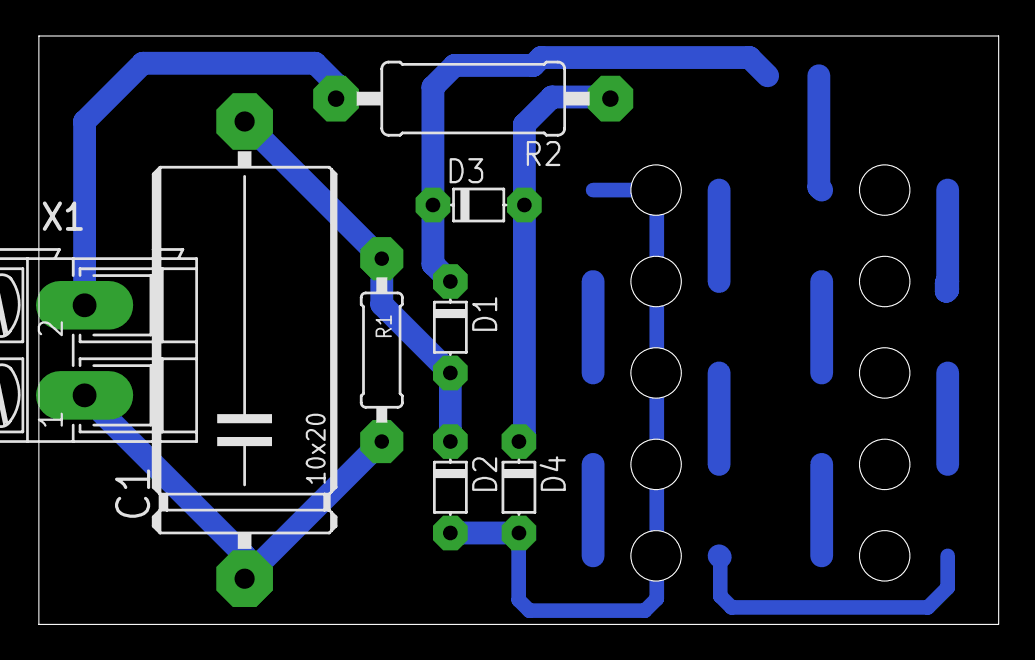
[picture p76: board ledflikerlessCct.brd from above]

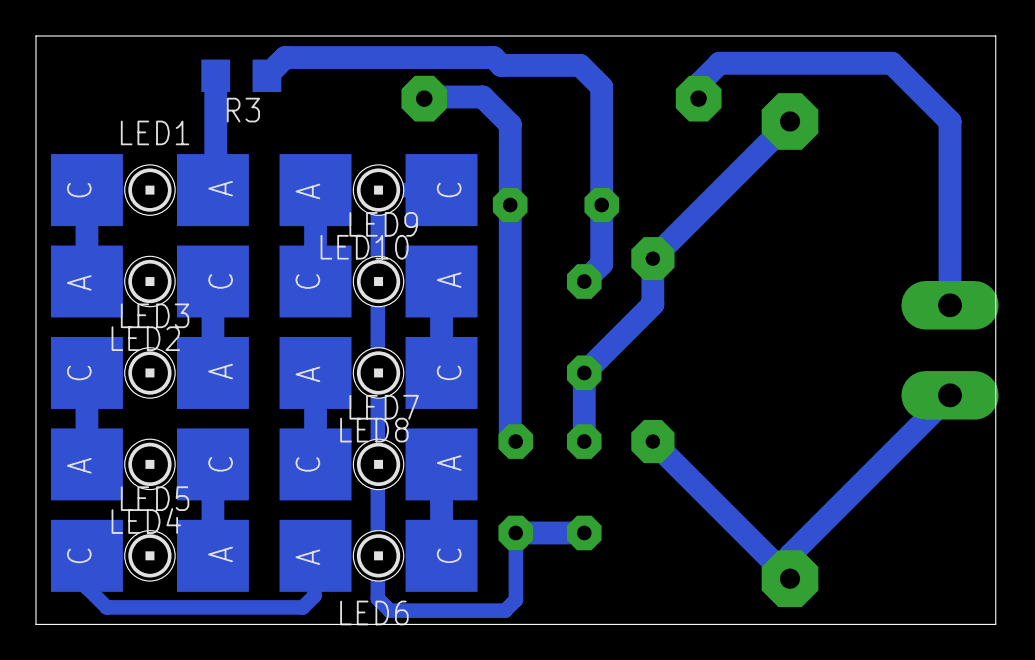
[picture p77: board ledflikerlessCct.brd from below]

Board: 2 copper layers, 53.3 x 32.7 mm, 19 parts (11 on the bottom side), 16 nets.
