nmaiti/smartswitchboard/Hardware/RFRemote/RFRemote.brd

## EAGLE design Hardware/RFRemote/RFRemote.brd (2015-12-22)

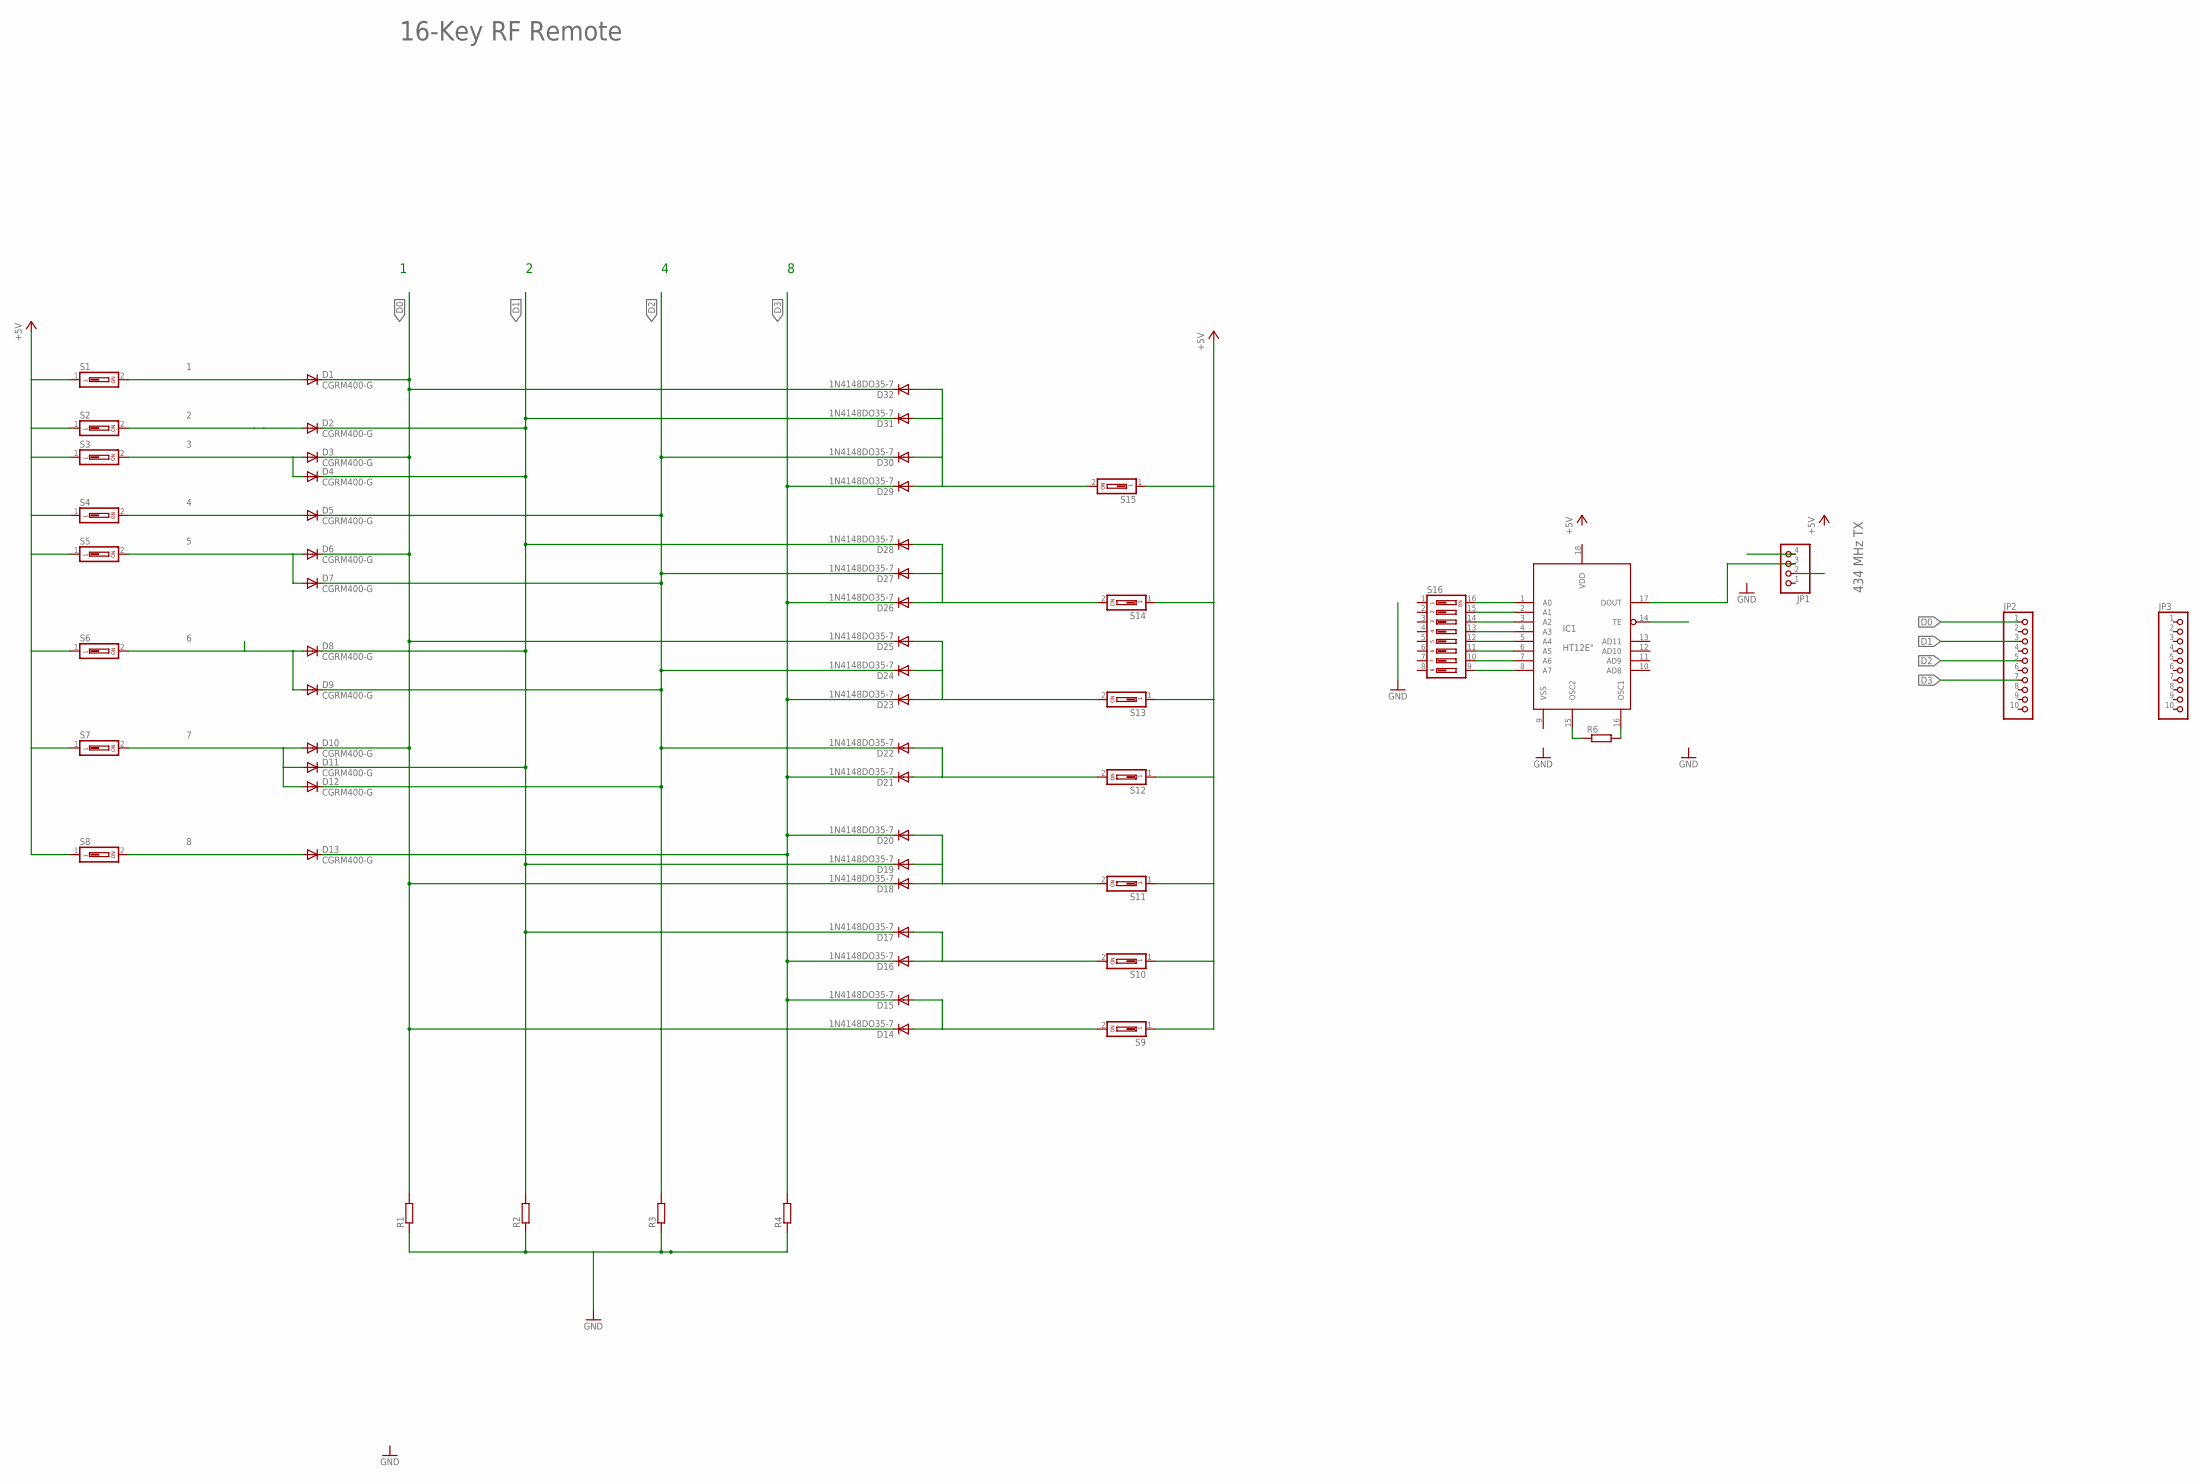
[picture p78: schematic RFRemote.sch]

Parts:
D1, D2, D3, D4, D5, D6, D7, D8, D9, D10, D11, D12, D13: CGRM400-G; MELF-MLL41
D14, D15, D16, D17, D18, D19, D20, D21, D22, D23, D24, D25, D26, D27, D28, D29, D30, D31, D32: 1N4148DO35-7; MELF-MLL41
IC1: HT12E"; 18-DIP-A
JP1: PINHD-1X4; 1X04
JP2, JP3: PINHD-1X10; 1X10
R1, R2, R3, R4: R-EU_R1206; R1206
R6: R-EU_0207/10; 0207/10
S1, S2, S3, S4, S5, S6, S7, S8, S9, S10, S11, S12, S13, S14, S15: SD4-01
S16: DIP08YL

Connections:
1: D1.A, S1.2
2: D2.A, S2.2
3: D3.A, D4.A, S3.2
4: D5.A, S4.2
5: D6.A, D7.A, S5.2
6: D8.A, D9.A, S6.2
7: D10.A, D11.A, D12.A, S7.2
8: D13.A, S8.2
+5V: S1.1, S2.1, S3.1, S4.1, S5.1, S6.1, S7.1, S8.1, S9.1, S10.1, S11.1, S12.1, S13.1, S14.1, S15.1
D0: D1.C, D3.C, D6.C, D10.C, D14.C, D18.C, D25.C, D32.C, JP2.1, R1.2
D1: D2.C, D4.C, D8.C, D11.C, D17.C, D19.C, D28.C, D31.C, JP2.3, R2.2
D2: D5.C, D7.C, D9.C, D12.C, D22.C, D24.C, D27.C, D30.C, JP2.5, R3.2
D3: D13.C, D15.C, D16.C, D20.C, D21.C, D23.C, D26.C, D29.C, JP2.7, R4.2
GND: R1.1, R2.1, R3.1, R4.1
unnamed: IC1.17 (DOUT), JP1.3
unnamed: D14.A, D15.A, S9.2
unnamed: D16.A, D17.A, S10.2
unnamed: D18.A, D19.A, D20.A, S11.2
unnamed: D21.A, D22.A, S12.2
unnamed: D23.A, D24.A, D25.A, S13.2
unnamed: D26.A, D27.A, D28.A, S14.2
unnamed: D29.A, D30.A, D31.A, D32.A, S15.2
unnamed: IC1.16 (OSC1), R6.2
unnamed: IC1.8 (A7), S16.9
unnamed: IC1.7 (A6), S16.10
unnamed: IC1.6 (A5), S16.11
unnamed: IC1.5 (A4), S16.12
unnamed: IC1.4 (A3), S16.13
unnamed: IC1.3 (A2), S16.14
unnamed: IC1.2 (A1), S16.15
unnamed: IC1.1 (A0), S16.16
unnamed: IC1.15 (OSC2), R6.1
TE: IC1.14 (TE)
VDD: IC1.18 (VDD)

Notes on the sheet:
16-Key RF Remote
434 MHz TX

Board: 2 copper layers, 57 parts (36 on the bottom side), 32 nets, no tracks yet.
