nmaiti/smartswitchboard/(commit log)

2015-05-01 Added protype of Capsense Eagle Board files
    [capsenseboard.brd, capsenseboard.sch]
2015-07-10 Added New Hardware and Firmware files
    [6moduleboard.brd, 6moduleboard.sch, BOM_6moduleboard.csv, CapsenseBOM.xlsx, DRILEGEND.CFG, capsenseboard.brd]
2015-07-25 Updated Hardware Design files with Fan regulator and Power supply cct.
    [ACtoDCconvtr.brd, ACtoDCconvtr.sch, FanRegulator.brd, FanRegulator.sch]
2015-08-05 Updated BOM
    [CapsenseBOM.xlsx, CompInStock.xlsx]
2015-08-11 updated the Hardware files
    [8ModuleBoard.brd, 8ModuleBoard.sch, TriacDimmer.brd, TriacDimmer.sch]
2015-09-30 Updated the Hardware and software drives
    [2ModuleBoard.brd, 2ModuleBoard.sch, 8ModuleBoard.sch, CompInStock.xlsx]
2015-10-31 Updated the Hardware and software files
    [4key1SliderCapsenseDesign.brd, 4key1SliderCapsenseDesign.sch, 8ModuleBoard.brd]
2015-12-22 Updated the Hardware Files with Vr2
    [4key1SliderCapsenseDesign.brd, 4key1SliderCapsenseDesign.sch, 8ModuleBoard_vr2.brd, 8ModuleBoard_vr2.sch, RFRemote.brd, RFRemote.sch, h-Remote.brd, h-Remote.sch]
2016-01-11 Updated with Vr2 of Switchboard
    [8ModuleBoard_vr2.brd, 8ModuleBoard_vr2.sch]
2016-01-29 Updated with 8 Module Relay Board Design
    [8ModuleBoard_vr2.brd, 8ModuleBoard_vr2.sch, 8ModuleFinal.brd]
2016-02-09 Updated with 8keyRelayModule firmware files
    [8ModuleBoard_vr2.sch, CompInStock.xlsx]
2016-02-23 Updated the Relay module firmware
    [8ModuleBoard_vr2.brd, 8ModuleBoard_vr2.sch]
2016-08-02 Created Rpi Compatible MCU board
    [PiMCU_Shield.brd, PiMCU_Shield.sch]
2016-08-02 Modified 8ModuleBoard_vr2 files
    [8ModuleBoard_vr2.sch]
2016-08-02 Added SMPS hardware and Gerber details
    [FG84.PCB, SMPS_BOM.xlsx]
2016-08-02 Added Drill file
    [8ModuleBoard_vr2.drl]
2016-08-02 Added Proto Board Design files
    [autocadview.dxf, untitled.brd, untitled.sch]
2016-08-19 updated with latest changes in hardware and software files
    [2ModuleBoard.brd, 2ModuleBoard.sch, 4key1SliderCapsenseDesign.brd, 4key1SliderCapsenseDesign.sch, 6moduleboard.brd, 6moduleboard.sch, 8ModuleBoard.brd, 8ModuleBoard.sch]
2016-08-25 Added RF support in software
    [2ModuleBoard.brd, 2ModuleBoard.sch, 4key1SliderCapsenseDesign.brd, 4key1SliderCapsenseDesign.sch, 6moduleboard.brd, 6moduleboard.sch, 8ModuleBoard.brd, 8ModuleBoard.sch]
2016-08-30 sync all software and hardware files
    [2ModuleBoard.brd, 2ModuleBoard.sch, 4key1SliderCapsenseDesign.brd, 4key1SliderCapsenseDesign.sch, 6moduleboard.brd, 6moduleboard.sch, 8ModuleBoard.brd, 8ModuleBoard.sch]
2016-12-16 generated board pdf file
2016-12-16 modified BOM file
2016-12-16 included SMPS gerber files
2016-12-16 updated gerber data of Pi_MCU_backend board
2016-12-16 modified .brd file
    [pi_mcu_powerBoard.brd]
2016-12-16 modified .sch file
    [pi_mcu_powerBoard.sch]
2016-12-16 removed case(555): ble on connect response code , no need to implemnt it
